philipmcgaw-cpi/CIB/620060_DIA10_V01.jpg

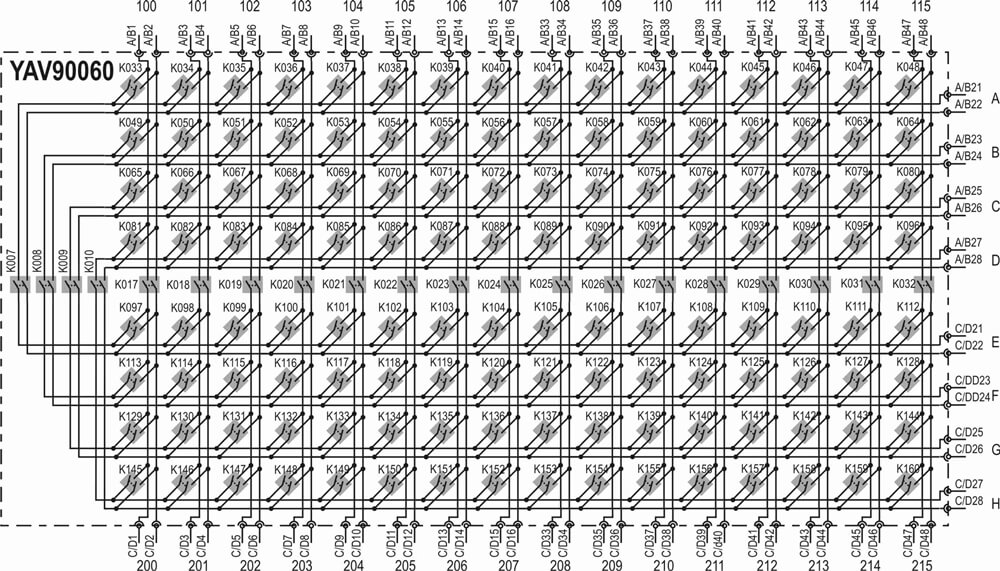
620060_DIA10_V01.jpg
