philipmcgaw-cpi/CIB/FDC_FCT_PVT_Specification_Diagrams - Top Level Block.jpeg

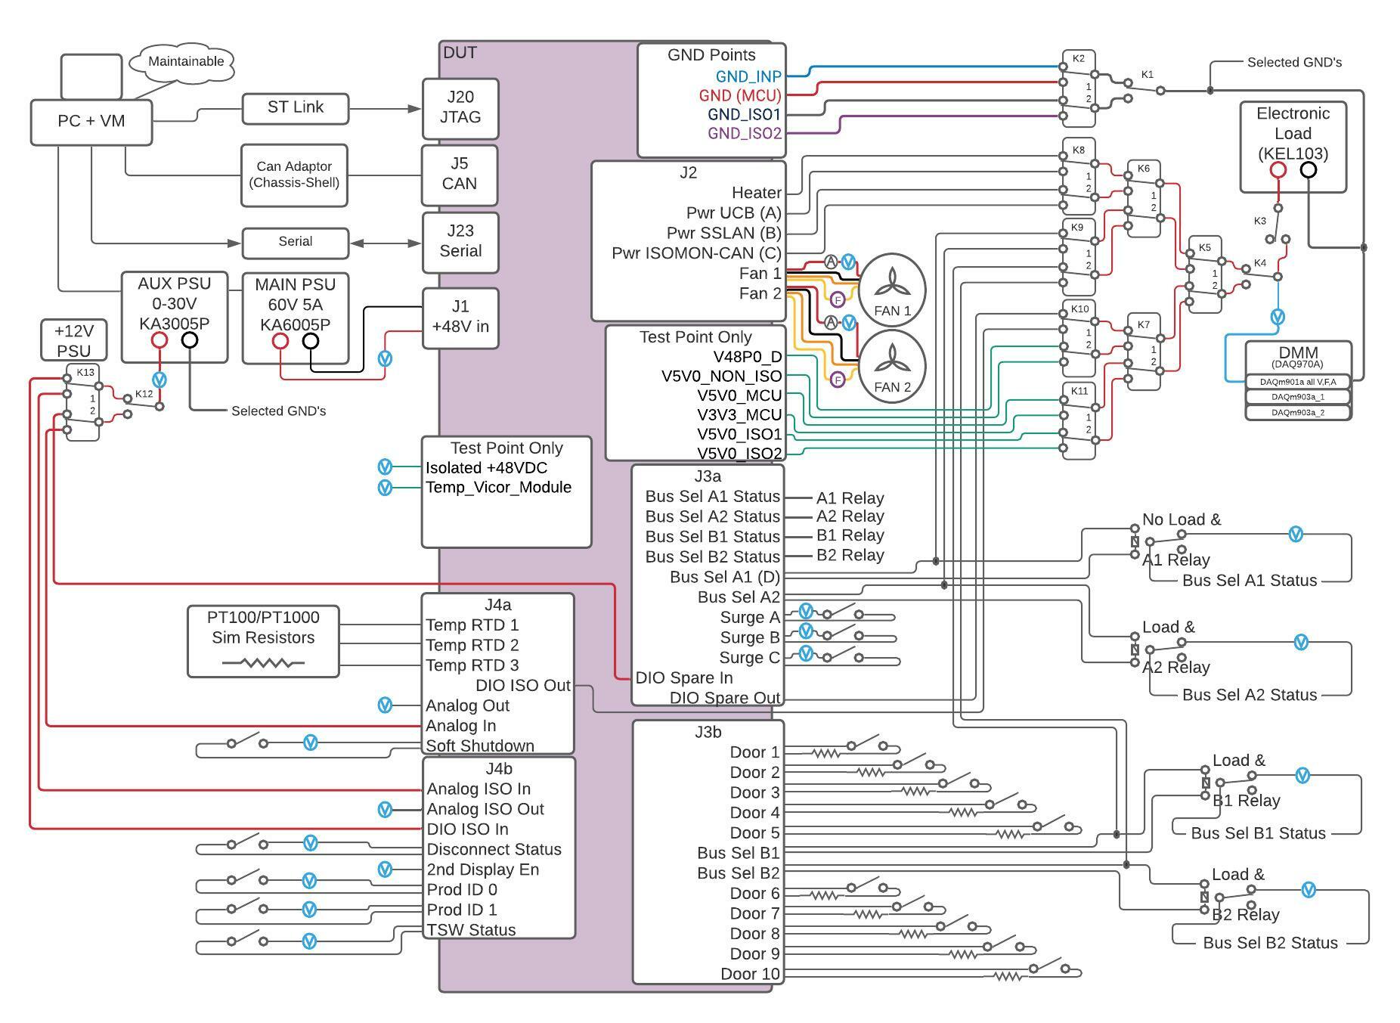
FDC_FCT_PVT_Specification_Diagrams - Top Level Block.jpeg
