philipmcgaw-cpi/CIB/CIB_Main_PCB - Mimic Octopus/Bom.xlsx

 | Manufacturer | Mfg part # | Digi-Key | Price approx | Quantitity |  | RS | Price Approx
12 Position headerblock, 5 mm pitch 90 degree PCB mount (20A) | Wurth | 691312710012 | 732-691312710012-ND | £1.78 | 8 | £14.24
12 Position headerblock, 5 mm pitch Screw terminal (20A) | Wurth | 691352710012 | 732-691352710012-ND | £5.23 | 8 | £41.84
12 Position Terminal Block Header, Male Pins, Shrouded (4 Side) 0.098" (2.50mm) 90°, Right Angle - Through Hole (12A) | Wurth | 691382010012 | 732-691382010012-ND | £2.87 |  | £0.00
12 Position Terminal Block Plug, Female Sockets 0.098" (2.50mm) - 180° Free Hanging (In-Line) (12A) | Wurth | 691381000012 | 732-691381000012-ND | £9.20 |  | £0.00
 |  |  |  |  |  | £0.00
LabJack OEM | LabJack |  |  | £500.00 | 1 | £500.00
 |  |  |  |  |  | £0.00
12V dc Coil Non-Latching Relay DPDT, 2A Switching Current PCB Mount, 2 Pole, HFD27/012-H | Hongfa Europe GMBH | HFD27/012-H |  |  |  | £0.00 | 176-2915 | £1.74
12V dc Coil Non-Latching Relay DPDT, 10A Switching Current Plug In, 2 Pole, MY2N 12DC(S) | Omron | MY2N 12DC(S) |  |  |  | £0.00 | 488-1954 | £6.60
 |  |  |  |  |  | £0.00
48V dc Coil Non-Latching Relay 4PDT, 6A Switching Current Plug In, 4 Pole, PT570048 8-1419111-1 | TE Connectivity | PT570048 8-1419111-1 |  |  |  | £0.00 | 334-0036 | £3.70
Relay Socket for use with PT5 Series 14 Pin, DIN Rail, 240V ac | TE Connectivity | PT78740 4-1415033-1 |  |  |  | £0.00 | 511-7018 | £7.25
 |  |  |  |  |  | £0.00
General Purpose Relay DPDT (2 Form C) 12VDC Coil Through Hole (2A) | CIT Relay and Switch | J104D2C12VDC.15S | 2449-J104D2C12VDC.15S-ND | £1.10 | 10 | £11.00
General Purpose Relay SPDT (1 Form C) 48VDC Coil Through Hole (12A) | CIT Relay and Switch | J107F1CS1248VDC.80 | 2449-J107F1CS1248VDC.80-ND | £1.30 | 4 | £5.20
 |  |  |  |  |  | £0.00
General Purpose Relay DPDT (2 Form C) 12VDC Coil Through Hole (16A) | Picker Components | PC375-2C-12S4-X | 2634-PC375-2C-12S4-X-ND | £2.40 | 20 | £48.00
 |  |  |  |  |  | £0.00
Bipolar (BJT) Transistor Array 8 NPN Darlington 50V 500mA - 2.25W Through Hole 18-DIP | STMicroelectronics | ULN2803A | 497-2356-5-ND | £2.58 |  | £0.00
I/O Expander 16 I²C 3.4 MHz 28-SPDIP | Microchip Technology | MCP23018-E/SP | MCP23018-E/SP-ND | £1.94 |  | £0.00
 |  |  |  |  |  | £0.00
Current Sensor 6A 1 Channel Hall Effect, Open Loop Bidirectional 16-PowerSOIC (0.295", 7.50mm Width), 10 Leads | LEM USA Inc | HMSR 6-SMS | 398-HMSR6-SMSCT-ND | £7.42 | 4 | £29.68
 |  |  |  |  |  | £0.00
General Purpose Relay DPDT (2 Form C) 12VDC Coil Through Hole (30A) | TE Connectivity | T92S11D12-12 | PB351-ND | £23.81 | 1 | £23.81
 |  |  |  |  |  | £649.96
