philipmcgaw-cpi/CIB/CIB_Main_PCB - Mimic Octopus/CIB_Main_PCB.csv

Source: | /Users/philipmcgaw/Documents/CIB/CIB_Main_PCB - Mimic Octopus/CIB_Main_PCB.kicad_sch
Date: | Thursday, 14 July 2022 at 15:01:47
Tool: | Eeschema (6.0.6-1)-1
Generator: | /Applications/KiCad/KiCad.app/Contents/SharedSupport/plugins/bom_csv_grouped_by_value.py
Component Count: | 592
Individual Components:
Item | Qty | Reference(s) | Value | LibPart | Footprint | Datasheet | Arrow Part Number | Arrow Price/Stock | Description | DigiKey # | DigiKey Price/Stock | Farnell # | Height | Manufacturer | Manufacturer # | Manufacturer_Name | Manufacturer_Part_Number | Mouser # | Mouser Part Number | Mouser Price/Stock | RS # | dnp
 |  | C1 | 100nF 60V | Device:C_Small | Capacitor_SMD:C_1206_3216Metric_Pad1.33x1.80mm_HandSolder | https://media.digikey.com/pdf/Data%20Sheets/Samsung%20PDFs/CL31B106KOHNNNE_Spec.pdf |  |  | 10 µF ±10% 16V Ceramic Capacitor X5R 1206 (3216 Metric) | 1276-1137-1-ND | https://www.digikey.co.uk/en/products/detail/samsung-electro-mechanics/CL31A106KOHNNNE/3886795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 |  |  | Samsung Electro-Mechanics | CL31A106KOHNNNE
 |  | C2 | 10uF 16 V | Device:C_Small | Capacitor_SMD:C_1206_3216Metric_Pad1.33x1.80mm_HandSolder | https://media.digikey.com/pdf/Data%20Sheets/Samsung%20PDFs/CL31B106KOHNNNE_Spec.pdf |  |  | 10 µF ±10% 16V Ceramic Capacitor X5R 1206 (3216 Metric) | 1276-1137-1-ND | https://www.digikey.co.uk/en/products/detail/samsung-electro-mechanics/CL31A106KOHNNNE/3886795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 |  |  | Samsung Electro-Mechanics | CL31A106KOHNNNE
 |  | C3 | 10uF 16 V | Device:C_Small | Capacitor_SMD:C_1206_3216Metric_Pad1.33x1.80mm_HandSolder | https://media.digikey.com/pdf/Data%20Sheets/Samsung%20PDFs/CL31B106KOHNNNE_Spec.pdf |  |  | 10 µF ±10% 16V Ceramic Capacitor X5R 1206 (3216 Metric) | 1276-1137-1-ND | https://www.digikey.co.uk/en/products/detail/samsung-electro-mechanics/CL31A106KOHNNNE/3886795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 |  |  | Samsung Electro-Mechanics | CL31A106KOHNNNE
 |  | C4 | 100nF 60V | Device:C_Small | Capacitor_SMD:C_1206_3216Metric_Pad1.33x1.80mm_HandSolder | https://media.digikey.com/pdf/Data%20Sheets/Samsung%20PDFs/CL31B106KOHNNNE_Spec.pdf |  |  | 10 µF ±10% 16V Ceramic Capacitor X5R 1206 (3216 Metric) | 1276-1137-1-ND | https://www.digikey.co.uk/en/products/detail/samsung-electro-mechanics/CL31A106KOHNNNE/3886795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 |  |  | Samsung Electro-Mechanics | CL31A106KOHNNNE
 |  | C5 | 100nF 60V | Device:C_Small | Capacitor_SMD:C_1206_3216Metric_Pad1.33x1.80mm_HandSolder | https://media.digikey.com/pdf/Data%20Sheets/Samsung%20PDFs/CL31B106KOHNNNE_Spec.pdf |  |  | 10 µF ±10% 16V Ceramic Capacitor X5R 1206 (3216 Metric) | 1276-1137-1-ND | https://www.digikey.co.uk/en/products/detail/samsung-electro-mechanics/CL31A106KOHNNNE/3886795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 |  |  | Samsung Electro-Mechanics | CL31A106KOHNNNE
 |  | C6 | 10uF 16 V | Device:C_Small | Capacitor_SMD:C_1206_3216Metric_Pad1.33x1.80mm_HandSolder | https://media.digikey.com/pdf/Data%20Sheets/Samsung%20PDFs/CL31B106KOHNNNE_Spec.pdf |  |  | 10 µF ±10% 16V Ceramic Capacitor X5R 1206 (3216 Metric) | 1276-1137-1-ND | https://www.digikey.co.uk/en/products/detail/samsung-electro-mechanics/CL31A106KOHNNNE/3886795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 |  |  | Samsung Electro-Mechanics | CL31A106KOHNNNE
 |  | C7 | 10uF 16 V | Device:C_Small | Capacitor_SMD:C_1206_3216Metric_Pad1.33x1.80mm_HandSolder | https://media.digikey.com/pdf/Data%20Sheets/Samsung%20PDFs/CL31B106KOHNNNE_Spec.pdf |  |  | 10 µF ±10% 16V Ceramic Capacitor X5R 1206 (3216 Metric) | 1276-1137-1-ND | https://www.digikey.co.uk/en/products/detail/samsung-electro-mechanics/CL31A106KOHNNNE/3886795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 |  |  | Samsung Electro-Mechanics | CL31A106KOHNNNE
 |  | C8 | 100nF 60V | Device:C_Small | Capacitor_SMD:C_1206_3216Metric_Pad1.33x1.80mm_HandSolder | https://media.digikey.com/pdf/Data%20Sheets/Samsung%20PDFs/CL31B106KOHNNNE_Spec.pdf |  |  | 10 µF ±10% 16V Ceramic Capacitor X5R 1206 (3216 Metric) | 1276-1137-1-ND | https://www.digikey.co.uk/en/products/detail/samsung-electro-mechanics/CL31A106KOHNNNE/3886795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 |  |  | Samsung Electro-Mechanics | CL31A106KOHNNNE
 |  | C9 | 10uF 16 V | Device:C_Small | Capacitor_SMD:C_1206_3216Metric_Pad1.33x1.80mm_HandSolder | https://media.digikey.com/pdf/Data%20Sheets/Samsung%20PDFs/CL31B106KOHNNNE_Spec.pdf |  |  | 10 µF ±10% 16V Ceramic Capacitor X5R 1206 (3216 Metric) | 1276-1137-1-ND | https://www.digikey.co.uk/en/products/detail/samsung-electro-mechanics/CL31A106KOHNNNE/3886795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 |  |  | Samsung Electro-Mechanics | CL31A106KOHNNNE
 |  | C10 | 22uF 16 V | Device:C_Small | Capacitor_SMD:C_1206_3216Metric_Pad1.33x1.80mm_HandSolder | https://media.digikey.com/pdf/Data%20Sheets/Samsung%20PDFs/CL31B106KOHNNNE_Spec.pdf |  |  | 22 µF ±20% 16V Ceramic Capacitor X5R 1206 (3216 Metric) | 1276-3048-1-ND | https://www.digikey.co.uk/en/products/detail/samsung-electro-mechanics/CL31A226KOHNNNE/3888706 |  |  | Samsung Electro-Mechanics
 |  | C11 | 10uF 16 V | Device:C_Small | Capacitor_SMD:C_1206_3216Metric_Pad1.33x1.80mm_HandSolder | https://media.digikey.com/pdf/Data%20Sheets/Samsung%20PDFs/CL31B106KOHNNNE_Spec.pdf |  |  | 10 µF ±10% 16V Ceramic Capacitor X5R 1206 (3216 Metric) | 1276-1137-1-ND | https://www.digikey.co.uk/en/products/detail/samsung-electro-mechanics/CL31A106KOHNNNE/3886795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 |  |  | Samsung Electro-Mechanics | CL31A106KOHNNNE
 |  | C12 | 22uF 16 V | Device:C_Small | Capacitor_SMD:C_1206_3216Metric_Pad1.33x1.80mm_HandSolder | https://media.digikey.com/pdf/Data%20Sheets/Samsung%20PDFs/CL31B106KOHNNNE_Spec.pdf |  |  | 22 µF ±20% 16V Ceramic Capacitor X5R 1206 (3216 Metric) | 1276-3048-1-ND | https://www.digikey.co.uk/en/products/detail/samsung-electro-mechanics/CL31A226KOHNNNE/3888706 |  |  | Samsung Electro-Mechanics
 |  | C13 | 10uF 16 V | Device:C_Small | Capacitor_SMD:C_1206_3216Metric_Pad1.33x1.80mm_HandSolder | https://media.digikey.com/pdf/Data%20Sheets/Samsung%20PDFs/CL31B106KOHNNNE_Spec.pdf |  |  | 10 µF ±10% 16V Ceramic Capacitor X5R 1206 (3216 Metric) | 1276-1137-1-ND | https://www.digikey.co.uk/en/products/detail/samsung-electro-mechanics/CL31A106KOHNNNE/3886795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 |  |  | Samsung Electro-Mechanics | CL31A106KOHNNNE
 |  | C14 | 22uF 16 V | Device:C_Small | Capacitor_SMD:C_1206_3216Metric_Pad1.33x1.80mm_HandSolder | https://media.digikey.com/pdf/Data%20Sheets/Samsung%20PDFs/CL31B106KOHNNNE_Spec.pdf |  |  | 22 µF ±20% 16V Ceramic Capacitor X5R 1206 (3216 Metric) | 1276-3048-1-ND | https://www.digikey.co.uk/en/products/detail/samsung-electro-mechanics/CL31A226KOHNNNE/3888706 |  |  | Samsung Electro-Mechanics
 |  | C15 | 470uF 20 V | Device:C_Polarized_Small | Capacitor_SMD:C_Elec_8x10.2 | https://industrial.panasonic.com/cdbs/www-data/pdf/AAB8000/AAB8000C226.pdf |  |  | 470 µF 20 V Aluminum - Polymer Capacitors Radial, Can - SMD 14mOhm 1000 Hrs @ 125°C | P124165CT-ND | https://www.digikey.co.uk/en/products/detail/panasonic-electronic-components/20SVPK470M/9765102 |  |  | Panasonic Electronic
 |  | C16 | 470uF 20 V | Device:C_Polarized_Small | Capacitor_SMD:C_Elec_8x10.2 | https://industrial.panasonic.com/cdbs/www-data/pdf/AAB8000/AAB8000C226.pdf |  |  | 470 µF 20 V Aluminum - Polymer Capacitors Radial, Can - SMD 14mOhm 1000 Hrs @ 125°C | P124165CT-ND | https://www.digikey.co.uk/en/products/detail/panasonic-electronic-components/20SVPK470M/9765102 |  |  | Panasonic Electronic
 |  | C17 | 470uF 20 V | Device:C_Polarized_Small | Capacitor_SMD:C_Elec_8x10.2 | https://industrial.panasonic.com/cdbs/www-data/pdf/AAB8000/AAB8000C226.pdf |  |  | 470 µF 20 V Aluminum - Polymer Capacitors Radial, Can - SMD 14mOhm 1000 Hrs @ 125°C | P124165CT-ND | https://www.digikey.co.uk/en/products/detail/panasonic-electronic-components/20SVPK470M/9765102 |  |  | Panasonic Electronic
 |  | C18 | 10uF 16 V | Device:C_Small | Capacitor_SMD:C_1206_3216Metric_Pad1.33x1.80mm_HandSolder | https://media.digikey.com/pdf/Data%20Sheets/Samsung%20PDFs/CL31B106KOHNNNE_Spec.pdf |  |  | 10 µF ±10% 16V Ceramic Capacitor X5R 1206 (3216 Metric) | 1276-1137-1-ND | https://www.digikey.co.uk/en/products/detail/samsung-electro-mechanics/CL31A106KOHNNNE/3886795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 |  |  | Samsung Electro-Mechanics | CL31A106KOHNNNE
 |  | C19 | 10uF 16 V | Device:C_Small | Capacitor_SMD:C_1206_3216Metric_Pad1.33x1.80mm_HandSolder | https://media.digikey.com/pdf/Data%20Sheets/Samsung%20PDFs/CL31B106KOHNNNE_Spec.pdf |  |  | 10 µF ±10% 16V Ceramic Capacitor X5R 1206 (3216 Metric) | 1276-1137-1-ND | https://www.digikey.co.uk/en/products/detail/samsung-electro-mechanics/CL31A106KOHNNNE/3886795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 |  |  | Samsung Electro-Mechanics | CL31A106KOHNNNE
 |  | C20 | 100uF 25 V | Device:C_Polarized_Small | Capacitor_SMD:C_Elec_8x10.2 | https://industrial.panasonic.com/ww/products/pt/os-con/models/25SVPF100M |  |  | 100 µF 25 V Aluminum - Polymer Capacitors Radial, Can - SMD 24mOhm 5000 Hrs @ 105°C | P123675CT-ND | https://www.digikey.co.uk/en/products/detail/panasonic-electronic-components/25SVPF100M/4209272 |  |  | Panasonic Electronic
 |  | C21 | 10uF 16 V | Device:C_Small | Capacitor_SMD:C_1206_3216Metric_Pad1.33x1.80mm_HandSolder | https://media.digikey.com/pdf/Data%20Sheets/Samsung%20PDFs/CL31B106KOHNNNE_Spec.pdf |  |  | 10 µF ±10% 16V Ceramic Capacitor X5R 1206 (3216 Metric) | 1276-1137-1-ND | https://www.digikey.co.uk/en/products/detail/samsung-electro-mechanics/CL31A106KOHNNNE/3886795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 |  |  | Samsung Electro-Mechanics | CL31A106KOHNNNE
 |  | C22 | 22uF 16 V | Device:C_Small | Capacitor_SMD:C_1206_3216Metric_Pad1.33x1.80mm_HandSolder | https://media.digikey.com/pdf/Data%20Sheets/Samsung%20PDFs/CL31B106KOHNNNE_Spec.pdf |  |  | 22 µF ±20% 16V Ceramic Capacitor X5R 1206 (3216 Metric) | 1276-3048-1-ND | https://www.digikey.co.uk/en/products/detail/samsung-electro-mechanics/CL31A226KOHNNNE/3888706 |  |  | Samsung Electro-Mechanics
 |  | C23 | 10uF 16 V | Device:C_Small | Capacitor_SMD:C_1206_3216Metric_Pad1.33x1.80mm_HandSolder | https://media.digikey.com/pdf/Data%20Sheets/Samsung%20PDFs/CL31B106KOHNNNE_Spec.pdf |  |  | 10 µF ±10% 16V Ceramic Capacitor X5R 1206 (3216 Metric) | 1276-1137-1-ND | https://www.digikey.co.uk/en/products/detail/samsung-electro-mechanics/CL31A106KOHNNNE/3886795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 |  |  | Samsung Electro-Mechanics | CL31A106KOHNNNE
 |  | C24 | 22uF 16 V | Device:C_Small | Capacitor_SMD:C_1206_3216Metric_Pad1.33x1.80mm_HandSolder | https://media.digikey.com/pdf/Data%20Sheets/Samsung%20PDFs/CL31B106KOHNNNE_Spec.pdf |  |  | 22 µF ±20% 16V Ceramic Capacitor X5R 1206 (3216 Metric) | 1276-3048-1-ND | https://www.digikey.co.uk/en/products/detail/samsung-electro-mechanics/CL31A226KOHNNNE/3888706 |  |  | Samsung Electro-Mechanics
 |  | C25 | 470uF 20 V | Device:C_Polarized_Small | Capacitor_SMD:C_Elec_8x10.2 | https://industrial.panasonic.com/cdbs/www-data/pdf/AAB8000/AAB8000C226.pdf |  |  | 470 µF 20 V Aluminum - Polymer Capacitors Radial, Can - SMD 14mOhm 1000 Hrs @ 125°C | P124165CT-ND | https://www.digikey.co.uk/en/products/detail/panasonic-electronic-components/20SVPK470M/9765102 |  |  | Panasonic Electronic
 |  | C26 | 470uF 20 V | Device:C_Polarized_Small | Capacitor_SMD:C_Elec_8x10.2 | https://industrial.panasonic.com/cdbs/www-data/pdf/AAB8000/AAB8000C226.pdf |  |  | 470 µF 20 V Aluminum - Polymer Capacitors Radial, Can - SMD 14mOhm 1000 Hrs @ 125°C | P124165CT-ND | https://www.digikey.co.uk/en/products/detail/panasonic-electronic-components/20SVPK470M/9765102 |  |  | Panasonic Electronic
 |  | C27 | 470uF 20 V | Device:C_Polarized_Small | Capacitor_SMD:C_Elec_8x10.2 | https://industrial.panasonic.com/cdbs/www-data/pdf/AAB8000/AAB8000C226.pdf |  |  | 470 µF 20 V Aluminum - Polymer Capacitors Radial, Can - SMD 14mOhm 1000 Hrs @ 125°C | P124165CT-ND | https://www.digikey.co.uk/en/products/detail/panasonic-electronic-components/20SVPK470M/9765102 |  |  | Panasonic Electronic
 |  | C28 | 10uF 16 V | Device:C_Small | Capacitor_SMD:C_1206_3216Metric_Pad1.33x1.80mm_HandSolder | https://media.digikey.com/pdf/Data%20Sheets/Samsung%20PDFs/CL31B106KOHNNNE_Spec.pdf |  |  | 10 µF ±10% 16V Ceramic Capacitor X5R 1206 (3216 Metric) | 1276-1137-1-ND | https://www.digikey.co.uk/en/products/detail/samsung-electro-mechanics/CL31A106KOHNNNE/3886795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 |  |  | Samsung Electro-Mechanics | CL31A106KOHNNNE
 |  | C29 | 22uF 16 V | Device:C_Small | Capacitor_SMD:C_1206_3216Metric_Pad1.33x1.80mm_HandSolder | https://media.digikey.com/pdf/Data%20Sheets/Samsung%20PDFs/CL31B106KOHNNNE_Spec.pdf |  |  | 22 µF ±20% 16V Ceramic Capacitor X5R 1206 (3216 Metric) | 1276-3048-1-ND | https://www.digikey.co.uk/en/products/detail/samsung-electro-mechanics/CL31A226KOHNNNE/3888706 |  |  | Samsung Electro-Mechanics
 |  | C30 | 10uF 16 V | Device:C_Small | Capacitor_SMD:C_1206_3216Metric_Pad1.33x1.80mm_HandSolder | https://media.digikey.com/pdf/Data%20Sheets/Samsung%20PDFs/CL31B106KOHNNNE_Spec.pdf |  |  | 10 µF ±10% 16V Ceramic Capacitor X5R 1206 (3216 Metric) | 1276-1137-1-ND | https://www.digikey.co.uk/en/products/detail/samsung-electro-mechanics/CL31A106KOHNNNE/3886795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 |  |  | Samsung Electro-Mechanics | CL31A106KOHNNNE
 |  | C31 | 22uF 16 V | Device:C_Small | Capacitor_SMD:C_1206_3216Metric_Pad1.33x1.80mm_HandSolder | https://media.digikey.com/pdf/Data%20Sheets/Samsung%20PDFs/CL31B106KOHNNNE_Spec.pdf |  |  | 22 µF ±20% 16V Ceramic Capacitor X5R 1206 (3216 Metric) | 1276-3048-1-ND | https://www.digikey.co.uk/en/products/detail/samsung-electro-mechanics/CL31A226KOHNNNE/3888706 |  |  | Samsung Electro-Mechanics
 |  | C32 | 10uF 16 V | Device:C_Small | Capacitor_SMD:C_1206_3216Metric_Pad1.33x1.80mm_HandSolder | https://media.digikey.com/pdf/Data%20Sheets/Samsung%20PDFs/CL31B106KOHNNNE_Spec.pdf |  |  | 10 µF ±10% 16V Ceramic Capacitor X5R 1206 (3216 Metric) | 1276-1137-1-ND | https://www.digikey.co.uk/en/products/detail/samsung-electro-mechanics/CL31A106KOHNNNE/3886795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 |  |  | Samsung Electro-Mechanics | CL31A106KOHNNNE
 |  | C33 | 22uF 16 V | Device:C_Small | Capacitor_SMD:C_1206_3216Metric_Pad1.33x1.80mm_HandSolder | https://media.digikey.com/pdf/Data%20Sheets/Samsung%20PDFs/CL31B106KOHNNNE_Spec.pdf |  |  | 22 µF ±20% 16V Ceramic Capacitor X5R 1206 (3216 Metric) | 1276-3048-1-ND | https://www.digikey.co.uk/en/products/detail/samsung-electro-mechanics/CL31A226KOHNNNE/3888706 |  |  | Samsung Electro-Mechanics
 |  | C34 | 10uF 16 V | Device:C_Small | Capacitor_SMD:C_1206_3216Metric_Pad1.33x1.80mm_HandSolder | https://media.digikey.com/pdf/Data%20Sheets/Samsung%20PDFs/CL31B106KOHNNNE_Spec.pdf |  |  | 10 µF ±10% 16V Ceramic Capacitor X5R 1206 (3216 Metric) | 1276-1137-1-ND | https://www.digikey.co.uk/en/products/detail/samsung-electro-mechanics/CL31A106KOHNNNE/3886795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 |  |  | Samsung Electro-Mechanics | CL31A106KOHNNNE
 |  | C35 | 22uF 16 V | Device:C_Small | Capacitor_SMD:C_1206_3216Metric_Pad1.33x1.80mm_HandSolder | https://media.digikey.com/pdf/Data%20Sheets/Samsung%20PDFs/CL31B106KOHNNNE_Spec.pdf |  |  | 22 µF ±20% 16V Ceramic Capacitor X5R 1206 (3216 Metric) | 1276-3048-1-ND | https://www.digikey.co.uk/en/products/detail/samsung-electro-mechanics/CL31A226KOHNNNE/3888706 |  |  | Samsung Electro-Mechanics
 |  | C36 | 10uF 16 V | Device:C_Small | Capacitor_SMD:C_1206_3216Metric_Pad1.33x1.80mm_HandSolder | https://media.digikey.com/pdf/Data%20Sheets/Samsung%20PDFs/CL31B106KOHNNNE_Spec.pdf |  |  | 10 µF ±10% 16V Ceramic Capacitor X5R 1206 (3216 Metric) | 1276-1137-1-ND | https://www.digikey.co.uk/en/products/detail/samsung-electro-mechanics/CL31A106KOHNNNE/3886795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 |  |  | Samsung Electro-Mechanics | CL31A106KOHNNNE
 |  | C37 | 22uF 16 V | Device:C_Small | Capacitor_SMD:C_1206_3216Metric_Pad1.33x1.80mm_HandSolder | https://media.digikey.com/pdf/Data%20Sheets/Samsung%20PDFs/CL31B106KOHNNNE_Spec.pdf |  |  | 22 µF ±20% 16V Ceramic Capacitor X5R 1206 (3216 Metric) | 1276-3048-1-ND | https://www.digikey.co.uk/en/products/detail/samsung-electro-mechanics/CL31A226KOHNNNE/3888706 |  |  | Samsung Electro-Mechanics
 |  | C38 | 10uF 16 V | Device:C_Small | Capacitor_SMD:C_1206_3216Metric_Pad1.33x1.80mm_HandSolder | https://media.digikey.com/pdf/Data%20Sheets/Samsung%20PDFs/CL31B106KOHNNNE_Spec.pdf |  |  | 10 µF ±10% 16V Ceramic Capacitor X5R 1206 (3216 Metric) | 1276-1137-1-ND | https://www.digikey.co.uk/en/products/detail/samsung-electro-mechanics/CL31A106KOHNNNE/3886795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 |  |  | Samsung Electro-Mechanics | CL31A106KOHNNNE
 |  | C39 | 22uF 16 V | Device:C_Small | Capacitor_SMD:C_1206_3216Metric_Pad1.33x1.80mm_HandSolder | https://media.digikey.com/pdf/Data%20Sheets/Samsung%20PDFs/CL31B106KOHNNNE_Spec.pdf |  |  | 22 µF ±20% 16V Ceramic Capacitor X5R 1206 (3216 Metric) | 1276-3048-1-ND | https://www.digikey.co.uk/en/products/detail/samsung-electro-mechanics/CL31A226KOHNNNE/3888706 |  |  | Samsung Electro-Mechanics
 |  | C40 | 10uF 16 V | Device:C_Small | Capacitor_SMD:C_1206_3216Metric_Pad1.33x1.80mm_HandSolder | https://media.digikey.com/pdf/Data%20Sheets/Samsung%20PDFs/CL31B106KOHNNNE_Spec.pdf |  |  | 10 µF ±10% 16V Ceramic Capacitor X5R 1206 (3216 Metric) | 1276-1137-1-ND | https://www.digikey.co.uk/en/products/detail/samsung-electro-mechanics/CL31A106KOHNNNE/3886795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 |  |  | Samsung Electro-Mechanics | CL31A106KOHNNNE
 |  | C41 | 22uF 16 V | Device:C_Small | Capacitor_SMD:C_1206_3216Metric_Pad1.33x1.80mm_HandSolder | https://media.digikey.com/pdf/Data%20Sheets/Samsung%20PDFs/CL31B106KOHNNNE_Spec.pdf |  |  | 22 µF ±20% 16V Ceramic Capacitor X5R 1206 (3216 Metric) | 1276-3048-1-ND | https://www.digikey.co.uk/en/products/detail/samsung-electro-mechanics/CL31A226KOHNNNE/3888706 |  |  | Samsung Electro-Mechanics
 |  | C42 | 10uF 16 V | Device:C_Small | Capacitor_SMD:C_1206_3216Metric_Pad1.33x1.80mm_HandSolder | https://media.digikey.com/pdf/Data%20Sheets/Samsung%20PDFs/CL31B106KOHNNNE_Spec.pdf |  |  | 10 µF ±10% 16V Ceramic Capacitor X5R 1206 (3216 Metric) | 1276-1137-1-ND | https://www.digikey.co.uk/en/products/detail/samsung-electro-mechanics/CL31A106KOHNNNE/3886795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 |  |  | Samsung Electro-Mechanics | CL31A106KOHNNNE
 |  | C43 | 22uF 16 V | Device:C_Small | Capacitor_SMD:C_1206_3216Metric_Pad1.33x1.80mm_HandSolder | https://media.digikey.com/pdf/Data%20Sheets/Samsung%20PDFs/CL31B106KOHNNNE_Spec.pdf |  |  | 22 µF ±20% 16V Ceramic Capacitor X5R 1206 (3216 Metric) | 1276-3048-1-ND | https://www.digikey.co.uk/en/products/detail/samsung-electro-mechanics/CL31A226KOHNNNE/3888706 |  |  | Samsung Electro-Mechanics
 |  | C44 | 10uF 16 V | Device:C_Small | Capacitor_SMD:C_1206_3216Metric_Pad1.33x1.80mm_HandSolder | https://media.digikey.com/pdf/Data%20Sheets/Samsung%20PDFs/CL31B106KOHNNNE_Spec.pdf |  |  | 10 µF ±10% 16V Ceramic Capacitor X5R 1206 (3216 Metric) | 1276-1137-1-ND | https://www.digikey.co.uk/en/products/detail/samsung-electro-mechanics/CL31A106KOHNNNE/3886795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 |  |  | Samsung Electro-Mechanics | CL31A106KOHNNNE
 |  | C45 | 22uF 16 V | Device:C_Small | Capacitor_SMD:C_1206_3216Metric_Pad1.33x1.80mm_HandSolder | https://media.digikey.com/pdf/Data%20Sheets/Samsung%20PDFs/CL31B106KOHNNNE_Spec.pdf |  |  | 22 µF ±20% 16V Ceramic Capacitor X5R 1206 (3216 Metric) | 1276-3048-1-ND | https://www.digikey.co.uk/en/products/detail/samsung-electro-mechanics/CL31A226KOHNNNE/3888706 |  |  | Samsung Electro-Mechanics
 |  | C46 | 10uF 16 V | Device:C_Small | Capacitor_SMD:C_1206_3216Metric_Pad1.33x1.80mm_HandSolder | https://media.digikey.com/pdf/Data%20Sheets/Samsung%20PDFs/CL31B106KOHNNNE_Spec.pdf |  |  | 10 µF ±10% 16V Ceramic Capacitor X5R 1206 (3216 Metric) | 1276-1137-1-ND | https://www.digikey.co.uk/en/products/detail/samsung-electro-mechanics/CL31A106KOHNNNE/3886795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 |  |  | Samsung Electro-Mechanics | CL31A106KOHNNNE
 |  | C47 | 22uF 16 V | Device:C_Small | Capacitor_SMD:C_1206_3216Metric_Pad1.33x1.80mm_HandSolder | https://media.digikey.com/pdf/Data%20Sheets/Samsung%20PDFs/CL31B106KOHNNNE_Spec.pdf |  |  | 22 µF ±20% 16V Ceramic Capacitor X5R 1206 (3216 Metric) | 1276-3048-1-ND | https://www.digikey.co.uk/en/products/detail/samsung-electro-mechanics/CL31A226KOHNNNE/3888706 |  |  | Samsung Electro-Mechanics
 |  | C48 | 10uF 16 V | Device:C_Small | Capacitor_SMD:C_1206_3216Metric_Pad1.33x1.80mm_HandSolder | https://media.digikey.com/pdf/Data%20Sheets/Samsung%20PDFs/CL31B106KOHNNNE_Spec.pdf |  |  | 10 µF ±10% 16V Ceramic Capacitor X5R 1206 (3216 Metric) | 1276-1137-1-ND | https://www.digikey.co.uk/en/products/detail/samsung-electro-mechanics/CL31A106KOHNNNE/3886795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 |  |  | Samsung Electro-Mechanics | CL31A106KOHNNNE
 |  | C49 | 22uF 16 V | Device:C_Small | Capacitor_SMD:C_1206_3216Metric_Pad1.33x1.80mm_HandSolder | https://media.digikey.com/pdf/Data%20Sheets/Samsung%20PDFs/CL31B106KOHNNNE_Spec.pdf |  |  | 22 µF ±20% 16V Ceramic Capacitor X5R 1206 (3216 Metric) | 1276-3048-1-ND | https://www.digikey.co.uk/en/products/detail/samsung-electro-mechanics/CL31A226KOHNNNE/3888706 |  |  | Samsung Electro-Mechanics
 |  | C50 | 10uF 16 V | Device:C_Small | Capacitor_SMD:C_1206_3216Metric_Pad1.33x1.80mm_HandSolder | https://media.digikey.com/pdf/Data%20Sheets/Samsung%20PDFs/CL31B106KOHNNNE_Spec.pdf |  |  | 10 µF ±10% 16V Ceramic Capacitor X5R 1206 (3216 Metric) | 1276-1137-1-ND | https://www.digikey.co.uk/en/products/detail/samsung-electro-mechanics/CL31A106KOHNNNE/3886795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 |  |  | Samsung Electro-Mechanics | CL31A106KOHNNNE
 |  | C51 | 22uF 16 V | Device:C_Small | Capacitor_SMD:C_1206_3216Metric_Pad1.33x1.80mm_HandSolder | https://media.digikey.com/pdf/Data%20Sheets/Samsung%20PDFs/CL31B106KOHNNNE_Spec.pdf |  |  | 22 µF ±20% 16V Ceramic Capacitor X5R 1206 (3216 Metric) | 1276-3048-1-ND | https://www.digikey.co.uk/en/products/detail/samsung-electro-mechanics/CL31A226KOHNNNE/3888706 |  |  | Samsung Electro-Mechanics
 |  | C52 | 10uF 16 V | Device:C_Small | Capacitor_SMD:C_1206_3216Metric_Pad1.33x1.80mm_HandSolder | https://media.digikey.com/pdf/Data%20Sheets/Samsung%20PDFs/CL31B106KOHNNNE_Spec.pdf |  |  | 10 µF ±10% 16V Ceramic Capacitor X5R 1206 (3216 Metric) | 1276-1137-1-ND | https://www.digikey.co.uk/en/products/detail/samsung-electro-mechanics/CL31A106KOHNNNE/3886795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 |  |  | Samsung Electro-Mechanics | CL31A106KOHNNNE
 |  | C53 | 22uF 16 V | Device:C_Small | Capacitor_SMD:C_1206_3216Metric_Pad1.33x1.80mm_HandSolder | https://media.digikey.com/pdf/Data%20Sheets/Samsung%20PDFs/CL31B106KOHNNNE_Spec.pdf |  |  | 22 µF ±20% 16V Ceramic Capacitor X5R 1206 (3216 Metric) | 1276-3048-1-ND | https://www.digikey.co.uk/en/products/detail/samsung-electro-mechanics/CL31A226KOHNNNE/3888706 |  |  | Samsung Electro-Mechanics
 |  | C54 | 10uF 16 V | Device:C_Small | Capacitor_SMD:C_1206_3216Metric_Pad1.33x1.80mm_HandSolder | https://media.digikey.com/pdf/Data%20Sheets/Samsung%20PDFs/CL31B106KOHNNNE_Spec.pdf |  |  | 10 µF ±10% 16V Ceramic Capacitor X5R 1206 (3216 Metric) | 1276-1137-1-ND | https://www.digikey.co.uk/en/products/detail/samsung-electro-mechanics/CL31A106KOHNNNE/3886795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 |  |  | Samsung Electro-Mechanics | CL31A106KOHNNNE
 |  | C55 | 22uF 16 V | Device:C_Small | Capacitor_SMD:C_1206_3216Metric_Pad1.33x1.80mm_HandSolder | https://media.digikey.com/pdf/Data%20Sheets/Samsung%20PDFs/CL31B106KOHNNNE_Spec.pdf |  |  | 22 µF ±20% 16V Ceramic Capacitor X5R 1206 (3216 Metric) | 1276-3048-1-ND | https://www.digikey.co.uk/en/products/detail/samsung-electro-mechanics/CL31A226KOHNNNE/3888706 |  |  | Samsung Electro-Mechanics
 |  | C56 | 10uF 16 V | Device:C_Small | Capacitor_SMD:C_1206_3216Metric_Pad1.33x1.80mm_HandSolder | https://media.digikey.com/pdf/Data%20Sheets/Samsung%20PDFs/CL31B106KOHNNNE_Spec.pdf |  |  | 10 µF ±10% 16V Ceramic Capacitor X5R 1206 (3216 Metric) | 1276-1137-1-ND | https://www.digikey.co.uk/en/products/detail/samsung-electro-mechanics/CL31A106KOHNNNE/3886795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 |  |  | Samsung Electro-Mechanics | CL31A106KOHNNNE
 |  | C57 | 10uF 16 V | Device:C_Small | Capacitor_SMD:C_1206_3216Metric_Pad1.33x1.80mm_HandSolder | https://media.digikey.com/pdf/Data%20Sheets/Samsung%20PDFs/CL31B106KOHNNNE_Spec.pdf |  |  | 10 µF ±10% 16V Ceramic Capacitor X5R 1206 (3216 Metric) | 1276-1137-1-ND | https://www.digikey.co.uk/en/products/detail/samsung-electro-mechanics/CL31A106KOHNNNE/3886795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 |  |  | Samsung Electro-Mechanics | CL31A106KOHNNNE
 |  | C58 | 22uF 16 V | Device:C_Small | Capacitor_SMD:C_1206_3216Metric_Pad1.33x1.80mm_HandSolder | https://media.digikey.com/pdf/Data%20Sheets/Samsung%20PDFs/CL31B106KOHNNNE_Spec.pdf |  |  | 22 µF ±20% 16V Ceramic Capacitor X5R 1206 (3216 Metric) | 1276-3048-1-ND | https://www.digikey.co.uk/en/products/detail/samsung-electro-mechanics/CL31A226KOHNNNE/3888706 |  |  | Samsung Electro-Mechanics
 |  | C59 | 10uF 16 V | Device:C_Small | Capacitor_SMD:C_1206_3216Metric_Pad1.33x1.80mm_HandSolder | https://media.digikey.com/pdf/Data%20Sheets/Samsung%20PDFs/CL31B106KOHNNNE_Spec.pdf |  |  | 10 µF ±10% 16V Ceramic Capacitor X5R 1206 (3216 Metric) | 1276-1137-1-ND | https://www.digikey.co.uk/en/products/detail/samsung-electro-mechanics/CL31A106KOHNNNE/3886795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 |  |  | Samsung Electro-Mechanics | CL31A106KOHNNNE
 |  | C60 | 10uF 16 V | Device:C_Small | Capacitor_SMD:C_1206_3216Metric_Pad1.33x1.80mm_HandSolder | https://media.digikey.com/pdf/Data%20Sheets/Samsung%20PDFs/CL31B106KOHNNNE_Spec.pdf |  |  | 10 µF ±10% 16V Ceramic Capacitor X5R 1206 (3216 Metric) | 1276-1137-1-ND | https://www.digikey.co.uk/en/products/detail/samsung-electro-mechanics/CL31A106KOHNNNE/3886795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 |  |  | Samsung Electro-Mechanics | CL31A106KOHNNNE
 |  | C61 | 10uF 16 V | Device:C_Small | Capacitor_SMD:C_1206_3216Metric_Pad1.33x1.80mm_HandSolder | https://media.digikey.com/pdf/Data%20Sheets/Samsung%20PDFs/CL31B106KOHNNNE_Spec.pdf |  |  | 10 µF ±10% 16V Ceramic Capacitor X5R 1206 (3216 Metric) | 1276-1137-1-ND | https://www.digikey.co.uk/en/products/detail/samsung-electro-mechanics/CL31A106KOHNNNE/3886795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 |  |  | Samsung Electro-Mechanics | CL31A106KOHNNNE
 |  | C62 | 22uF 16 V | Device:C_Small | Capacitor_SMD:C_1206_3216Metric_Pad1.33x1.80mm_HandSolder | https://media.digikey.com/pdf/Data%20Sheets/Samsung%20PDFs/CL31B106KOHNNNE_Spec.pdf |  |  | 22 µF ±20% 16V Ceramic Capacitor X5R 1206 (3216 Metric) | 1276-3048-1-ND | https://www.digikey.co.uk/en/products/detail/samsung-electro-mechanics/CL31A226KOHNNNE/3888706 |  |  | Samsung Electro-Mechanics
 |  | C63 | 10uF 16 V | Device:C_Small | Capacitor_SMD:C_1206_3216Metric_Pad1.33x1.80mm_HandSolder | https://media.digikey.com/pdf/Data%20Sheets/Samsung%20PDFs/CL31B106KOHNNNE_Spec.pdf |  |  | 10 µF ±10% 16V Ceramic Capacitor X5R 1206 (3216 Metric) | 1276-1137-1-ND | https://www.digikey.co.uk/en/products/detail/samsung-electro-mechanics/CL31A106KOHNNNE/3886795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 |  |  | Samsung Electro-Mechanics | CL31A106KOHNNNE
 |  | C64 | 10uF 16 V | Device:C_Small | Capacitor_SMD:C_1206_3216Metric_Pad1.33x1.80mm_HandSolder | https://media.digikey.com/pdf/Data%20Sheets/Samsung%20PDFs/CL31B106KOHNNNE_Spec.pdf |  |  | 10 µF ±10% 16V Ceramic Capacitor X5R 1206 (3216 Metric) | 1276-1137-1-ND | https://www.digikey.co.uk/en/products/detail/samsung-electro-mechanics/CL31A106KOHNNNE/3886795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 |  |  | Samsung Electro-Mechanics | CL31A106KOHNNNE
 |  | C65 | 10uF 16 V | Device:C_Small | Capacitor_SMD:C_1206_3216Metric_Pad1.33x1.80mm_HandSolder | https://media.digikey.com/pdf/Data%20Sheets/Samsung%20PDFs/CL31B106KOHNNNE_Spec.pdf |  |  | 10 µF ±10% 16V Ceramic Capacitor X5R 1206 (3216 Metric) | 1276-1137-1-ND | https://www.digikey.co.uk/en/products/detail/samsung-electro-mechanics/CL31A106KOHNNNE/3886795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 |  |  | Samsung Electro-Mechanics | CL31A106KOHNNNE
 |  | C66 | 22uF 16 V | Device:C_Small | Capacitor_SMD:C_1206_3216Metric_Pad1.33x1.80mm_HandSolder | https://media.digikey.com/pdf/Data%20Sheets/Samsung%20PDFs/CL31B106KOHNNNE_Spec.pdf |  |  | 22 µF ±20% 16V Ceramic Capacitor X5R 1206 (3216 Metric) | 1276-3048-1-ND | https://www.digikey.co.uk/en/products/detail/samsung-electro-mechanics/CL31A226KOHNNNE/3888706 |  |  | Samsung Electro-Mechanics
 |  | C67 | 10uF 16 V | Device:C_Small | Capacitor_SMD:C_1206_3216Metric_Pad1.33x1.80mm_HandSolder | https://media.digikey.com/pdf/Data%20Sheets/Samsung%20PDFs/CL31B106KOHNNNE_Spec.pdf |  |  | 10 µF ±10% 16V Ceramic Capacitor X5R 1206 (3216 Metric) | 1276-1137-1-ND | https://www.digikey.co.uk/en/products/detail/samsung-electro-mechanics/CL31A106KOHNNNE/3886795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 |  |  | Samsung Electro-Mechanics | CL31A106KOHNNNE
 |  | C68 | 10uF 16 V | Device:C_Small | Capacitor_SMD:C_1206_3216Metric_Pad1.33x1.80mm_HandSolder | https://media.digikey.com/pdf/Data%20Sheets/Samsung%20PDFs/CL31B106KOHNNNE_Spec.pdf |  |  | 10 µF ±10% 16V Ceramic Capacitor X5R 1206 (3216 Metric) | 1276-1137-1-ND | https://www.digikey.co.uk/en/products/detail/samsung-electro-mechanics/CL31A106KOHNNNE/3886795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 |  |  | Samsung Electro-Mechanics | CL31A106KOHNNNE
 |  | C69 | 10uF 16 V | Device:C_Small | Capacitor_SMD:C_1206_3216Metric_Pad1.33x1.80mm_HandSolder | https://media.digikey.com/pdf/Data%20Sheets/Samsung%20PDFs/CL31B106KOHNNNE_Spec.pdf |  |  | 10 µF ±10% 16V Ceramic Capacitor X5R 1206 (3216 Metric) | 1276-1137-1-ND | https://www.digikey.co.uk/en/products/detail/samsung-electro-mechanics/CL31A106KOHNNNE/3886795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 |  |  | Samsung Electro-Mechanics | CL31A106KOHNNNE
 |  | C70 | 22uF 16 V | Device:C_Small | Capacitor_SMD:C_1206_3216Metric_Pad1.33x1.80mm_HandSolder | https://media.digikey.com/pdf/Data%20Sheets/Samsung%20PDFs/CL31B106KOHNNNE_Spec.pdf |  |  | 22 µF ±20% 16V Ceramic Capacitor X5R 1206 (3216 Metric) | 1276-3048-1-ND | https://www.digikey.co.uk/en/products/detail/samsung-electro-mechanics/CL31A226KOHNNNE/3888706 |  |  | Samsung Electro-Mechanics
 |  | C71 | 10uF 16 V | Device:C_Small | Capacitor_SMD:C_1206_3216Metric_Pad1.33x1.80mm_HandSolder | https://media.digikey.com/pdf/Data%20Sheets/Samsung%20PDFs/CL31B106KOHNNNE_Spec.pdf |  |  | 10 µF ±10% 16V Ceramic Capacitor X5R 1206 (3216 Metric) | 1276-1137-1-ND | https://www.digikey.co.uk/en/products/detail/samsung-electro-mechanics/CL31A106KOHNNNE/3886795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 |  |  | Samsung Electro-Mechanics | CL31A106KOHNNNE
 |  | D1 | 56V | Device:D_Zener_Small_Filled | Diode_SMD:D_SMB_Handsoldering | https://www.comchiptech.com/admin/files/product/CZRB5338B-HF%20Thru111480.%20CZRB5388B-HF%20RevA.pdf |  |  | Zener Diode 56 V 5 W ±5% Surface Mount DO-214AA (SMB) | 641-1818-1-ND | https://www.digikey.co.uk/en/products/detail/comchip-technology/CZRB5370B-HF/6138929 |  |  | Comchip Technology | CZRB5370B-HF
 |  | D2 | Green | Device:LED_Small_Filled | Diode_SMD:D_1206_3216Metric_Pad1.42x1.75mm_HandSolder | https://www.we-online.com/katalog/datasheet/150080VS75000.pdf |  |  | Green 570nm LED Indication - Discrete 2V 1206 (3216 Metric) | 732-4993-1-ND | https://www.digikey.co.uk/en/products/detail/w%C3%BCrth-elektronik/150120VS75000/4489945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 |  |  | Würth Elektronik | 150120VS75000 |  |  |  |  |  | 8154237P
 |  | D3 | 56V | Device:D_Zener_Small_Filled | Diode_SMD:D_SMB_Handsoldering | https://www.comchiptech.com/admin/files/product/CZRB5338B-HF%20Thru111480.%20CZRB5388B-HF%20RevA.pdf |  |  | Zener Diode 56 V 5 W ±5% Surface Mount DO-214AA (SMB) | 641-1818-1-ND | https://www.digikey.co.uk/en/products/detail/comchip-technology/CZRB5370B-HF/6138929 |  |  | Comchip Technology | CZRB5370B-HF
 |  | D4 | Green | Device:LED_Small_Filled | Diode_SMD:D_1206_3216Metric_Pad1.42x1.75mm_HandSolder | https://www.we-online.com/katalog/datasheet/150080VS75000.pdf |  |  | Green 570nm LED Indication - Discrete 2V 1206 (3216 Metric) | 732-4993-1-ND | https://www.digikey.co.uk/en/products/detail/w%C3%BCrth-elektronik/150120VS75000/4489945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 |  |  | Würth Elektronik | 150120VS75000 |  |  |  |  |  | 8154237P
 |  | D5 | 5V1 | Device:D_Schottky_KKA | Package_TO_SOT_SMD:SOT-23_Handsoldering | https://www.onsemi.com/pdf/datasheet/bzx84c2v4lt1-d.pdf |  |  | Zener Diode 5.1 V 225 mW ±6% Surface Mount SOT-23-3 (TO-236) | BZX84C5V1LT3GOSCT-ND | https://www.digikey.co.uk/en/products/detail/onsemi/BZX84C5V1LT3G/1476354 |  |  | Onsemi | BZX84C5V1LT3G
 |  | D6 | Green | Device:LED_Small_Filled | Diode_SMD:D_1206_3216Metric_Pad1.42x1.75mm_HandSolder | https://www.we-online.com/katalog/datasheet/150080VS75000.pdf |  |  | Green 570nm LED Indication - Discrete 2V 1206 (3216 Metric) | 732-4993-1-ND | https://www.digikey.co.uk/en/products/detail/w%C3%BCrth-elektronik/150120VS75000/4489945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 |  |  | Würth Elektronik | 150120VS75000 |  |  |  |  |  | 8154237P
 |  | D7 | Green | Device:LED_Small_Filled | Diode_SMD:D_1206_3216Metric_Pad1.42x1.75mm_HandSolder | https://www.we-online.com/katalog/datasheet/150080VS75000.pdf |  |  | Green 570nm LED Indication - Discrete 2V 1206 (3216 Metric) | 732-4993-1-ND | https://www.digikey.co.uk/en/products/detail/w%C3%BCrth-elektronik/150120VS75000/4489945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 |  |  | Würth Elektronik | 150120VS75000 |  |  |  |  |  | 8154237P
 |  | D8 | Green | Device:LED_Small_Filled | Diode_SMD:D_1206_3216Metric_Pad1.42x1.75mm_HandSolder | https://www.we-online.com/katalog/datasheet/150080VS75000.pdf |  |  | Green 570nm LED Indication - Discrete 2V 1206 (3216 Metric) | 732-4993-1-ND | https://www.digikey.co.uk/en/products/detail/w%C3%BCrth-elektronik/150120VS75000/4489945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 |  |  | Würth Elektronik | 150120VS75000 |  |  |  |  |  | 8154237P
 |  | D9 | Green | Device:LED_Small_Filled | Diode_SMD:D_1206_3216Metric_Pad1.42x1.75mm_HandSolder | https://www.we-online.com/katalog/datasheet/150080VS75000.pdf |  |  | Green 570nm LED Indication - Discrete 2V 1206 (3216 Metric) | 732-4993-1-ND | https://www.digikey.co.uk/en/products/detail/w%C3%BCrth-elektronik/150120VS75000/4489945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 |  |  | Würth Elektronik | 150120VS75000 |  |  |  |  |  | 8154237P
 |  | D10 | Green | Device:LED_Small_Filled | Diode_SMD:D_1206_3216Metric_Pad1.42x1.75mm_HandSolder | https://www.we-online.com/katalog/datasheet/150080VS75000.pdf |  |  | Green 570nm LED Indication - Discrete 2V 1206 (3216 Metric) | 732-4993-1-ND | https://www.digikey.co.uk/en/products/detail/w%C3%BCrth-elektronik/150120VS75000/4489945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 |  |  | Würth Elektronik | 150120VS75000 |  |  |  |  |  | 8154237P
 |  | D11 | Green | Device:LED_Small_Filled | Diode_SMD:D_1206_3216Metric_Pad1.42x1.75mm_HandSolder | https://www.we-online.com/katalog/datasheet/150080VS75000.pdf |  |  | Green 570nm LED Indication - Discrete 2V 1206 (3216 Metric) | 732-4993-1-ND | https://www.digikey.co.uk/en/products/detail/w%C3%BCrth-elektronik/150120VS75000/4489945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 |  |  | Würth Elektronik | 150120VS75000 |  |  |  |  |  | 8154237P
 |  | D12 | Green | Device:LED_Small_Filled | Diode_SMD:D_1206_3216Metric_Pad1.42x1.75mm_HandSolder | https://www.we-online.com/katalog/datasheet/150080VS75000.pdf |  |  | Green 570nm LED Indication - Discrete 2V 1206 (3216 Metric) | 732-4993-1-ND | https://www.digikey.co.uk/en/products/detail/w%C3%BCrth-elektronik/150120VS75000/4489945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 |  |  | Würth Elektronik | 150120VS75000 |  |  |  |  |  | 8154237P
 |  | D13 | Green | Device:LED_Small_Filled | Diode_SMD:D_1206_3216Metric_Pad1.42x1.75mm_HandSolder | https://www.we-online.com/katalog/datasheet/150080VS75000.pdf |  |  | Green 570nm LED Indication - Discrete 2V 1206 (3216 Metric) | 732-4993-1-ND | https://www.digikey.co.uk/en/products/detail/w%C3%BCrth-elektronik/150120VS75000/4489945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 |  |  | Würth Elektronik | 150120VS75000 |  |  |  |  |  | 8154237P
 |  | D14 | Green | Device:LED_Small_Filled | Diode_SMD:D_1206_3216Metric_Pad1.42x1.75mm_HandSolder | https://www.we-online.com/katalog/datasheet/150080VS75000.pdf |  |  | Green 570nm LED Indication - Discrete 2V 1206 (3216 Metric) | 732-4993-1-ND | https://www.digikey.co.uk/en/products/detail/w%C3%BCrth-elektronik/150120VS75000/4489945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 |  |  | Würth Elektronik | 150120VS75000 |  |  |  |  |  | 8154237P
 |  | D15 | Green | Device:LED_Small_Filled | Diode_SMD:D_1206_3216Metric_Pad1.42x1.75mm_HandSolder | https://www.we-online.com/katalog/datasheet/150080VS75000.pdf |  |  | Green 570nm LED Indication - Discrete 2V 1206 (3216 Metric) | 732-4993-1-ND | https://www.digikey.co.uk/en/products/detail/w%C3%BCrth-elektronik/150120VS75000/4489945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 |  |  | Würth Elektronik | 150120VS75000 |  |  |  |  |  | 8154237P
 |  | D16 | Green | Device:LED_Small_Filled | Diode_SMD:D_1206_3216Metric_Pad1.42x1.75mm_HandSolder | https://www.we-online.com/katalog/datasheet/150080VS75000.pdf |  |  | Green 570nm LED Indication - Discrete 2V 1206 (3216 Metric) | 732-4993-1-ND | https://www.digikey.co.uk/en/products/detail/w%C3%BCrth-elektronik/150120VS75000/4489945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 |  |  | Würth Elektronik | 150120VS75000 |  |  |  |  |  | 8154237P
 |  | D17 | Green | Device:LED_Small_Filled | Diode_SMD:D_1206_3216Metric_Pad1.42x1.75mm_HandSolder | https://www.we-online.com/katalog/datasheet/150080VS75000.pdf |  |  | Green 570nm LED Indication - Discrete 2V 1206 (3216 Metric) | 732-4993-1-ND | https://www.digikey.co.uk/en/products/detail/w%C3%BCrth-elektronik/150120VS75000/4489945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 |  |  | Würth Elektronik | 150120VS75000 |  |  |  |  |  | 8154237P
 |  | D18 | Green | Device:LED_Small_Filled | Diode_SMD:D_1206_3216Metric_Pad1.42x1.75mm_HandSolder | https://www.we-online.com/katalog/datasheet/150080VS75000.pdf |  |  | Green 570nm LED Indication - Discrete 2V 1206 (3216 Metric) | 732-4993-1-ND | https://www.digikey.co.uk/en/products/detail/w%C3%BCrth-elektronik/150120VS75000/4489945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 |  |  | Würth Elektronik | 150120VS75000 |  |  |  |  |  | 8154237P
 |  | D19 | 5V1 | Device:D_Schottky_KKA | Package_TO_SOT_SMD:SOT-23_Handsoldering | https://www.onsemi.com/pdf/datasheet/bzx84c2v4lt1-d.pdf |  |  | Zener Diode 5.1 V 225 mW ±6% Surface Mount SOT-23-3 (TO-236) | BZX84C5V1LT3GOSCT-ND | https://www.digikey.co.uk/en/products/detail/onsemi/BZX84C5V1LT3G/1476354 |  |  | Onsemi | BZX84C5V1LT3G
 |  | D20 | Green | Device:LED_Small_Filled | Diode_SMD:D_1206_3216Metric_Pad1.42x1.75mm_HandSolder | https://www.we-online.com/katalog/datasheet/150080VS75000.pdf |  |  | Green 570nm LED Indication - Discrete 2V 1206 (3216 Metric) | 732-4993-1-ND | https://www.digikey.co.uk/en/products/detail/w%C3%BCrth-elektronik/150120VS75000/4489945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 |  |  | Würth Elektronik | 150120VS75000 |  |  |  |  |  | 8154237P
 |  | D21 | Green | Device:LED_Small_Filled | Diode_SMD:D_1206_3216Metric_Pad1.42x1.75mm_HandSolder | https://www.we-online.com/katalog/datasheet/150080VS75000.pdf |  |  | Green 570nm LED Indication - Discrete 2V 1206 (3216 Metric) | 732-4993-1-ND | https://www.digikey.co.uk/en/products/detail/w%C3%BCrth-elektronik/150120VS75000/4489945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 |  |  | Würth Elektronik | 150120VS75000 |  |  |  |  |  | 8154237P
 |  | D22 | Green | Device:LED_Small_Filled | Diode_SMD:D_1206_3216Metric_Pad1.42x1.75mm_HandSolder | https://www.we-online.com/katalog/datasheet/150080VS75000.pdf |  |  | Green 570nm LED Indication - Discrete 2V 1206 (3216 Metric) | 732-4993-1-ND | https://www.digikey.co.uk/en/products/detail/w%C3%BCrth-elektronik/150120VS75000/4489945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 |  |  | Würth Elektronik | 150120VS75000 |  |  |  |  |  | 8154237P
 |  | D23 | Green | Device:LED_Small_Filled | Diode_SMD:D_1206_3216Metric_Pad1.42x1.75mm_HandSolder | https://www.we-online.com/katalog/datasheet/150080VS75000.pdf |  |  | Green 570nm LED Indication - Discrete 2V 1206 (3216 Metric) | 732-4993-1-ND | https://www.digikey.co.uk/en/products/detail/w%C3%BCrth-elektronik/150120VS75000/4489945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 |  |  | Würth Elektronik | 150120VS75000 |  |  |  |  |  | 8154237P
 |  | D24 | Green | Device:LED_Small_Filled | Diode_SMD:D_1206_3216Metric_Pad1.42x1.75mm_HandSolder | https://www.we-online.com/katalog/datasheet/150080VS75000.pdf |  |  | Green 570nm LED Indication - Discrete 2V 1206 (3216 Metric) | 732-4993-1-ND | https://www.digikey.co.uk/en/products/detail/w%C3%BCrth-elektronik/150120VS75000/4489945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 |  |  | Würth Elektronik | 150120VS75000 |  |  |  |  |  | 8154237P
 |  | D25 | Green | Device:LED_Small_Filled | Diode_SMD:D_1206_3216Metric_Pad1.42x1.75mm_HandSolder | https://www.we-online.com/katalog/datasheet/150080VS75000.pdf |  |  | Green 570nm LED Indication - Discrete 2V 1206 (3216 Metric) | 732-4993-1-ND | https://www.digikey.co.uk/en/products/detail/w%C3%BCrth-elektronik/150120VS75000/4489945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 |  |  | Würth Elektronik | 150120VS75000 |  |  |  |  |  | 8154237P
 |  | D26 | Green | Device:LED_Small_Filled | Diode_SMD:D_1206_3216Metric_Pad1.42x1.75mm_HandSolder | https://www.we-online.com/katalog/datasheet/150080VS75000.pdf |  |  | Green 570nm LED Indication - Discrete 2V 1206 (3216 Metric) | 732-4993-1-ND | https://www.digikey.co.uk/en/products/detail/w%C3%BCrth-elektronik/150120VS75000/4489945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 |  |  | Würth Elektronik | 150120VS75000 |  |  |  |  |  | 8154237P
 |  | D27 | Green | Device:LED_Small_Filled | Diode_SMD:D_1206_3216Metric_Pad1.42x1.75mm_HandSolder | https://www.we-online.com/katalog/datasheet/150080VS75000.pdf |  |  | Green 570nm LED Indication - Discrete 2V 1206 (3216 Metric) | 732-4993-1-ND | https://www.digikey.co.uk/en/products/detail/w%C3%BCrth-elektronik/150120VS75000/4489945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 |  |  | Würth Elektronik | 150120VS75000 |  |  |  |  |  | 8154237P
 |  | D28 | Green | Device:LED_Small_Filled | Diode_SMD:D_1206_3216Metric_Pad1.42x1.75mm_HandSolder | https://www.we-online.com/katalog/datasheet/150080VS75000.pdf |  |  | Green 570nm LED Indication - Discrete 2V 1206 (3216 Metric) | 732-4993-1-ND | https://www.digikey.co.uk/en/products/detail/w%C3%BCrth-elektronik/150120VS75000/4489945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 |  |  | Würth Elektronik | 150120VS75000 |  |  |  |  |  | 8154237P
 |  | D29 | Green | Device:LED_Small_Filled | Diode_SMD:D_1206_3216Metric_Pad1.42x1.75mm_HandSolder | https://www.we-online.com/katalog/datasheet/150080VS75000.pdf |  |  | Green 570nm LED Indication - Discrete 2V 1206 (3216 Metric) | 732-4993-1-ND | https://www.digikey.co.uk/en/products/detail/w%C3%BCrth-elektronik/150120VS75000/4489945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 |  |  | Würth Elektronik | 150120VS75000 |  |  |  |  |  | 8154237P
 |  | D30 | Green | Device:LED_Small_Filled | Diode_SMD:D_1206_3216Metric_Pad1.42x1.75mm_HandSolder | https://www.we-online.com/katalog/datasheet/150080VS75000.pdf |  |  | Green 570nm LED Indication - Discrete 2V 1206 (3216 Metric) | 732-4993-1-ND | https://www.digikey.co.uk/en/products/detail/w%C3%BCrth-elektronik/150120VS75000/4489945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 |  |  | Würth Elektronik | 150120VS75000 |  |  |  |  |  | 8154237P
 |  | D31 | Green | Device:LED_Small_Filled | Diode_SMD:D_1206_3216Metric_Pad1.42x1.75mm_HandSolder | https://www.we-online.com/katalog/datasheet/150080VS75000.pdf |  |  | Green 570nm LED Indication - Discrete 2V 1206 (3216 Metric) | 732-4993-1-ND | https://www.digikey.co.uk/en/products/detail/w%C3%BCrth-elektronik/150120VS75000/4489945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 |  |  | Würth Elektronik | 150120VS75000 |  |  |  |  |  | 8154237P
 |  | D32 | Green | Device:LED_Small_Filled | Diode_SMD:D_1206_3216Metric_Pad1.42x1.75mm_HandSolder | https://www.we-online.com/katalog/datasheet/150080VS75000.pdf |  |  | Green 570nm LED Indication - Discrete 2V 1206 (3216 Metric) | 732-4993-1-ND | https://www.digikey.co.uk/en/products/detail/w%C3%BCrth-elektronik/150120VS75000/4489945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 |  |  | Würth Elektronik | 150120VS75000 |  |  |  |  |  | 8154237P
 |  | D33 | Green | Device:LED_Small_Filled | Diode_SMD:D_1206_3216Metric_Pad1.42x1.75mm_HandSolder | https://www.we-online.com/katalog/datasheet/150080VS75000.pdf |  |  | Green 570nm LED Indication - Discrete 2V 1206 (3216 Metric) | 732-4993-1-ND | https://www.digikey.co.uk/en/products/detail/w%C3%BCrth-elektronik/150120VS75000/4489945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 |  |  | Würth Elektronik | 150120VS75000 |  |  |  |  |  | 8154237P
 |  | D34 | Green | Device:LED_Small_Filled | Diode_SMD:D_1206_3216Metric_Pad1.42x1.75mm_HandSolder | https://www.we-online.com/katalog/datasheet/150080VS75000.pdf |  |  | Green 570nm LED Indication - Discrete 2V 1206 (3216 Metric) | 732-4993-1-ND | https://www.digikey.co.uk/en/products/detail/w%C3%BCrth-elektronik/150120VS75000/4489945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 |  |  | Würth Elektronik | 150120VS75000 |  |  |  |  |  | 8154237P
 |  | D35 | Green | Device:LED_Small_Filled | Diode_SMD:D_1206_3216Metric_Pad1.42x1.75mm_HandSolder | https://www.we-online.com/katalog/datasheet/150080VS75000.pdf |  |  | Green 570nm LED Indication - Discrete 2V 1206 (3216 Metric) | 732-4993-1-ND | https://www.digikey.co.uk/en/products/detail/w%C3%BCrth-elektronik/150120VS75000/4489945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 |  |  | Würth Elektronik | 150120VS75000 |  |  |  |  |  | 8154237P
 |  | D36 | Green | Device:LED_Small_Filled | Diode_SMD:D_1206_3216Metric_Pad1.42x1.75mm_HandSolder | https://www.we-online.com/katalog/datasheet/150080VS75000.pdf |  |  | Green 570nm LED Indication - Discrete 2V 1206 (3216 Metric) | 732-4993-1-ND | https://www.digikey.co.uk/en/products/detail/w%C3%BCrth-elektronik/150120VS75000/4489945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 |  |  | Würth Elektronik | 150120VS75000 |  |  |  |  |  | 8154237P
 |  | D37 | Green | Device:LED_Small_Filled | Diode_SMD:D_1206_3216Metric_Pad1.42x1.75mm_HandSolder | https://www.we-online.com/katalog/datasheet/150080VS75000.pdf |  |  | Green 570nm LED Indication - Discrete 2V 1206 (3216 Metric) | 732-4993-1-ND | https://www.digikey.co.uk/en/products/detail/w%C3%BCrth-elektronik/150120VS75000/4489945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 |  |  | Würth Elektronik | 150120VS75000 |  |  |  |  |  | 8154237P
 |  | D38 | Green | Device:LED_Small_Filled | Diode_SMD:D_1206_3216Metric_Pad1.42x1.75mm_HandSolder | https://www.we-online.com/katalog/datasheet/150080VS75000.pdf |  |  | Green 570nm LED Indication - Discrete 2V 1206 (3216 Metric) | 732-4993-1-ND | https://www.digikey.co.uk/en/products/detail/w%C3%BCrth-elektronik/150120VS75000/4489945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 |  |  | Würth Elektronik | 150120VS75000 |  |  |  |  |  | 8154237P
 |  | D39 | Green | Device:LED_Small_Filled | Diode_SMD:D_1206_3216Metric_Pad1.42x1.75mm_HandSolder | https://www.we-online.com/katalog/datasheet/150080VS75000.pdf |  |  | Green 570nm LED Indication - Discrete 2V 1206 (3216 Metric) | 732-4993-1-ND | https://www.digikey.co.uk/en/products/detail/w%C3%BCrth-elektronik/150120VS75000/4489945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 |  |  | Würth Elektronik | 150120VS75000 |  |  |  |  |  | 8154237P
 |  | D40 | Green | Device:LED_Small_Filled | Diode_SMD:D_1206_3216Metric_Pad1.42x1.75mm_HandSolder | https://www.we-online.com/katalog/datasheet/150080VS75000.pdf |  |  | Green 570nm LED Indication - Discrete 2V 1206 (3216 Metric) | 732-4993-1-ND | https://www.digikey.co.uk/en/products/detail/w%C3%BCrth-elektronik/150120VS75000/4489945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 |  |  | Würth Elektronik | 150120VS75000 |  |  |  |  |  | 8154237P
 |  | D41 | Green | Device:LED_Small_Filled | Diode_SMD:D_1206_3216Metric_Pad1.42x1.75mm_HandSolder | https://www.we-online.com/katalog/datasheet/150080VS75000.pdf |  |  | Green 570nm LED Indication - Discrete 2V 1206 (3216 Metric) | 732-4993-1-ND | https://www.digikey.co.uk/en/products/detail/w%C3%BCrth-elektronik/150120VS75000/4489945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 |  |  | Würth Elektronik | 150120VS75000 |  |  |  |  |  | 8154237P
 |  | D42 | Green | Device:LED_Small_Filled | Diode_SMD:D_1206_3216Metric_Pad1.42x1.75mm_HandSolder | https://www.we-online.com/katalog/datasheet/150080VS75000.pdf |  |  | Green 570nm LED Indication - Discrete 2V 1206 (3216 Metric) | 732-4993-1-ND | https://www.digikey.co.uk/en/products/detail/w%C3%BCrth-elektronik/150120VS75000/4489945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 |  |  | Würth Elektronik | 150120VS75000 |  |  |  |  |  | 8154237P
 |  | D43 | Green | Device:LED_Small_Filled | Diode_SMD:D_1206_3216Metric_Pad1.42x1.75mm_HandSolder | https://www.we-online.com/katalog/datasheet/150080VS75000.pdf |  |  | Green 570nm LED Indication - Discrete 2V 1206 (3216 Metric) | 732-4993-1-ND | https://www.digikey.co.uk/en/products/detail/w%C3%BCrth-elektronik/150120VS75000/4489945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 |  |  | Würth Elektronik | 150120VS75000 |  |  |  |  |  | 8154237P
 |  | D44 | Green | Device:LED_Small_Filled | Diode_SMD:D_1206_3216Metric_Pad1.42x1.75mm_HandSolder | https://www.we-online.com/katalog/datasheet/150080VS75000.pdf |  |  | Green 570nm LED Indication - Discrete 2V 1206 (3216 Metric) | 732-4993-1-ND | https://www.digikey.co.uk/en/products/detail/w%C3%BCrth-elektronik/150120VS75000/4489945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 |  |  | Würth Elektronik | 150120VS75000 |  |  |  |  |  | 8154237P
 |  | D45 | Green | Device:LED_Small_Filled | Diode_SMD:D_1206_3216Metric_Pad1.42x1.75mm_HandSolder | https://www.we-online.com/katalog/datasheet/150080VS75000.pdf |  |  | Green 570nm LED Indication - Discrete 2V 1206 (3216 Metric) | 732-4993-1-ND | https://www.digikey.co.uk/en/products/detail/w%C3%BCrth-elektronik/150120VS75000/4489945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 |  |  | Würth Elektronik | 150120VS75000 |  |  |  |  |  | 8154237P
 |  | D46 | Green | Device:LED_Small_Filled | Diode_SMD:D_1206_3216Metric_Pad1.42x1.75mm_HandSolder | https://www.we-online.com/katalog/datasheet/150080VS75000.pdf |  |  | Green 570nm LED Indication - Discrete 2V 1206 (3216 Metric) | 732-4993-1-ND | https://www.digikey.co.uk/en/products/detail/w%C3%BCrth-elektronik/150120VS75000/4489945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 |  |  | Würth Elektronik | 150120VS75000 |  |  |  |  |  | 8154237P
 |  | D47 | Green | Device:LED_Small_Filled | Diode_SMD:D_1206_3216Metric_Pad1.42x1.75mm_HandSolder | https://www.we-online.com/katalog/datasheet/150080VS75000.pdf |  |  | Green 570nm LED Indication - Discrete 2V 1206 (3216 Metric) | 732-4993-1-ND | https://www.digikey.co.uk/en/products/detail/w%C3%BCrth-elektronik/150120VS75000/4489945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 |  |  | Würth Elektronik | 150120VS75000 |  |  |  |  |  | 8154237P
 |  | D48 | Green | Device:LED_Small_Filled | Diode_SMD:D_1206_3216Metric_Pad1.42x1.75mm_HandSolder | https://www.we-online.com/katalog/datasheet/150080VS75000.pdf |  |  | Green 570nm LED Indication - Discrete 2V 1206 (3216 Metric) | 732-4993-1-ND | https://www.digikey.co.uk/en/products/detail/w%C3%BCrth-elektronik/150120VS75000/4489945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 |  |  | Würth Elektronik | 150120VS75000 |  |  |  |  |  | 8154237P
 |  | D49 | Green | Device:LED_Small_Filled | Diode_SMD:D_1206_3216Metric_Pad1.42x1.75mm_HandSolder | https://www.we-online.com/katalog/datasheet/150080VS75000.pdf |  |  | Green 570nm LED Indication - Discrete 2V 1206 (3216 Metric) | 732-4993-1-ND | https://www.digikey.co.uk/en/products/detail/w%C3%BCrth-elektronik/150120VS75000/4489945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 |  |  | Würth Elektronik | 150120VS75000 |  |  |  |  |  | 8154237P
 |  | D50 | Green | Device:LED_Small_Filled | Diode_SMD:D_1206_3216Metric_Pad1.42x1.75mm_HandSolder | https://www.we-online.com/katalog/datasheet/150080VS75000.pdf |  |  | Green 570nm LED Indication - Discrete 2V 1206 (3216 Metric) | 732-4993-1-ND | https://www.digikey.co.uk/en/products/detail/w%C3%BCrth-elektronik/150120VS75000/4489945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 |  |  | Würth Elektronik | 150120VS75000 |  |  |  |  |  | 8154237P
 |  | D51 | Green | Device:LED_Small_Filled | Diode_SMD:D_1206_3216Metric_Pad1.42x1.75mm_HandSolder | https://www.we-online.com/katalog/datasheet/150080VS75000.pdf |  |  | Green 570nm LED Indication - Discrete 2V 1206 (3216 Metric) | 732-4993-1-ND | https://www.digikey.co.uk/en/products/detail/w%C3%BCrth-elektronik/150120VS75000/4489945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 |  |  | Würth Elektronik | 150120VS75000 |  |  |  |  |  | 8154237P
 |  | D52 | Green | Device:LED_Small_Filled | Diode_SMD:D_1206_3216Metric_Pad1.42x1.75mm_HandSolder | https://www.we-online.com/katalog/datasheet/150080VS75000.pdf |  |  | Green 570nm LED Indication - Discrete 2V 1206 (3216 Metric) | 732-4993-1-ND | https://www.digikey.co.uk/en/products/detail/w%C3%BCrth-elektronik/150120VS75000/4489945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 |  |  | Würth Elektronik | 150120VS75000 |  |  |  |  |  | 8154237P
 |  | D53 | Green | Device:LED_Small_Filled | Diode_SMD:D_1206_3216Metric_Pad1.42x1.75mm_HandSolder | https://www.we-online.com/katalog/datasheet/150080VS75000.pdf |  |  | Green 570nm LED Indication - Discrete 2V 1206 (3216 Metric) | 732-4993-1-ND | https://www.digikey.co.uk/en/products/detail/w%C3%BCrth-elektronik/150120VS75000/4489945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 |  |  | Würth Elektronik | 150120VS75000 |  |  |  |  |  | 8154237P
 |  | D54 | Green | Device:LED_Small_Filled | Diode_SMD:D_1206_3216Metric_Pad1.42x1.75mm_HandSolder | https://www.we-online.com/katalog/datasheet/150080VS75000.pdf |  |  | Green 570nm LED Indication - Discrete 2V 1206 (3216 Metric) | 732-4993-1-ND | https://www.digikey.co.uk/en/products/detail/w%C3%BCrth-elektronik/150120VS75000/4489945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 |  |  | Würth Elektronik | 150120VS75000 |  |  |  |  |  | 8154237P
 |  | D55 | Red | Device:LED_Small_Filled | Diode_SMD:D_1206_3216Metric_Pad1.42x1.75mm_HandSolder | https://www.we-online.com/katalog/datasheet/150080VS75000.pdf |  |  | Red 630nm LED Indication - Discrete 1.9V 1206 (3216 Metric) | 732-4992-1-ND | https://www.digikey.co.uk/en/products/detail/w%C3%BCrth-elektronik/150120SS75000/4489942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 |  |  | Würth Elektronik | 150120SS75000 |  |  |  |  |  | 8154237P
 |  | D56 | Amber | Device:LED_Small_Filled | Diode_SMD:D_1206_3216Metric_Pad1.42x1.75mm_HandSolder | https://www.we-online.com/katalog/datasheet/150080VS75000.pdf |  |  | Amber 605nm LED Indication - Discrete 2V 1206 (3216 Metric) | 732-4988-1-ND | https://www.digikey.co.uk/en/products/detail/w%C3%BCrth-elektronik/150120AS75000/4489930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 |  |  | Würth Elektronik | 150120AS75000 |  |  |  |  |  | 8154237P
 |  | D57 | Green | Device:LED_Small_Filled | Diode_SMD:D_1206_3216Metric_Pad1.42x1.75mm_HandSolder | https://www.we-online.com/katalog/datasheet/150080VS75000.pdf |  |  | Green 570nm LED Indication - Discrete 2V 1206 (3216 Metric) | 732-4993-1-ND | https://www.digikey.co.uk/en/products/detail/w%C3%BCrth-elektronik/150120VS75000/4489945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 |  |  | Würth Elektronik | 150120VS75000 |  |  |  |  |  | 8154237P
 |  | D58 | Green | Device:LED_Small_Filled | Diode_SMD:D_1206_3216Metric_Pad1.42x1.75mm_HandSolder | https://www.we-online.com/katalog/datasheet/150080VS75000.pdf |  |  | Green 570nm LED Indication - Discrete 2V 1206 (3216 Metric) | 732-4993-1-ND | https://www.digikey.co.uk/en/products/detail/w%C3%BCrth-elektronik/150120VS75000/4489945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 |  |  | Würth Elektronik | 150120VS75000 |  |  |  |  |  | 8154237P
 |  | D59 | Green | Device:LED_Small_Filled | Diode_SMD:D_1206_3216Metric_Pad1.42x1.75mm_HandSolder | https://www.we-online.com/katalog/datasheet/150080VS75000.pdf |  |  | Green 570nm LED Indication - Discrete 2V 1206 (3216 Metric) | 732-4993-1-ND | https://www.digikey.co.uk/en/products/detail/w%C3%BCrth-elektronik/150120VS75000/4489945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 |  |  | Würth Elektronik | 150120VS75000 |  |  |  |  |  | 8154237P
 |  | D60 | 5V1 | Device:D_Schottky_KKA | Package_TO_SOT_SMD:SOT-23_Handsoldering | https://www.onsemi.com/pdf/datasheet/bzx84c2v4lt1-d.pdf |  |  | Zener Diode 5.1 V 225 mW ±6% Surface Mount SOT-23-3 (TO-236) | BZX84C5V1LT3GOSCT-ND | https://www.digikey.co.uk/en/products/detail/onsemi/BZX84C5V1LT3G/1476354 |  |  | Onsemi | BZX84C5V1LT3G
 |  | D61 | 5V1 | Device:D_Schottky_KKA | Package_TO_SOT_SMD:SOT-23_Handsoldering | https://www.onsemi.com/pdf/datasheet/bzx84c2v4lt1-d.pdf |  |  | Zener Diode 5.1 V 225 mW ±6% Surface Mount SOT-23-3 (TO-236) | BZX84C5V1LT3GOSCT-ND | https://www.digikey.co.uk/en/products/detail/onsemi/BZX84C5V1LT3G/1476354 |  |  | Onsemi | BZX84C5V1LT3G
 |  | D62 | 5V1 | Device:D_Schottky_KKA | Package_TO_SOT_SMD:SOT-23_Handsoldering | https://www.onsemi.com/pdf/datasheet/bzx84c2v4lt1-d.pdf |  |  | Zener Diode 5.1 V 225 mW ±6% Surface Mount SOT-23-3 (TO-236) | BZX84C5V1LT3GOSCT-ND | https://www.digikey.co.uk/en/products/detail/onsemi/BZX84C5V1LT3G/1476354 |  |  | Onsemi | BZX84C5V1LT3G
 |  | D63 | 5V1 | Device:D_Schottky_KKA | Package_TO_SOT_SMD:SOT-23_Handsoldering | https://www.onsemi.com/pdf/datasheet/bzx84c2v4lt1-d.pdf |  |  | Zener Diode 5.1 V 225 mW ±6% Surface Mount SOT-23-3 (TO-236) | BZX84C5V1LT3GOSCT-ND | https://www.digikey.co.uk/en/products/detail/onsemi/BZX84C5V1LT3G/1476354 |  |  | Onsemi | BZX84C5V1LT3G
 |  | D64 | Green | Device:LED_Small_Filled | Diode_SMD:D_1206_3216Metric_Pad1.42x1.75mm_HandSolder | https://www.we-online.com/katalog/datasheet/150080VS75000.pdf |  |  | Green 570nm LED Indication - Discrete 2V 1206 (3216 Metric) | 732-4993-1-ND | https://www.digikey.co.uk/en/products/detail/w%C3%BCrth-elektronik/150120VS75000/4489945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 |  |  | Würth Elektronik | 150120VS75000 |  |  |  |  |  | 8154237P
 |  | D65 | Green | Device:LED_Small_Filled | Diode_SMD:D_1206_3216Metric_Pad1.42x1.75mm_HandSolder | https://www.we-online.com/katalog/datasheet/150080VS75000.pdf |  |  | Green 570nm LED Indication - Discrete 2V 1206 (3216 Metric) | 732-4993-1-ND | https://www.digikey.co.uk/en/products/detail/w%C3%BCrth-elektronik/150120VS75000/4489945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 |  |  | Würth Elektronik | 150120VS75000 |  |  |  |  |  | 8154237P
 |  | D66 | Green | Device:LED_Small_Filled | Diode_SMD:D_1206_3216Metric_Pad1.42x1.75mm_HandSolder | https://www.we-online.com/katalog/datasheet/150080VS75000.pdf |  |  | Green 570nm LED Indication - Discrete 2V 1206 (3216 Metric) | 732-4993-1-ND | https://www.digikey.co.uk/en/products/detail/w%C3%BCrth-elektronik/150120VS75000/4489945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 |  |  | Würth Elektronik | 150120VS75000 |  |  |  |  |  | 8154237P
 |  | D67 | Green | Device:LED_Small_Filled | Diode_SMD:D_1206_3216Metric_Pad1.42x1.75mm_HandSolder | https://www.we-online.com/katalog/datasheet/150080VS75000.pdf |  |  | Green 570nm LED Indication - Discrete 2V 1206 (3216 Metric) | 732-4993-1-ND | https://www.digikey.co.uk/en/products/detail/w%C3%BCrth-elektronik/150120VS75000/4489945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 |  |  | Würth Elektronik | 150120VS75000 |  |  |  |  |  | 8154237P
 |  | D68 | Green | Device:LED_Small_Filled | Diode_SMD:D_1206_3216Metric_Pad1.42x1.75mm_HandSolder | https://www.we-online.com/katalog/datasheet/150080VS75000.pdf |  |  | Green 570nm LED Indication - Discrete 2V 1206 (3216 Metric) | 732-4993-1-ND | https://www.digikey.co.uk/en/products/detail/w%C3%BCrth-elektronik/150120VS75000/4489945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 |  |  | Würth Elektronik | 150120VS75000 |  |  |  |  |  | 8154237P
 |  | D69 | Green | Device:LED_Small_Filled | Diode_SMD:D_1206_3216Metric_Pad1.42x1.75mm_HandSolder | https://www.we-online.com/katalog/datasheet/150080VS75000.pdf |  |  | Green 570nm LED Indication - Discrete 2V 1206 (3216 Metric) | 732-4993-1-ND | https://www.digikey.co.uk/en/products/detail/w%C3%BCrth-elektronik/150120VS75000/4489945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 |  |  | Würth Elektronik | 150120VS75000 |  |  |  |  |  | 8154237P
 |  | D70 | Green | Device:LED_Small_Filled | Diode_SMD:D_1206_3216Metric_Pad1.42x1.75mm_HandSolder | https://www.we-online.com/katalog/datasheet/150080VS75000.pdf |  |  | Green 570nm LED Indication - Discrete 2V 1206 (3216 Metric) | 732-4993-1-ND | https://www.digikey.co.uk/en/products/detail/w%C3%BCrth-elektronik/150120VS75000/4489945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 |  |  | Würth Elektronik | 150120VS75000 |  |  |  |  |  | 8154237P
 |  | D71 | Green | Device:LED_Small_Filled | Diode_SMD:D_1206_3216Metric_Pad1.42x1.75mm_HandSolder | https://www.we-online.com/katalog/datasheet/150080VS75000.pdf |  |  | Green 570nm LED Indication - Discrete 2V 1206 (3216 Metric) | 732-4993-1-ND | https://www.digikey.co.uk/en/products/detail/w%C3%BCrth-elektronik/150120VS75000/4489945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 |  |  | Würth Elektronik | 150120VS75000 |  |  |  |  |  | 8154237P
 |  | D72 | Green | Device:LED_Small_Filled | Diode_SMD:D_1206_3216Metric_Pad1.42x1.75mm_HandSolder | https://www.we-online.com/katalog/datasheet/150080VS75000.pdf |  |  | Green 570nm LED Indication - Discrete 2V 1206 (3216 Metric) | 732-4993-1-ND | https://www.digikey.co.uk/en/products/detail/w%C3%BCrth-elektronik/150120VS75000/4489945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 |  |  | Würth Elektronik | 150120VS75000 |  |  |  |  |  | 8154237P
 |  | D73 | Green | Device:LED_Small_Filled | Diode_SMD:D_1206_3216Metric_Pad1.42x1.75mm_HandSolder | https://www.we-online.com/katalog/datasheet/150080VS75000.pdf |  |  | Green 570nm LED Indication - Discrete 2V 1206 (3216 Metric) | 732-4993-1-ND | https://www.digikey.co.uk/en/products/detail/w%C3%BCrth-elektronik/150120VS75000/4489945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 |  |  | Würth Elektronik | 150120VS75000 |  |  |  |  |  | 8154237P
 |  | D74 | Green | Device:LED_Small_Filled | Diode_SMD:D_1206_3216Metric_Pad1.42x1.75mm_HandSolder | https://www.we-online.com/katalog/datasheet/150080VS75000.pdf |  |  | Green 570nm LED Indication - Discrete 2V 1206 (3216 Metric) | 732-4993-1-ND | https://www.digikey.co.uk/en/products/detail/w%C3%BCrth-elektronik/150120VS75000/4489945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 |  |  | Würth Elektronik | 150120VS75000 |  |  |  |  |  | 8154237P
 |  | D75 | Green | Device:LED_Small_Filled | Diode_SMD:D_1206_3216Metric_Pad1.42x1.75mm_HandSolder | https://www.we-online.com/katalog/datasheet/150080VS75000.pdf |  |  | Green 570nm LED Indication - Discrete 2V 1206 (3216 Metric) | 732-4993-1-ND | https://www.digikey.co.uk/en/products/detail/w%C3%BCrth-elektronik/150120VS75000/4489945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 |  |  | Würth Elektronik | 150120VS75000 |  |  |  |  |  | 8154237P
 |  | D76 | Green | Device:LED_Small_Filled | Diode_SMD:D_1206_3216Metric_Pad1.42x1.75mm_HandSolder | https://www.we-online.com/katalog/datasheet/150080VS75000.pdf |  |  | Green 570nm LED Indication - Discrete 2V 1206 (3216 Metric) | 732-4993-1-ND | https://www.digikey.co.uk/en/products/detail/w%C3%BCrth-elektronik/150120VS75000/4489945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 |  |  | Würth Elektronik | 150120VS75000 |  |  |  |  |  | 8154237P
 |  | D77 | Green | Device:LED_Small_Filled | Diode_SMD:D_1206_3216Metric_Pad1.42x1.75mm_HandSolder | https://www.we-online.com/katalog/datasheet/150080VS75000.pdf |  |  | Green 570nm LED Indication - Discrete 2V 1206 (3216 Metric) | 732-4993-1-ND | https://www.digikey.co.uk/en/products/detail/w%C3%BCrth-elektronik/150120VS75000/4489945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 |  |  | Würth Elektronik | 150120VS75000 |  |  |  |  |  | 8154237P
 |  | D78 | Green | Device:LED_Small_Filled | Diode_SMD:D_1206_3216Metric_Pad1.42x1.75mm_HandSolder | https://www.we-online.com/katalog/datasheet/150080VS75000.pdf |  |  | Green 570nm LED Indication - Discrete 2V 1206 (3216 Metric) | 732-4993-1-ND | https://www.digikey.co.uk/en/products/detail/w%C3%BCrth-elektronik/150120VS75000/4489945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 |  |  | Würth Elektronik | 150120VS75000 |  |  |  |  |  | 8154237P
 |  | D79 | Green | Device:LED_Small_Filled | Diode_SMD:D_1206_3216Metric_Pad1.42x1.75mm_HandSolder | https://www.we-online.com/katalog/datasheet/150080VS75000.pdf |  |  | Green 570nm LED Indication - Discrete 2V 1206 (3216 Metric) | 732-4993-1-ND | https://www.digikey.co.uk/en/products/detail/w%C3%BCrth-elektronik/150120VS75000/4489945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 |  |  | Würth Elektronik | 150120VS75000 |  |  |  |  |  | 8154237P
 |  | D80 | Green | Device:LED_Small_Filled | Diode_SMD:D_1206_3216Metric_Pad1.42x1.75mm_HandSolder | https://www.we-online.com/katalog/datasheet/150080VS75000.pdf |  |  | Green 570nm LED Indication - Discrete 2V 1206 (3216 Metric) | 732-4993-1-ND | https://www.digikey.co.uk/en/products/detail/w%C3%BCrth-elektronik/150120VS75000/4489945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 |  |  | Würth Elektronik | 150120VS75000 |  |  |  |  |  | 8154237P
 |  | D81 | Green | Device:LED_Small_Filled | Diode_SMD:D_1206_3216Metric_Pad1.42x1.75mm_HandSolder | https://www.we-online.com/katalog/datasheet/150080VS75000.pdf |  |  | Green 570nm LED Indication - Discrete 2V 1206 (3216 Metric) | 732-4993-1-ND | https://www.digikey.co.uk/en/products/detail/w%C3%BCrth-elektronik/150120VS75000/4489945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 |  |  | Würth Elektronik | 150120VS75000 |  |  |  |  |  | 8154237P
 |  | D82 | Green | Device:LED_Small_Filled | Diode_SMD:D_1206_3216Metric_Pad1.42x1.75mm_HandSolder | https://www.we-online.com/katalog/datasheet/150080VS75000.pdf |  |  | Green 570nm LED Indication - Discrete 2V 1206 (3216 Metric) | 732-4993-1-ND | https://www.digikey.co.uk/en/products/detail/w%C3%BCrth-elektronik/150120VS75000/4489945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 |  |  | Würth Elektronik | 150120VS75000 |  |  |  |  |  | 8154237P
 |  | D83 | Green | Device:LED_Small_Filled | Diode_SMD:D_1206_3216Metric_Pad1.42x1.75mm_HandSolder | https://www.we-online.com/katalog/datasheet/150080VS75000.pdf |  |  | Green 570nm LED Indication - Discrete 2V 1206 (3216 Metric) | 732-4993-1-ND | https://www.digikey.co.uk/en/products/detail/w%C3%BCrth-elektronik/150120VS75000/4489945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 |  |  | Würth Elektronik | 150120VS75000 |  |  |  |  |  | 8154237P
 |  | D84 | Green | Device:LED_Small_Filled | Diode_SMD:D_1206_3216Metric_Pad1.42x1.75mm_HandSolder | https://www.we-online.com/katalog/datasheet/150080VS75000.pdf |  |  | Green 570nm LED Indication - Discrete 2V 1206 (3216 Metric) | 732-4993-1-ND | https://www.digikey.co.uk/en/products/detail/w%C3%BCrth-elektronik/150120VS75000/4489945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 |  |  | Würth Elektronik | 150120VS75000 |  |  |  |  |  | 8154237P
 |  | D85 | Green | Device:LED_Small_Filled | Diode_SMD:D_1206_3216Metric_Pad1.42x1.75mm_HandSolder | https://www.we-online.com/katalog/datasheet/150080VS75000.pdf |  |  | Green 570nm LED Indication - Discrete 2V 1206 (3216 Metric) | 732-4993-1-ND | https://www.digikey.co.uk/en/products/detail/w%C3%BCrth-elektronik/150120VS75000/4489945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 |  |  | Würth Elektronik | 150120VS75000 |  |  |  |  |  | 8154237P
 |  | D86 | Green | Device:LED_Small_Filled | Diode_SMD:D_1206_3216Metric_Pad1.42x1.75mm_HandSolder | https://www.we-online.com/katalog/datasheet/150080VS75000.pdf |  |  | Green 570nm LED Indication - Discrete 2V 1206 (3216 Metric) | 732-4993-1-ND | https://www.digikey.co.uk/en/products/detail/w%C3%BCrth-elektronik/150120VS75000/4489945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 |  |  | Würth Elektronik | 150120VS75000 |  |  |  |  |  | 8154237P
 |  | D87 | Green | Device:LED_Small_Filled | Diode_SMD:D_1206_3216Metric_Pad1.42x1.75mm_HandSolder | https://www.we-online.com/katalog/datasheet/150080VS75000.pdf |  |  | Green 570nm LED Indication - Discrete 2V 1206 (3216 Metric) | 732-4993-1-ND | https://www.digikey.co.uk/en/products/detail/w%C3%BCrth-elektronik/150120VS75000/4489945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 |  |  | Würth Elektronik | 150120VS75000 |  |  |  |  |  | 8154237P
 |  | D88 | Green | Device:LED_Small_Filled | Diode_SMD:D_1206_3216Metric_Pad1.42x1.75mm_HandSolder | https://www.we-online.com/katalog/datasheet/150080VS75000.pdf |  |  | Green 570nm LED Indication - Discrete 2V 1206 (3216 Metric) | 732-4993-1-ND | https://www.digikey.co.uk/en/products/detail/w%C3%BCrth-elektronik/150120VS75000/4489945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 |  |  | Würth Elektronik | 150120VS75000 |  |  |  |  |  | 8154237P
 |  | D89 | Green | Device:LED_Small_Filled | Diode_SMD:D_1206_3216Metric_Pad1.42x1.75mm_HandSolder | https://www.we-online.com/katalog/datasheet/150080VS75000.pdf |  |  | Green 570nm LED Indication - Discrete 2V 1206 (3216 Metric) | 732-4993-1-ND | https://www.digikey.co.uk/en/products/detail/w%C3%BCrth-elektronik/150120VS75000/4489945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 |  |  | Würth Elektronik | 150120VS75000 |  |  |  |  |  | 8154237P
 |  | D90 | Green | Device:LED_Small_Filled | Diode_SMD:D_1206_3216Metric_Pad1.42x1.75mm_HandSolder | https://www.we-online.com/katalog/datasheet/150080VS75000.pdf |  |  | Green 570nm LED Indication - Discrete 2V 1206 (3216 Metric) | 732-4993-1-ND | https://www.digikey.co.uk/en/products/detail/w%C3%BCrth-elektronik/150120VS75000/4489945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 |  |  | Würth Elektronik | 150120VS75000 |  |  |  |  |  | 8154237P
 |  | D91 | Green | Device:LED_Small_Filled | Diode_SMD:D_1206_3216Metric_Pad1.42x1.75mm_HandSolder | https://www.we-online.com/katalog/datasheet/150080VS75000.pdf |  |  | Green 570nm LED Indication - Discrete 2V 1206 (3216 Metric) | 732-4993-1-ND | https://www.digikey.co.uk/en/products/detail/w%C3%BCrth-elektronik/150120VS75000/4489945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 |  |  | Würth Elektronik | 150120VS75000 |  |  |  |  |  | 8154237P
 |  | D92 | Green | Device:LED_Small_Filled | Diode_SMD:D_1206_3216Metric_Pad1.42x1.75mm_HandSolder | https://www.we-online.com/katalog/datasheet/150080VS75000.pdf |  |  | Green 570nm LED Indication - Discrete 2V 1206 (3216 Metric) | 732-4993-1-ND | https://www.digikey.co.uk/en/products/detail/w%C3%BCrth-elektronik/150120VS75000/4489945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 |  |  | Würth Elektronik | 150120VS75000 |  |  |  |  |  | 8154237P
 |  | D93 | Green | Device:LED_Small_Filled | Diode_SMD:D_1206_3216Metric_Pad1.42x1.75mm_HandSolder | https://www.we-online.com/katalog/datasheet/150080VS75000.pdf |  |  | Green 570nm LED Indication - Discrete 2V 1206 (3216 Metric) | 732-4993-1-ND | https://www.digikey.co.uk/en/products/detail/w%C3%BCrth-elektronik/150120VS75000/4489945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 |  |  | Würth Elektronik | 150120VS75000 |  |  |  |  |  | 8154237P
 |  | D94 | Green | Device:LED_Small_Filled | Diode_SMD:D_1206_3216Metric_Pad1.42x1.75mm_HandSolder | https://www.we-online.com/katalog/datasheet/150080VS75000.pdf |  |  | Green 570nm LED Indication - Discrete 2V 1206 (3216 Metric) | 732-4993-1-ND | https://www.digikey.co.uk/en/products/detail/w%C3%BCrth-elektronik/150120VS75000/4489945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 |  |  | Würth Elektronik | 150120VS75000 |  |  |  |  |  | 8154237P
 |  | D95 | Green | Device:LED_Small_Filled | Diode_SMD:D_1206_3216Metric_Pad1.42x1.75mm_HandSolder | https://www.we-online.com/katalog/datasheet/150080VS75000.pdf |  |  | Green 570nm LED Indication - Discrete 2V 1206 (3216 Metric) | 732-4993-1-ND | https://www.digikey.co.uk/en/products/detail/w%C3%BCrth-elektronik/150120VS75000/4489945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 |  |  | Würth Elektronik | 150120VS75000 |  |  |  |  |  | 8154237P
 |  | D96 | Green | Device:LED_Small_Filled | Diode_SMD:D_1206_3216Metric_Pad1.42x1.75mm_HandSolder | https://www.we-online.com/katalog/datasheet/150080VS75000.pdf |  |  | Green 570nm LED Indication - Discrete 2V 1206 (3216 Metric) | 732-4993-1-ND | https://www.digikey.co.uk/en/products/detail/w%C3%BCrth-elektronik/150120VS75000/4489945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 |  |  | Würth Elektronik | 150120VS75000 |  |  |  |  |  | 8154237P
 |  | D97 | Green | Device:LED_Small_Filled | Diode_SMD:D_1206_3216Metric_Pad1.42x1.75mm_HandSolder | https://www.we-online.com/katalog/datasheet/150080VS75000.pdf |  |  | Green 570nm LED Indication - Discrete 2V 1206 (3216 Metric) | 732-4993-1-ND | https://www.digikey.co.uk/en/products/detail/w%C3%BCrth-elektronik/150120VS75000/4489945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 |  |  | Würth Elektronik | 150120VS75000 |  |  |  |  |  | 8154237P
 |  | D98 | Green | Device:LED_Small_Filled | Diode_SMD:D_1206_3216Metric_Pad1.42x1.75mm_HandSolder | https://www.we-online.com/katalog/datasheet/150080VS75000.pdf |  |  | Green 570nm LED Indication - Discrete 2V 1206 (3216 Metric) | 732-4993-1-ND | https://www.digikey.co.uk/en/products/detail/w%C3%BCrth-elektronik/150120VS75000/4489945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 |  |  | Würth Elektronik | 150120VS75000 |  |  |  |  |  | 8154237P
 |  | D99 | Green | Device:LED_Small_Filled | Diode_SMD:D_1206_3216Metric_Pad1.42x1.75mm_HandSolder | https://www.we-online.com/katalog/datasheet/150080VS75000.pdf |  |  | Green 570nm LED Indication - Discrete 2V 1206 (3216 Metric) | 732-4993-1-ND | https://www.digikey.co.uk/en/products/detail/w%C3%BCrth-elektronik/150120VS75000/4489945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 |  |  | Würth Elektronik | 150120VS75000 |  |  |  |  |  | 8154237P
 |  | D100 | Green | Device:LED_Small_Filled | Diode_SMD:D_1206_3216Metric_Pad1.42x1.75mm_HandSolder | https://www.we-online.com/katalog/datasheet/150080VS75000.pdf |  |  | Green 570nm LED Indication - Discrete 2V 1206 (3216 Metric) | 732-4993-1-ND | https://www.digikey.co.uk/en/products/detail/w%C3%BCrth-elektronik/150120VS75000/4489945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 |  |  | Würth Elektronik | 150120VS75000 |  |  |  |  |  | 8154237P
 |  | D101 | Green | Device:LED_Small_Filled | Diode_SMD:D_1206_3216Metric_Pad1.42x1.75mm_HandSolder | https://www.we-online.com/katalog/datasheet/150080VS75000.pdf |  |  | Green 570nm LED Indication - Discrete 2V 1206 (3216 Metric) | 732-4993-1-ND | https://www.digikey.co.uk/en/products/detail/w%C3%BCrth-elektronik/150120VS75000/4489945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 |  |  | Würth Elektronik | 150120VS75000 |  |  |  |  |  | 8154237P
 |  | D102 | Green | Device:LED_Small_Filled | Diode_SMD:D_1206_3216Metric_Pad1.42x1.75mm_HandSolder | https://www.we-online.com/katalog/datasheet/150080VS75000.pdf |  |  | Green 570nm LED Indication - Discrete 2V 1206 (3216 Metric) | 732-4993-1-ND | https://www.digikey.co.uk/en/products/detail/w%C3%BCrth-elektronik/150120VS75000/4489945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 |  |  | Würth Elektronik | 150120VS75000 |  |  |  |  |  | 8154237P
 |  | D103 | Green | Device:LED_Small_Filled | Diode_SMD:D_1206_3216Metric_Pad1.42x1.75mm_HandSolder | https://www.we-online.com/katalog/datasheet/150080VS75000.pdf |  |  | Green 570nm LED Indication - Discrete 2V 1206 (3216 Metric) | 732-4993-1-ND | https://www.digikey.co.uk/en/products/detail/w%C3%BCrth-elektronik/150120VS75000/4489945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 |  |  | Würth Elektronik | 150120VS75000 |  |  |  |  |  | 8154237P
 |  | D104 | Green | Device:LED_Small_Filled | Diode_SMD:D_1206_3216Metric_Pad1.42x1.75mm_HandSolder | https://www.we-online.com/katalog/datasheet/150080VS75000.pdf |  |  | Green 570nm LED Indication - Discrete 2V 1206 (3216 Metric) | 732-4993-1-ND | https://www.digikey.co.uk/en/products/detail/w%C3%BCrth-elektronik/150120VS75000/4489945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 |  |  | Würth Elektronik | 150120VS75000 |  |  |  |  |  | 8154237P
 |  | D105 | Green | Device:LED_Small_Filled | Diode_SMD:D_1206_3216Metric_Pad1.42x1.75mm_HandSolder | https://www.we-online.com/katalog/datasheet/150080VS75000.pdf |  |  | Green 570nm LED Indication - Discrete 2V 1206 (3216 Metric) | 732-4993-1-ND | https://www.digikey.co.uk/en/products/detail/w%C3%BCrth-elektronik/150120VS75000/4489945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 |  |  | Würth Elektronik | 150120VS75000 |  |  |  |  |  | 8154237P
 |  | D106 | Green | Device:LED_Small_Filled | Diode_SMD:D_1206_3216Metric_Pad1.42x1.75mm_HandSolder | https://www.we-online.com/katalog/datasheet/150080VS75000.pdf |  |  | Green 570nm LED Indication - Discrete 2V 1206 (3216 Metric) | 732-4993-1-ND | https://www.digikey.co.uk/en/products/detail/w%C3%BCrth-elektronik/150120VS75000/4489945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 |  |  | Würth Elektronik | 150120VS75000 |  |  |  |  |  | 8154237P
 |  | D107 | Green | Device:LED_Small_Filled | Diode_SMD:D_1206_3216Metric_Pad1.42x1.75mm_HandSolder | https://www.we-online.com/katalog/datasheet/150080VS75000.pdf |  |  | Green 570nm LED Indication - Discrete 2V 1206 (3216 Metric) | 732-4993-1-ND | https://www.digikey.co.uk/en/products/detail/w%C3%BCrth-elektronik/150120VS75000/4489945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 |  |  | Würth Elektronik | 150120VS75000 |  |  |  |  |  | 8154237P
 |  | D108 | Green | Device:LED_Small_Filled | Diode_SMD:D_1206_3216Metric_Pad1.42x1.75mm_HandSolder | https://www.we-online.com/katalog/datasheet/150080VS75000.pdf |  |  | Green 570nm LED Indication - Discrete 2V 1206 (3216 Metric) | 732-4993-1-ND | https://www.digikey.co.uk/en/products/detail/w%C3%BCrth-elektronik/150120VS75000/4489945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 |  |  | Würth Elektronik | 150120VS75000 |  |  |  |  |  | 8154237P
 |  | D109 | Green | Device:LED_Small_Filled | Diode_SMD:D_1206_3216Metric_Pad1.42x1.75mm_HandSolder | https://www.we-online.com/katalog/datasheet/150080VS75000.pdf |  |  | Green 570nm LED Indication - Discrete 2V 1206 (3216 Metric) | 732-4993-1-ND | https://www.digikey.co.uk/en/products/detail/w%C3%BCrth-elektronik/150120VS75000/4489945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 |  |  | Würth Elektronik | 150120VS75000 |  |  |  |  |  | 8154237P
 |  | D110 | Green | Device:LED_Small_Filled | Diode_SMD:D_1206_3216Metric_Pad1.42x1.75mm_HandSolder | https://www.we-online.com/katalog/datasheet/150080VS75000.pdf |  |  | Green 570nm LED Indication - Discrete 2V 1206 (3216 Metric) | 732-4993-1-ND | https://www.digikey.co.uk/en/products/detail/w%C3%BCrth-elektronik/150120VS75000/4489945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 |  |  | Würth Elektronik | 150120VS75000 |  |  |  |  |  | 8154237P
 |  | D111 | Green | Device:LED_Small_Filled | Diode_SMD:D_1206_3216Metric_Pad1.42x1.75mm_HandSolder | https://www.we-online.com/katalog/datasheet/150080VS75000.pdf |  |  | Green 570nm LED Indication - Discrete 2V 1206 (3216 Metric) | 732-4993-1-ND | https://www.digikey.co.uk/en/products/detail/w%C3%BCrth-elektronik/150120VS75000/4489945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 |  |  | Würth Elektronik | 150120VS75000 |  |  |  |  |  | 8154237P
 |  | D112 | Green | Device:LED_Small_Filled | Diode_SMD:D_1206_3216Metric_Pad1.42x1.75mm_HandSolder | https://www.we-online.com/katalog/datasheet/150080VS75000.pdf |  |  | Green 570nm LED Indication - Discrete 2V 1206 (3216 Metric) | 732-4993-1-ND | https://www.digikey.co.uk/en/products/detail/w%C3%BCrth-elektronik/150120VS75000/4489945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 |  |  | Würth Elektronik | 150120VS75000 |  |  |  |  |  | 8154237P
 |  | D113 | Green | Device:LED_Small_Filled | Diode_SMD:D_1206_3216Metric_Pad1.42x1.75mm_HandSolder | https://www.we-online.com/katalog/datasheet/150080VS75000.pdf |  |  | Green 570nm LED Indication - Discrete 2V 1206 (3216 Metric) | 732-4993-1-ND | https://www.digikey.co.uk/en/products/detail/w%C3%BCrth-elektronik/150120VS75000/4489945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 |  |  | Würth Elektronik | 150120VS75000 |  |  |  |  |  | 8154237P
 |  | D114 | Green | Device:LED_Small_Filled | Diode_SMD:D_1206_3216Metric_Pad1.42x1.75mm_HandSolder | https://www.we-online.com/katalog/datasheet/150080VS75000.pdf |  |  | Green 570nm LED Indication - Discrete 2V 1206 (3216 Metric) | 732-4993-1-ND | https://www.digikey.co.uk/en/products/detail/w%C3%BCrth-elektronik/150120VS75000/4489945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 |  |  | Würth Elektronik | 150120VS75000 |  |  |  |  |  | 8154237P
 |  | D115 | Green | Device:LED_Small_Filled | Diode_SMD:D_1206_3216Metric_Pad1.42x1.75mm_HandSolder | https://www.we-online.com/katalog/datasheet/150080VS75000.pdf |  |  | Green 570nm LED Indication - Discrete 2V 1206 (3216 Metric) | 732-4993-1-ND | https://www.digikey.co.uk/en/products/detail/w%C3%BCrth-elektronik/150120VS75000/4489945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 |  |  | Würth Elektronik | 150120VS75000 |  |  |  |  |  | 8154237P
 |  | D116 | Green | Device:LED_Small_Filled | Diode_SMD:D_1206_3216Metric_Pad1.42x1.75mm_HandSolder | https://www.we-online.com/katalog/datasheet/150080VS75000.pdf |  |  | Green 570nm LED Indication - Discrete 2V 1206 (3216 Metric) | 732-4993-1-ND | https://www.digikey.co.uk/en/products/detail/w%C3%BCrth-elektronik/150120VS75000/4489945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 |  |  | Würth Elektronik | 150120VS75000 |  |  |  |  |  | 8154237P
 |  | D117 | Green | Device:LED_Small_Filled | Diode_SMD:D_1206_3216Metric_Pad1.42x1.75mm_HandSolder | https://www.we-online.com/katalog/datasheet/150080VS75000.pdf |  |  | Green 570nm LED Indication - Discrete 2V 1206 (3216 Metric) | 732-4993-1-ND | https://www.digikey.co.uk/en/products/detail/w%C3%BCrth-elektronik/150120VS75000/4489945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 |  |  | Würth Elektronik | 150120VS75000 |  |  |  |  |  | 8154237P
 |  | D118 | Green | Device:LED_Small_Filled | Diode_SMD:D_1206_3216Metric_Pad1.42x1.75mm_HandSolder | https://www.we-online.com/katalog/datasheet/150080VS75000.pdf |  |  | Green 570nm LED Indication - Discrete 2V 1206 (3216 Metric) | 732-4993-1-ND | https://www.digikey.co.uk/en/products/detail/w%C3%BCrth-elektronik/150120VS75000/4489945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 |  |  | Würth Elektronik | 150120VS75000 |  |  |  |  |  | 8154237P
 |  | D119 | Green | Device:LED_Small_Filled | Diode_SMD:D_1206_3216Metric_Pad1.42x1.75mm_HandSolder | https://www.we-online.com/katalog/datasheet/150080VS75000.pdf |  |  | Green 570nm LED Indication - Discrete 2V 1206 (3216 Metric) | 732-4993-1-ND | https://www.digikey.co.uk/en/products/detail/w%C3%BCrth-elektronik/150120VS75000/4489945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 |  |  | Würth Elektronik | 150120VS75000 |  |  |  |  |  | 8154237P
 |  | D120 | Green | Device:LED_Small_Filled | Diode_SMD:D_1206_3216Metric_Pad1.42x1.75mm_HandSolder | https://www.we-online.com/katalog/datasheet/150080VS75000.pdf |  |  | Green 570nm LED Indication - Discrete 2V 1206 (3216 Metric) | 732-4993-1-ND | https://www.digikey.co.uk/en/products/detail/w%C3%BCrth-elektronik/150120VS75000/4489945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 |  |  | Würth Elektronik | 150120VS75000 |  |  |  |  |  | 8154237P
 |  | D121 | Green | Device:LED_Small_Filled | Diode_SMD:D_1206_3216Metric_Pad1.42x1.75mm_HandSolder | https://www.we-online.com/katalog/datasheet/150080VS75000.pdf |  |  | Green 570nm LED Indication - Discrete 2V 1206 (3216 Metric) | 732-4993-1-ND | https://www.digikey.co.uk/en/products/detail/w%C3%BCrth-elektronik/150120VS75000/4489945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 |  |  | Würth Elektronik | 150120VS75000 |  |  |  |  |  | 8154237P
 |  | D122 | Green | Device:LED_Small_Filled | Diode_SMD:D_1206_3216Metric_Pad1.42x1.75mm_HandSolder | https://www.we-online.com/katalog/datasheet/150080VS75000.pdf |  |  | Green 570nm LED Indication - Discrete 2V 1206 (3216 Metric) | 732-4993-1-ND | https://www.digikey.co.uk/en/products/detail/w%C3%BCrth-elektronik/150120VS75000/4489945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 |  |  | Würth Elektronik | 150120VS75000 |  |  |  |  |  | 8154237P
 |  | D123 | Green | Device:LED_Small_Filled | Diode_SMD:D_1206_3216Metric_Pad1.42x1.75mm_HandSolder | https://www.we-online.com/katalog/datasheet/150080VS75000.pdf |  |  | Green 570nm LED Indication - Discrete 2V 1206 (3216 Metric) | 732-4993-1-ND | https://www.digikey.co.uk/en/products/detail/w%C3%BCrth-elektronik/150120VS75000/4489945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 |  |  | Würth Elektronik | 150120VS75000 |  |  |  |  |  | 8154237P
 |  | D124 | Green | Device:LED_Small_Filled | Diode_SMD:D_1206_3216Metric_Pad1.42x1.75mm_HandSolder | https://www.we-online.com/katalog/datasheet/150080VS75000.pdf |  |  | Green 570nm LED Indication - Discrete 2V 1206 (3216 Metric) | 732-4993-1-ND | https://www.digikey.co.uk/en/products/detail/w%C3%BCrth-elektronik/150120VS75000/4489945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 |  |  | Würth Elektronik | 150120VS75000 |  |  |  |  |  | 8154237P
 |  | D125 | Green | Device:LED_Small_Filled | Diode_SMD:D_1206_3216Metric_Pad1.42x1.75mm_HandSolder | https://www.we-online.com/katalog/datasheet/150080VS75000.pdf |  |  | Green 570nm LED Indication - Discrete 2V 1206 (3216 Metric) | 732-4993-1-ND | https://www.digikey.co.uk/en/products/detail/w%C3%BCrth-elektronik/150120VS75000/4489945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 |  |  | Würth Elektronik | 150120VS75000 |  |  |  |  |  | 8154237P
 |  | D126 | Green | Device:LED_Small_Filled | Diode_SMD:D_1206_3216Metric_Pad1.42x1.75mm_HandSolder | https://www.we-online.com/katalog/datasheet/150080VS75000.pdf |  |  | Green 570nm LED Indication - Discrete 2V 1206 (3216 Metric) | 732-4993-1-ND | https://www.digikey.co.uk/en/products/detail/w%C3%BCrth-elektronik/150120VS75000/4489945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 |  |  | Würth Elektronik | 150120VS75000 |  |  |  |  |  | 8154237P
 |  | D127 | Green | Device:LED_Small_Filled | Diode_SMD:D_1206_3216Metric_Pad1.42x1.75mm_HandSolder | https://www.we-online.com/katalog/datasheet/150080VS75000.pdf |  |  | Green 570nm LED Indication - Discrete 2V 1206 (3216 Metric) | 732-4993-1-ND | https://www.digikey.co.uk/en/products/detail/w%C3%BCrth-elektronik/150120VS75000/4489945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 |  |  | Würth Elektronik | 150120VS75000 |  |  |  |  |  | 8154237P
 |  | H1 | M4 | Mechanical:MountingHole_Pad | MountingHole:MountingHole_4.3mm_M4_DIN965_Pad | ~ |  |  | 4mm ⌀ Mounting Holes |  |  |  |  |  |  |  |  |  |  |  |  | dnp
 |  | H2 | M4 | Mechanical:MountingHole_Pad | MountingHole:MountingHole_4.3mm_M4_DIN965_Pad | ~ |  |  | 4mm ⌀ Mounting Holes |  |  |  |  |  |  |  |  |  |  |  |  | dnp
 |  | H3 | M4 | Mechanical:MountingHole_Pad | MountingHole:MountingHole_4.3mm_M4_DIN965_Pad | ~ |  |  | 4mm ⌀ Mounting Holes |  |  |  |  |  |  |  |  |  |  |  |  | dnp
 |  | H4 | M4 | Mechanical:MountingHole_Pad | MountingHole:MountingHole_4.3mm_M4_DIN965_Pad | ~ |  |  | 4mm ⌀ Mounting Holes |  |  |  |  |  |  |  |  |  |  |  |  | dnp
 |  | H5 | M4 | Mechanical:MountingHole_Pad | MountingHole:MountingHole_4.3mm_M4_DIN965_Pad | ~ |  |  | 4mm ⌀ Mounting Holes |  |  |  |  |  |  |  |  |  |  |  |  | dnp
 |  | H6 | M4 | Mechanical:MountingHole_Pad | MountingHole:MountingHole_4.3mm_M4_DIN965_Pad | ~ |  |  | 4mm ⌀ Mounting Holes |  |  |  |  |  |  |  |  |  |  |  |  | dnp
 |  | H7 | M4 | Mechanical:MountingHole_Pad | MountingHole:MountingHole_4.3mm_M4_DIN965_Pad | ~ |  |  | 4mm ⌀ Mounting Holes |  |  |  |  |  |  |  |  |  |  |  |  | dnp
 |  | H8 | M4 | Mechanical:MountingHole_Pad | MountingHole:MountingHole_4.3mm_M4_DIN965_Pad | ~ |  |  | 4mm ⌀ Mounting Holes |  |  |  |  |  |  |  |  |  |  |  |  | dnp
 |  | H9 | M4 | Mechanical:MountingHole_Pad | MountingHole:MountingHole_4.3mm_M4_DIN965_Pad | ~ |  |  | 4mm ⌀ Mounting Holes |  |  |  |  |  |  |  |  |  |  |  |  | dnp
 |  | H10 | M4 | Mechanical:MountingHole_Pad | MountingHole:MountingHole_4.3mm_M4_DIN965_Pad | ~ |  |  | 4mm ⌀ Mounting Holes |  |  |  |  |  |  |  |  |  |  |  |  | dnp
 |  | H11 | M4 | Mechanical:MountingHole_Pad | MountingHole:MountingHole_4.3mm_M4_DIN965_Pad | ~ |  |  | 4mm ⌀ Mounting Holes |  |  |  |  |  |  |  |  |  |  |  |  | dnp
 |  | H12 | M4 | Mechanical:MountingHole_Pad | MountingHole:MountingHole_4.3mm_M4_DIN965_Pad | ~ |  |  | 4mm ⌀ Mounting Holes |  |  |  |  |  |  |  |  |  |  |  |  | dnp
 |  | H13 | M4 | Mechanical:MountingHole_Pad | MountingHole:MountingHole_4.3mm_M4_DIN965_Pad | ~ |  |  | 4mm ⌀ Mounting Holes |  |  |  |  |  |  |  |  |  |  |  |  | dnp
 |  | H14 | M4 | Mechanical:MountingHole_Pad | MountingHole:MountingHole_4.3mm_M4_DIN965_Pad | ~ |  |  | 4mm ⌀ Mounting Holes |  |  |  |  |  |  |  |  |  |  |  |  | dnp
 |  | H15 | M4 | Mechanical:MountingHole_Pad | MountingHole:MountingHole_4.3mm_M4_DIN965_Pad | ~ |  |  | 4mm ⌀ Mounting Holes |  |  |  |  |  |  |  |  |  |  |  |  | dnp
 |  | H16 | M4 | Mechanical:MountingHole_Pad | MountingHole:MountingHole_4.3mm_M4_DIN965_Pad | ~ |  |  | 4mm ⌀ Mounting Holes |  |  |  |  |  |  |  |  |  |  |  |  | dnp
 |  | H17 | M4 | Mechanical:MountingHole_Pad | MountingHole:MountingHole_4.3mm_M4_DIN965_Pad | ~ |  |  | 4mm ⌀ Mounting Holes |  |  |  |  |  |  |  |  |  |  |  |  | dnp
 |  | H18 | M4 | Mechanical:MountingHole_Pad | MountingHole:MountingHole_4.3mm_M4_DIN965_Pad | ~ |  |  | 4mm ⌀ Mounting Holes |  |  |  |  |  |  |  |  |  |  |  |  | dnp
 |  | H19 | M4 | Mechanical:MountingHole_Pad | MountingHole:MountingHole_4.3mm_M4_DIN965_Pad | ~ |  |  | 4mm ⌀ Mounting Holes |  |  |  |  |  |  |  |  |  |  |  |  | dnp
 |  | H20 | M4 | Mechanical:MountingHole_Pad | MountingHole:MountingHole_4.3mm_M4_DIN965_Pad | ~ |  |  | 4mm ⌀ Mounting Holes |  |  |  |  |  |  |  |  |  |  |  |  | dnp
 |  | H21 | M4 | Mechanical:MountingHole_Pad | MountingHole:MountingHole_4.3mm_M4_DIN965_Pad | ~ |  |  | 4mm ⌀ Mounting Holes |  |  |  |  |  |  |  |  |  |  |  |  | dnp
 |  | H22 | M4 | Mechanical:MountingHole_Pad | MountingHole:MountingHole_4.3mm_M4_DIN965_Pad | ~ |  |  | 4mm ⌀ Mounting Holes |  |  |  |  |  |  |  |  |  |  |  |  | dnp
 |  | H23 | M4 | Mechanical:MountingHole_Pad | MountingHole:MountingHole_4.3mm_M4_DIN965_Pad | ~ |  |  | 4mm ⌀ Mounting Holes |  |  |  |  |  |  |  |  |  |  |  |  | dnp
 |  | H24 | M4 | Mechanical:MountingHole_Pad | MountingHole:MountingHole_4.3mm_M4_DIN965_Pad | ~ |  |  | 4mm ⌀ Mounting Holes |  |  |  |  |  |  |  |  |  |  |  |  | dnp
 |  | H25 | M4 | Mechanical:MountingHole_Pad | MountingHole:MountingHole_4.3mm_M4_DIN965_Pad | ~ |  |  | 4mm ⌀ Mounting Holes |  |  |  |  |  |  |  |  |  |  |  |  | dnp
 |  | H26 | M4 | Mechanical:MountingHole_Pad | MountingHole:MountingHole_4.3mm_M4_DIN965_Pad | ~ |  |  | 4mm ⌀ Mounting Holes |  |  |  |  |  |  |  |  |  |  |  |  | dnp
 |  | H27 | M4 | Mechanical:MountingHole_Pad | MountingHole:MountingHole_4.3mm_M4_DIN965_Pad | ~ |  |  | 4mm ⌀ Mounting Holes |  |  |  |  |  |  |  |  |  |  |  |  | dnp
 |  | J1 | External IO 1 | Component Search Engine:Pluggable Terminal Blocks SDDC 1,5{slash} 14-PV-3,5 | Component Search Engine:Pluggable Terminal Blocks SDDC 1.5mm pitch 28 Pin | https://datasheet.datasheetarchive.com/originals/distributors/DKDS-4/71074.pdf | 1848684 | https://www.arrow.com/en/products/1848684/phoenix-contact?region=nac | Pluggable Terminal Blocks SDDC 1,5/ 14-PV-3,5 |  |  |  | 16 | Phoenix Contact | 1848684 | Phoenix Contact | 1848765 | 651-1848765 | 651-1848765 | https://www.mouser.co.uk/ProductDetail/Phoenix-Contact/1848765?qs=0kYgdqhPduEzMECWyGhNIA%3D%3D
 |  | J2 | DUT Power Out | Component Search Engine:Pluggable Terminal Blocks SDC 2,5{slash}12-PV-5,0 0-ZB | Component Search Engine:Pluggable Terminal Blocks SDC 2.5mm pitch 12 Pin | https://www.phoenixcontact.com/online/portal/us/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 | 1864134 | https://www.arrow.com/en/products/1864134/phoenix-contact | PCB direct plug, nominal cross section: 2.5 mm, color: green, nominal current: 12 A, rated voltage (III/2): 320 V, contact surface: Tin, Number of potentials: 12, Number of rows: 1, Number of positions per row: 12, number of connections: 12, product range: SDC 2,5/..-PV, pitch: 5 mm, connection method: Push-in spring connection, mounting: SKEDD - Direct plug-in technology, conductor/PCB connection direction: 90 ?, pin layout: Zigzag pinning W, solder pin [P]: 4.7 mm, Stecksystem: SKEDD, Locking: Snap-in lo |  |  |  | 16 | Phoenix Contact | 1864134 | Phoenix Contact | 1864134 | 651-1864134 | 651-1864134 | https://www.mouser.co.uk/ProductDetail/Phoenix-Contact/1864134?qs=k%252BwXAfPrzCmVYT8Zg0WKYg%3D%3D
 |  | J3 | CIB Power | Component Search Engine:Pluggable Terminal Blocks SDC 2,5{slash} 4-PV-5,0 0-ZB | Component Search Engine:Pluggable Terminal Blocks SDC 2.5mm pitch 4 Pin | https://datasheet.datasheetarchive.com/originals/distributors/DKDS-4/71512.pdf | 1864053 | https://www.arrow.com/en/products/1864053/phoenix-contact | Push spring connector 5mm pitch 4 way Phoenix Contact SDC Series 5mm Pitch Straight Pluggable Terminal Block, Plug with Plug In Termination, PCB Mount, 4 Way |  |  |  | 16 | Phoenix Contact | 1848684 | Phoenix Contact | 1864053 | 651-1864053 | 651-1864053 | https://www.mouser.co.uk/ProductDetail/Phoenix-Contact/1864053?qs=k%252BwXAfPrzCnElnWx0AGzqw%3D%3D
 |  | J4 | VFC 1-2 | Component Search Engine:Pluggable Terminal Blocks SDDC 1,5{slash} 6-PV-3,5 | Component Search Engine:Pluggable Terminal Blocks SDDC 1.5mm pitch 12 Pin | https://datasheet.datasheetarchive.com/originals/distributors/DKDS-4/71066.pdf | 1848684 | https://www.arrow.com/en/products/1848684/phoenix-contact?region=nac | Pluggable Terminal Blocks SDDC 1,5/ 6-PV-3,5 |  |  |  | 16 | Phoenix Contact | 1848684 | Phoenix Contact | 1848684 | 651-1848684 | 651-1848684 | https://www.mouser.co.uk/ProductDetail/Phoenix-Contact/1848684?qs=0kYgdqhPduG4EaaFk8CcwA%3D%3D
 |  | J5 | VFC 3-4 | Component Search Engine:Pluggable Terminal Blocks SDDC 1,5{slash} 6-PV-3,5 | Component Search Engine:Pluggable Terminal Blocks SDDC 1.5mm pitch 12 Pin | https://datasheet.datasheetarchive.com/originals/distributors/DKDS-4/71066.pdf | 1848684 | https://www.arrow.com/en/products/1848684/phoenix-contact?region=nac | Pluggable Terminal Blocks SDDC 1,5/ 6-PV-3,5 |  |  |  | 16 | Phoenix Contact | 1848684 | Phoenix Contact | 1848684 | 651-1848684 | 651-1848684 | https://www.mouser.co.uk/ProductDetail/Phoenix-Contact/1848684?qs=0kYgdqhPduG4EaaFk8CcwA%3D%3D
 |  | J6 | VFC 5-6 | Component Search Engine:Pluggable Terminal Blocks SDDC 1,5{slash} 6-PV-3,5 | Component Search Engine:Pluggable Terminal Blocks SDDC 1.5mm pitch 12 Pin | https://datasheet.datasheetarchive.com/originals/distributors/DKDS-4/71066.pdf | 1848684 | https://www.arrow.com/en/products/1848684/phoenix-contact?region=nac | Pluggable Terminal Blocks SDDC 1,5/ 6-PV-3,5 |  |  |  | 16 | Phoenix Contact | 1848684 | Phoenix Contact | 1848684 | 651-1848684 | 651-1848684 | https://www.mouser.co.uk/ProductDetail/Phoenix-Contact/1848684?qs=0kYgdqhPduG4EaaFk8CcwA%3D%3D
 |  | J7 | VFC 7-8 | Component Search Engine:Pluggable Terminal Blocks SDDC 1,5{slash} 6-PV-3,5 | Component Search Engine:Pluggable Terminal Blocks SDDC 1.5mm pitch 12 Pin | https://datasheet.datasheetarchive.com/originals/distributors/DKDS-4/71066.pdf | 1848684 | https://www.arrow.com/en/products/1848684/phoenix-contact?region=nac | Pluggable Terminal Blocks SDDC 1,5/ 6-PV-3,5 |  |  |  | 16 | Phoenix Contact | 1848684 | Phoenix Contact | 1848684 | 651-1848684 | 651-1848684 | https://www.mouser.co.uk/ProductDetail/Phoenix-Contact/1848684?qs=0kYgdqhPduG4EaaFk8CcwA%3D%3D
 |  | J8 | PT1-4 | Component Search Engine:Pluggable Terminal Blocks SDDC 1.5mm pitch 8 Pin | Component Search Engine:Pluggable Terminal Blocks SDDC 1.5mm pitch 8 Pin | https://datasheet.datasheetarchive.com/originals/distributors/DKDS-4/71064.pdf | 1848668 | https://www.arrow.com/en/products/1848668/phoenix-contact?region=nac | Pluggable Terminal Blocks SDDC 1,5/ 4-PV-3,5 |  |  |  | 16 | Phoenix Contact | 1848668 | Phoenix Contact | 1848668 | 651-1848668 | 651-1848668 | https://www.mouser.co.uk/ProductDetail/Phoenix-Contact/1848668?qs=0kYgdqhPduG1OA00GBngvA%3D%3D
 |  | J9 | Ch 1-4 | Component Search Engine:Pluggable Terminal Blocks SDC 2.5mm pitch 8 Pin | Component Search Engine:Pluggable Terminal Blocks SDC 2.5mm pitch 8 Pin | https://datasheet.datasheetarchive.com/originals/distributors/DKDS-4/71516.pdf | 1864095 | https://www.arrow.com/en/products/1864095/phoenix-contact?region=nac | Pluggable Terminal Blocks SDDC 1,5/ 4-PV-3,5 |  |  |  | 16 | Phoenix Contact | 1864095 | Phoenix Contact | 1864095 | 651-1864095 | 651-1864095 | https://www.mouser.co.uk/ProductDetail/Phoenix-Contact/1864095?qs=k%252BwXAfPrzCksf1U4gIWMgg%3D%3D
 |  | J10 | Ch 5-8 | Component Search Engine:Pluggable Terminal Blocks SDDC 1.5mm pitch 8 Pin | Component Search Engine:Pluggable Terminal Blocks SDDC 1.5mm pitch 8 Pin | https://datasheet.datasheetarchive.com/originals/distributors/DKDS-4/71064.pdf | 1848668 | https://www.arrow.com/en/products/1848668/phoenix-contact?region=nac | Pluggable Terminal Blocks SDDC 1,5/ 4-PV-3,5 |  |  |  | 16 | Phoenix Contact | 1848668 | Phoenix Contact | 1848668 | 651-1848668 | 651-1848668 | https://www.mouser.co.uk/ProductDetail/Phoenix-Contact/1848668?qs=0kYgdqhPduG1OA00GBngvA%3D%3D
 |  | J11 | Ch 9-12 | Component Search Engine:Pluggable Terminal Blocks SDDC 1.5mm pitch 8 Pin | Component Search Engine:Pluggable Terminal Blocks SDDC 1.5mm pitch 8 Pin | https://datasheet.datasheetarchive.com/originals/distributors/DKDS-4/71064.pdf | 1848668 | https://www.arrow.com/en/products/1848668/phoenix-contact?region=nac | Pluggable Terminal Blocks SDDC 1,5/ 4-PV-3,5 |  |  |  | 16 | Phoenix Contact | 1848668 | Phoenix Contact | 1848668 | 651-1848668 | 651-1848668 | https://www.mouser.co.uk/ProductDetail/Phoenix-Contact/1848668?qs=0kYgdqhPduG1OA00GBngvA%3D%3D
 |  | J12 | Ch 13-16 | Component Search Engine:Pluggable Terminal Blocks SDDC 1.5mm pitch 8 Pin | Component Search Engine:Pluggable Terminal Blocks SDDC 1.5mm pitch 8 Pin | https://datasheet.datasheetarchive.com/originals/distributors/DKDS-4/71064.pdf | 1848668 | https://www.arrow.com/en/products/1848668/phoenix-contact?region=nac | Pluggable Terminal Blocks SDDC 1,5/ 4-PV-3,5 |  |  |  | 16 | Phoenix Contact | 1848668 | Phoenix Contact | 1848668 | 651-1848668 | 651-1848668 | https://www.mouser.co.uk/ProductDetail/Phoenix-Contact/1848668?qs=0kYgdqhPduG1OA00GBngvA%3D%3D
 |  | J13 | Ch 17-20 | Component Search Engine:Pluggable Terminal Blocks SDDC 1.5mm pitch 8 Pin | Component Search Engine:Pluggable Terminal Blocks SDDC 1.5mm pitch 8 Pin | https://datasheet.datasheetarchive.com/originals/distributors/DKDS-4/71064.pdf | 1848668 | https://www.arrow.com/en/products/1848668/phoenix-contact?region=nac | Pluggable Terminal Blocks SDDC 1,5/ 4-PV-3,5 |  |  |  | 16 | Phoenix Contact | 1848668 | Phoenix Contact | 1848668 | 651-1848668 | 651-1848668 | https://www.mouser.co.uk/ProductDetail/Phoenix-Contact/1848668?qs=0kYgdqhPduG1OA00GBngvA%3D%3D
 |  | J14 | Ch 21-24 | Component Search Engine:Pluggable Terminal Blocks SDDC 1.5mm pitch 8 Pin | Component Search Engine:Pluggable Terminal Blocks SDDC 1.5mm pitch 8 Pin | https://datasheet.datasheetarchive.com/originals/distributors/DKDS-4/71064.pdf | 1848668 | https://www.arrow.com/en/products/1848668/phoenix-contact?region=nac | Pluggable Terminal Blocks SDDC 1,5/ 4-PV-3,5 |  |  |  | 16 | Phoenix Contact | 1848668 | Phoenix Contact | 1848668 | 651-1848668 | 651-1848668 | https://www.mouser.co.uk/ProductDetail/Phoenix-Contact/1848668?qs=0kYgdqhPduG1OA00GBngvA%3D%3D
 |  | J15 | External Equipment | Component Search Engine:Pluggable Terminal Blocks SDC 2,5{slash}12-PV-5,0 0-ZB | Component Search Engine:Pluggable Terminal Blocks SDC 2.5mm pitch 12 Pin | https://www.phoenixcontact.com/online/portal/us/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 | 1864134 | https://www.arrow.com/en/products/1864134/phoenix-contact | PCB direct plug, nominal cross section: 2.5 mm, color: green, nominal current: 12 A, rated voltage (III/2): 320 V, contact surface: Tin, Number of potentials: 12, Number of rows: 1, Number of positions per row: 12, number of connections: 12, product range: SDC 2,5/..-PV, pitch: 5 mm, connection method: Push-in spring connection, mounting: SKEDD - Direct plug-in technology, conductor/PCB connection direction: 90 ?, pin layout: Zigzag pinning W, solder pin [P]: 4.7 mm, Stecksystem: SKEDD, Locking: Snap-in lo |  |  |  | 16 | Phoenix Contact | 1864134 | Phoenix Contact | 1864134 | 651-1864134 | 651-1864134 | https://www.mouser.co.uk/ProductDetail/Phoenix-Contact/1864134?qs=k%252BwXAfPrzCmVYT8Zg0WKYg%3D%3D
 |  | J16 | External IO 2 | _SKDD Connectors:Pluggable Terminal Blocks SDDC 1.5mm pitch 32 Pin | Component Search Engine:Pluggable Terminal Blocks SDDC 1.5mm pitch 32 Pin | https://datasheet.datasheetarchive.com/originals/distributors/DKDS-4/71076.pdf | 1848781 | https://www.arrow.com/en/products/1848781/phoenix-contact | Pluggable Terminal Blocks SDDC 1,5/ 16-PV-3,5 |  |  |  | 16 | Phoenix Contact | 1848781 | Phoenix Contact | 1848781 | 651-1848781 | 651-1848781 | https://www.mouser.co.uk/ProductDetail/Phoenix-Contact/1848781?qs=0kYgdqhPduFxqrPfl%2FUWoA%3D%3D
 |  | J17 | LabJack1 | Component Search Engine:Pluggable Terminal Blocks SDDC 1,5{slash} 14-PV-3,5 | Component Search Engine:Pluggable Terminal Blocks SDDC 1.5mm pitch 28 Pin | https://datasheet.datasheetarchive.com/originals/distributors/DKDS-4/71074.pdf | 1848684 | https://www.arrow.com/en/products/1848684/phoenix-contact?region=nac | Pluggable Terminal Blocks SDDC 1,5/ 14-PV-3,5 |  |  |  | 16 | Phoenix Contact | 1848684 | Phoenix Contact | 1848765 | 651-1848765 | 651-1848765 | https://www.mouser.co.uk/ProductDetail/Phoenix-Contact/1848765?qs=0kYgdqhPduEzMECWyGhNIA%3D%3D
 |  | J18 | Labjack2 | Component Search Engine:Pluggable Terminal Blocks SDDC 1,5{slash} 14-PV-3,5 | Component Search Engine:Pluggable Terminal Blocks SDDC 1.5mm pitch 28 Pin | https://datasheet.datasheetarchive.com/originals/distributors/DKDS-4/71074.pdf | 1848684 | https://www.arrow.com/en/products/1848684/phoenix-contact?region=nac | Pluggable Terminal Blocks SDDC 1,5/ 14-PV-3,5 |  |  |  | 16 | Phoenix Contact | 1848684 | Phoenix Contact | 1848765 | 651-1848765 | 651-1848765 | https://www.mouser.co.uk/ProductDetail/Phoenix-Contact/1848765?qs=0kYgdqhPduEzMECWyGhNIA%3D%3D
 |  | K1 | ~ | Relay:G2RL-2-DC24 | _Connectors:2066-66.22.9.012.0000 | https://www.snapeda.com/parts/66.22.9.012.0000/Finder/datasheet/ |  |  | RELAY GEN PURPOSE DPDT 30A 12V | 2066-66.22.9.012.0000-ND | https://www.digikey.co.uk/en/products/detail/finder-relays-inc/66-22-9-012-0000/15288425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 |  |  | Finder Relays, Inc
 |  | K2 | PC357 | Relay:G2RL-2-DC24 | _Connectors:PC375 | https://pickercomponents.com/pdf/Relays/PC375.pdf |  |  | General Purpose Relay DPDT (2 Form C) 12VDC Coil Through Hole | 2634-PC375-2C-12S4-X-ND | https://www.digikey.co.uk/en/products/detail/picker-components/PC375-2C-12S4-X/12352856 |  |  | Picker Components | PC375-2C-12S4-X
 |  | K3 | ~ | Relay:G2RL-2-DC24 | _Connectors:2066-66.22.9.012.0000 | https://www.snapeda.com/parts/66.22.9.012.0000/Finder/datasheet/ |  |  | RELAY GEN PURPOSE DPDT 30A 12V | 2066-66.22.9.012.0000-ND | https://www.digikey.co.uk/en/products/detail/finder-relays-inc/66-22-9-012-0000/15288425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 |  |  | Finder Relays, Inc
 |  | K4 | PC357 | Relay:G2RL-2-DC24 | _Connectors:PC375 | https://pickercomponents.com/pdf/Relays/PC375.pdf |  |  | General Purpose Relay DPDT (2 Form C) 12VDC Coil Through Hole | 2634-PC375-2C-12S4-X-ND | https://www.digikey.co.uk/en/products/detail/picker-components/PC375-2C-12S4-X/12352856 |  |  | Picker Components | PC375-2C-12S4-X
 |  | K5 | G6K-2P DC12 | Relay:G2RL-2-DC24 | Relay_THT:Relay_DPDT_Omron_G6K-2P | https://omronfs.omron.com/en_US/ecb/products/pdf/en-g6k.pdf |  |  | Telecom Relay DPDT (2 Form C) Through Hole | Z117-ND | https://www.digikey.co.uk/en/products/detail/omron-electronics-inc-emc-div/G6K-2P-DC12/277853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 |  |  | Omron Electronics Inc-EMC Div | G6K-2P DC12
 |  | K6 | G6K-2P DC12 | Relay:G2RL-2-DC24 | Relay_THT:Relay_DPDT_Omron_G6K-2P | https://omronfs.omron.com/en_US/ecb/products/pdf/en-g6k.pdf |  |  | Telecom Relay DPDT (2 Form C) Through Hole | Z117-ND | https://www.digikey.co.uk/en/products/detail/omron-electronics-inc-emc-div/G6K-2P-DC12/277853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 |  |  | Omron Electronics Inc-EMC Div | G6K-2P DC12
 |  | K7 | G6K-2P DC12 | Relay:G2RL-2-DC24 | Relay_THT:Relay_DPDT_Omron_G6K-2P | https://omronfs.omron.com/en_US/ecb/products/pdf/en-g6k.pdf |  |  | Telecom Relay DPDT (2 Form C) Through Hole | Z117-ND | https://www.digikey.co.uk/en/products/detail/omron-electronics-inc-emc-div/G6K-2P-DC12/277853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 |  |  | Omron Electronics Inc-EMC Div | G6K-2P DC12
 |  | K8 | G6K-2P DC12 | Relay:G2RL-2-DC24 | Relay_THT:Relay_DPDT_Omron_G6K-2P | https://omronfs.omron.com/en_US/ecb/products/pdf/en-g6k.pdf |  |  | Telecom Relay DPDT (2 Form C) Through Hole | Z117-ND | https://www.digikey.co.uk/en/products/detail/omron-electronics-inc-emc-div/G6K-2P-DC12/277853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 |  |  | Omron Electronics Inc-EMC Div | G6K-2P DC12
 |  | K9 | G6K-2P DC12 | Relay:G2RL-2-DC24 | Relay_THT:Relay_DPDT_Omron_G6K-2P | https://omronfs.omron.com/en_US/ecb/products/pdf/en-g6k.pdf |  |  | Telecom Relay DPDT (2 Form C) Through Hole | Z117-ND | https://www.digikey.co.uk/en/products/detail/omron-electronics-inc-emc-div/G6K-2P-DC12/277853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 |  |  | Omron Electronics Inc-EMC Div | G6K-2P DC12
 |  | K10 | G6K-2P DC12 | Relay:G2RL-2-DC24 | Relay_THT:Relay_DPDT_Omron_G6K-2P | https://omronfs.omron.com/en_US/ecb/products/pdf/en-g6k.pdf |  |  | Telecom Relay DPDT (2 Form C) Through Hole | Z117-ND | https://www.digikey.co.uk/en/products/detail/omron-electronics-inc-emc-div/G6K-2P-DC12/277853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 |  |  | Omron Electronics Inc-EMC Div | G6K-2P DC12
 |  | K11 | G6K-2P DC12 | Relay:G2RL-2-DC24 | Relay_THT:Relay_DPDT_Omron_G6K-2P | https://omronfs.omron.com/en_US/ecb/products/pdf/en-g6k.pdf |  |  | Telecom Relay DPDT (2 Form C) Through Hole | Z117-ND | https://www.digikey.co.uk/en/products/detail/omron-electronics-inc-emc-div/G6K-2P-DC12/277853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 |  |  | Omron Electronics Inc-EMC Div | G6K-2P DC12
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
 |  | K40 | G6K-2P DC12 | Relay:G2RL-2-DC24 | Relay_THT:Relay_DPDT_Omron_G6K-2P | https://omronfs.omron.com/en_US/ecb/products/pdf/en-g6k.pdf |  |  | Telecom Relay DPDT (2 Form C) Through Hole | Z117-ND | https://www.digikey.co.uk/en/products/detail/omron-electronics-inc-emc-div/G6K-2P-DC12/277853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 |  |  | Omron Electronics Inc-EMC Div | G6K-2P DC12
 |  | K41 | G6K-2P DC12 | Relay:G2RL-2-DC24 | Relay_THT:Relay_DPDT_Omron_G6K-2P | https://omronfs.omron.com/en_US/ecb/products/pdf/en-g6k.pdf |  |  | Telecom Relay DPDT (2 Form C) Through Hole | Z117-ND | https://www.digikey.co.uk/en/products/detail/omron-electronics-inc-emc-div/G6K-2P-DC12/277853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 |  |  | Omron Electronics Inc-EMC Div | G6K-2P DC12
 |  | K42 | G6K-2P DC12 | Relay:G2RL-2-DC24 | Relay_THT:Relay_DPDT_Omron_G6K-2P | https://omronfs.omron.com/en_US/ecb/products/pdf/en-g6k.pdf |  |  | Telecom Relay DPDT (2 Form C) Through Hole | Z117-ND | https://www.digikey.co.uk/en/products/detail/omron-electronics-inc-emc-div/G6K-2P-DC12/277853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 |  |  | Omron Electronics Inc-EMC Div | G6K-2P DC12
 |  | K43 | G6K-2P DC12 | Relay:G2RL-2-DC24 | Relay_THT:Relay_DPDT_Omron_G6K-2P | https://omronfs.omron.com/en_US/ecb/products/pdf/en-g6k.pdf |  |  | Telecom Relay DPDT (2 Form C) Through Hole | Z117-ND | https://www.digikey.co.uk/en/products/detail/omron-electronics-inc-emc-div/G6K-2P-DC12/277853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 |  |  | Omron Electronics Inc-EMC Div | G6K-2P DC12
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
