philipmcgaw-cpi/CIB/CIB_Main_PCB - Mimic Octopus/CIB_Main_PCB.xlsx

Source: | /Users/philipmcgaw/Documents/CIB/CIB_Main_PCB - Mimic Octopus/CIB_Main_PCB.kicad_sch
Date: | Thursday, 14 July 2022 at 15:01:47
Tool: | Eeschema (6.0.6-1)-1
Generator: | /Applications/KiCad/KiCad.app/Contents/SharedSupport/plugins/bom_csv_grouped_by_value.py
Component Count: | 592
Collated Components:
Item | Qty | Required | Ordered | Reference(s) | Value | Description | Manufacturer | Manufacturer # | Farnell # | Farnell Price/Stock | Mouser # | Mouser Price/Stock | RS # | Height | dnp
1 | 4 | 16 | 20 | C1, C4, C5, C8 | 0.1uF 63V | 0.1 µF ±20% 63V Ceramic Capacitor X7R 1206 (3216 Metric) | Kemet | C1206C104MMREC7210 | 3288344 | https://uk.farnell.com/kemet/c1206c104mmrec7210/cap-0-1uf-63v-mlcc-1206/dp/3288344 | 80-C1206C104MMRECLR | https://www.mouser.co.uk/ProductDetail/KEMET/C1206C104MMREC7210?qs=55YtniHzbhDR5VfnqNM0aQ%3D%3D |  | 2
2 | 37 | 148 | 150 | C2, C3, C6, C7, C9, C11, C13, C18, C19, C21, C23, C28, C30, C32, C34, C36, C38, C40, C42, C44, C46, C48, C50, C52, C54, C56, C57, C59, C60, C61, C63, C64, C65, C67, C68, C69, C71 | 10uF 16 V | 10 ¬µF ¬±10% 16V Ceramic Capacitor X5R 1206 (3216 Metric) | Samsung Electro-Mechanics | CL31A106KOHNNNE |  |  |  |  |  | 2
3 | 23 | 92 | 100 | C10, C12, C14, C22, C24, C29, C31, C33, C35, C37, C39, C41, C43, C45, C47, C49, C51, C53, C55, C58, C62, C66, C70 | 22uF 16 V | 22 ¬µF ¬±20% 16V Ceramic Capacitor X5R 1206 (3216 Metric) | Samsung Electro-Mechanics | CL31A226KOHNNNE |  |  | 187-CL31A226KOHNNNE |  |  | 2
4 | 6 | 24 | 30 | C15, C16, C17, C25, C26, C27 | 470uF 20 V | 470 ¬µF 20 V Aluminum - Polymer Capacitors Radial, Can - SMD 14mOhm 1000 Hrs @ 125¬∞C | Panasonic Electronic | 20SVPK470M | 2947556 |  | 667-20SVPK470M |  | 1813171 | 12
5 | 1 | 4 | 10 | C20 | 100uF 25 V | 100 ¬µF 25 V Aluminum - Polymer Capacitors Radial, Can - SMD 24mOhm 5000 Hrs @ 105¬∞C | Panasonic Electronic | 25SVPF100M | 2982335 |  |  |  | 7955266P | 7
6 | 2 | 8 | 10 | D1, D3 | 56V | Zener Diode 56 V 5 W ¬±5% Surface Mount DO-214AA (SMB) | Comchip Technology | CZRB5370B-HF |  |  | 750-CZRB5370B-HF |  |  | 3
7 | 117 | 468 | 500 | D2, D4, D6, D7, D8, D9, D10, D11, D12, D13, D14, D15, D16, D17, D18, D20, D21, D22, D23, D24, D25, D26, D27, D28, D29, D30, D31, D32, D33, D34, D35, D36, D37, D38, D39, D40, D41, D42, D43, D44, D45, D46, D47, D48, D49, D50, D51, D52, D53, D54, D57, D58, D59, D64, D65, D66, D67, D68, D69, D70, D71, D72, D73, D74, D75, D76, D77, D78, D79, D80, D81, D82, D83, D84, D85, D86, D87, D88, D89, D90, D91, D92, D93, D94, D95, D96, D97, D98, D99, D100, D101, D102, D103, D104, D105, D106, D107, D108, D109, D110, D111, D112, D113, D114, D115, D116, D117, D118, D119, D120, D121, D122, D123, D124, D125, D126, D127 | Green | Green 570nm LED Indication - Discrete 2V 1206 (3216 Metric) | W√ºrth Elektronik | 150120VS75000 | 2322088 |  | 710-150120VS75000 |  | 8154237P | 2
8 | 6 | 24 | 30 | D5, D19, D60, D61, D62, D63 | 5V1 | Zener Diode 5.1 V 225 mW ¬±6% Surface Mount SOT-23-3 (TO-236) | Onsemi | BZX84C5V1LT3G | 2533366 |  | 863-SZBZX84C5V1LT3G |  |  | 2
9 | 1 | 4 | 10 | D55 | Red | Red 630nm LED Indication - Discrete 1.9V 1206 (3216 Metric) | W√ºrth Elektronik | 150120SS75000 | 2322087 |  | 710-150120SS75000 |  | 8154237P | 2
10 | 1 | 4 | 10 | D56 | Amber | Amber 605nm LED Indication - Discrete 2V 1206 (3216 Metric) | W√ºrth Elektronik | 150120AS75000 | 2322083 |  | 710-150120AS75000 |  | 8154237P | 2
11 | 1 | 4 | 10 | J1 | External IO 1 | 6 Position Wire to Board Terminal Block Vertical with Board 0.138" (3.50mm) Through Hole, SKEDD | Phoenix Contact | 1848684 | 2688595 |  | 651-1848765 | https://www.mouser.co.uk/ProductDetail/Phoenix-Contact/1848765?qs=0kYgdqhPduEzMECWyGhNIA%3D%3D |  | 16
12 | 1 | 4 | 10 | J2 | DUT Power Out | 12 Position Wire to Board Terminal Block Vertical with Board 0.197" (5.00mm) Through Hole, SKEDD | Phoenix Contact | 1864134 |  |  | 651-1864134 | https://www.mouser.co.uk/ProductDetail/Phoenix-Contact/1864134?qs=k%252BwXAfPrzCmVYT8Zg0WKYg%3D%3D |  | 16
13 | 1 | 4 | 10 | J3 | CIB Power | 6 Position Wire to Board Terminal Block Vertical with Board 0.138" (3.50mm) Through Hole, SKED | Phoenix Contact | 1848684 | 2688595 |  | 651-1864053 | https://www.mouser.co.uk/ProductDetail/Phoenix-Contact/1864053?qs=k%252BwXAfPrzCnElnWx0AGzqw%3D%3D |  | 16
14 | 1 | 4 | 10 | J4 | VFC 1-2 | 6 Position Wire to Board Terminal Block Vertical with Board 0.138" (3.50mm) Through Hole, SKED | Phoenix Contact | 1848684 | 2688595 |  | 651-1848684 | https://www.mouser.co.uk/ProductDetail/Phoenix-Contact/1848684?qs=0kYgdqhPduG4EaaFk8CcwA%3D%3D |  | 16
15 | 1 | 4 | 10 | J5 | VFC 3-4 | 6 Position Wire to Board Terminal Block Vertical with Board 0.138" (3.50mm) Through Hole, SKED | Phoenix Contact | 1848684 | 2688595 |  | 651-1848684 | https://www.mouser.co.uk/ProductDetail/Phoenix-Contact/1848684?qs=0kYgdqhPduG4EaaFk8CcwA%3D%3D |  | 16
16 | 1 | 4 | 10 | J6 | VFC 5-6 | 6 Position Wire to Board Terminal Block Vertical with Board 0.138" (3.50mm) Through Hole, SKED | Phoenix Contact | 1848684 | 2688595 |  | 651-1848684 | https://www.mouser.co.uk/ProductDetail/Phoenix-Contact/1848684?qs=0kYgdqhPduG4EaaFk8CcwA%3D%3D |  | 16
17 | 1 | 4 | 10 | J7 | VFC 7-8 | 6 Position Wire to Board Terminal Block Vertical with Board 0.138" (3.50mm) Through Hole, SKED | Phoenix Contact | 1848684 | 2688595 |  | 651-1848684 | https://www.mouser.co.uk/ProductDetail/Phoenix-Contact/1848684?qs=0kYgdqhPduG4EaaFk8CcwA%3D%3D |  | 16
18 | 1 | 4 | 10 | J8 | PT1-4 | 4 Position Wire to Board Terminal Block Vertical with Board 0.138" (3.50mm) Through Hole, SKEDD | Phoenix Contact | 1848668 | 2688593 |  | 651-1848668 | https://www.mouser.co.uk/ProductDetail/Phoenix-Contact/1848668?qs=0kYgdqhPduG1OA00GBngvA%3D%3D |  | 16
19 | 1 | 4 | 10 | J9 | Ch 1-4 | 8 Position Wire to Board Terminal Block Vertical with Board 0.197" (5.00mm) Through Hole, SKEDD | Phoenix Contact | 1864095 | 2535086 |  | 651-1864095 | https://www.mouser.co.uk/ProductDetail/Phoenix-Contact/1864095?qs=k%252BwXAfPrzCksf1U4gIWMgg%3D%3D |  | 16
20 | 1 | 4 | 10 | J10 | Ch 5-8 | 4 Position Wire to Board Terminal Block Vertical with Board 0.138" (3.50mm) Through Hole, SKEDD | Phoenix Contact | 1848668 | 2688593 |  | 651-1848668 | https://www.mouser.co.uk/ProductDetail/Phoenix-Contact/1848668?qs=0kYgdqhPduG1OA00GBngvA%3D%3D |  | 16
21 | 1 | 4 | 10 | J11 | Ch 9-12 | 4 Position Wire to Board Terminal Block Vertical with Board 0.138" (3.50mm) Through Hole, SKEDD | Phoenix Contact | 1848668 | 2688593 |  | 651-1848668 | https://www.mouser.co.uk/ProductDetail/Phoenix-Contact/1848668?qs=0kYgdqhPduG1OA00GBngvA%3D%3D |  | 16
22 | 1 | 4 | 10 | J12 | Ch 13-16 | 4 Position Wire to Board Terminal Block Vertical with Board 0.138" (3.50mm) Through Hole, SKEDD | Phoenix Contact | 1848668 | 2688593 |  | 651-1848668 | https://www.mouser.co.uk/ProductDetail/Phoenix-Contact/1848668?qs=0kYgdqhPduG1OA00GBngvA%3D%3D |  | 16
23 | 1 | 4 | 10 | J13 | Ch 17-20 | 4 Position Wire to Board Terminal Block Vertical with Board 0.138" (3.50mm) Through Hole, SKEDD | Phoenix Contact | 1848668 | 2688593 |  | 651-1848668 | https://www.mouser.co.uk/ProductDetail/Phoenix-Contact/1848668?qs=0kYgdqhPduG1OA00GBngvA%3D%3D |  | 16
24 | 1 | 4 | 10 | J14 | Ch 21-24 | 4 Position Wire to Board Terminal Block Vertical with Board 0.138" (3.50mm) Through Hole, SKEDD | Phoenix Contact | 1848668 | 2688593 |  | 651-1848668 | https://www.mouser.co.uk/ProductDetail/Phoenix-Contact/1848668?qs=0kYgdqhPduG1OA00GBngvA%3D%3D |  | 16
25 | 1 | 4 | 10 | J15 | External Equipment | 12 Position Wire to Board Terminal Block Vertical with Board 0.197" (5.00mm) Through Hole, SKEDD | Phoenix Contact | 1864134 |  |  | 651-1864134 | https://www.mouser.co.uk/ProductDetail/Phoenix-Contact/1864134?qs=k%252BwXAfPrzCmVYT8Zg0WKYg%3D%3D |  | 16
26 | 1 | 4 | 10 | J16 | External IO 2 | 16 Position Wire to Board Terminal Block Vertical with Board 0.138" (3.50mm) Through Hole, SKEDD | Phoenix Contact | 1848781 |  |  | 651-1848781 | https://www.mouser.co.uk/ProductDetail/Phoenix-Contact/1848781?qs=0kYgdqhPduFxqrPfl%2FUWoA%3D%3D |  | 16
27 | 1 | 4 | 10 | J17 | LabJack1 | 10 Position Wire to Board Terminal Block Vertical with Board 0.138" (3.50mm) Through Hole, SKED | Phoenix Contact | 1848684 |  |  | 651-1848765 | https://www.mouser.co.uk/ProductDetail/Phoenix-Contact/1848765?qs=0kYgdqhPduEzMECWyGhNIA%3D%3D |  | 16
28 | 1 | 4 | 10 | J18 | Labjack2 | 10 Position Wire to Board Terminal Block Vertical with Board 0.138" (3.50mm) Through Hole, SKED | Phoenix Contact | 1848684 |  |  | 651-1848765 | https://www.mouser.co.uk/ProductDetail/Phoenix-Contact/1848765?qs=0kYgdqhPduEzMECWyGhNIA%3D%3D |  | 16
29 | 2 | 8 | 10 | K1, K3 | ~ | General Purpose Relay DPDT (2 Form C) 12VDC Coil Through Hole | Finder Relays, Inc | 66.22.9.012.0000 | 1329685 |  |  |  | 4926855
30 | 18 | 72 | 80 | K2, K4, K52, K53, K54, K55, K56, K57, K58, K59, K60, K61, K62, K63, K64, K65, K66, K67 | PC357 | General Purpose Relay DPDT (2 Form C) 12VDC Coil Through Hole | Picker Components | PC375-2C-12S4-X
31 | 47 | 188 | 190 | K5, K6, K7, K8, K9, K10, K11, K12, K13, K14, K15, K16, K17, K18, K19, K20, K21, K22, K23, K24, K25, K26, K27, K28, K29, K30, K31, K32, K33, K34, K35, K36, K37, K38, K39, K40, K41, K42, K43, K44, K45, K46, K47, K48, K49, K50, K51 | G6K-2P DC12 | Telecom Relay DPDT (2 Form C) Through Hole | Omron Electronics Inc-EMC Div | G6K-2P DC12
32 | 48 | 192 | 200 | K68, K69, K70, K71, K72, K73, K74, K75, K76, K77, K78, K79, K80, K81, K82, K83, K84, K85, K86, K87, K88, K89, K90, K91, K92, K93, K94, K95, K96, K97, K98, K99, K100, K101, K102, K103, K104, K105, K106, K107, K108, K109, K110, K111, K112, K113, K114, K115 | G6K-2P DC12 | Telecom Relay DPDT (2 Form C) Through Hole | Omron Electronics Inc-EMC Div | G6K-2P DC12
33 | 1 | 4 | 10 | PS1 | TSR1-2450E | Non-Isolated PoL Module DC DC Converter 1 Output 5V 1A 7V - 36V Input | Traco Power | TSR1-2450E |  |  | TSR12450E |  |  | 11
34 | 1 | 4 | 10 | PS2 | TSR1-2433E | Non-Isolated PoL Module DC DC Converter 1 Output 3.3V 1A 6V - 36V Input | Traco Power | TSR1-2433E |  |  | TSR12433E |  |  | 11
35 | 10 | 40 | 40 | R1, R2, R3, R4, R5, R6, R7, R8, R9, R10 | 10k | 10 kOhms ±5% 0.5W, 1/2W Chip Resistor 1206 (3216 Metric) Moisture Resistant Thick Film | Yageo | RC1206JR-7W10KL |  |  |  |  |  | 1 | dnp
36 | 14 | 56 | 60 | R11, R13, R16, R18, R20, R23, R88, R91, R94, R100, R101, R102, R103, R105 | 0 | 0 Ohms Jumper 0.5W, 1/2W Chip Resistor 1206 (3216 Metric) Moisture Resistant Thick Film | Yageo | RC1206JR-7W0RL |  |  |  |  |  | 1 | dnp
37 | 4 | 16 | 20 | R12, R15, R19, R22 | 2 | 2 Ohms ±5% 0.5W, 1/2W Chip Resistor 1206 (3216 Metric) Automotive AEC-Q200, Pulse Withstanding Thick Film | Yageo | SR1206JR-7W2RL |  |  |  |  |  | 1
38 | 6 | 24 | 30 | R14, R21, R96, R97, R98, R99 | 100k | 100 kOhms ±1% 0.5W, 1/2W Chip Resistor 1206 (3216 Metric) Moisture Resistant Thick Film | Yageo | RC1206FR-7W100KL |  |  |  |  |  | 1
39 | 124 | 496 | 500 | R17, R24, R27, R28, R29, R30, R31, R32, R33, R34, R38, R39, R40, R41, R42, R46, R50, R51, R52, R53, R54, R55, R56, R57, R58, R59, R60, R61, R62, R63, R64, R65, R66, R67, R68, R69, R70, R71, R72, R73, R74, R75, R76, R77, R78, R79, R80, R81, R82, R83, R84, R85, R86, R107, R108, R109, R110, R111, R112, R113, R114, R115, R116, R117, R118, R119, R120, R121, R122, R123, R124, R125, R126, R127, R128, R129, R130, R131, R132, R133, R134, R135, R136, R137, R138, R139, R140, R141, R142, R143, R144, R145, R146, R147, R148, R149, R150, R151, R152, R153, R154, R155, R156, R157, R158, R159, R160, R161, R162, R163, R164, R165, R166, R167, R168, R169, R170, R171, R172, R173, R174, R175, R176, R177 | 1k2 | 1.2 kOhms ±1% 0.5W, 1/2W Chip Resistor 1206 (3216 Metric) Moisture Resistant Thick Film | Yageo | RC1206FR-7W1K2L |  |  |  |  |  | 1
40 | 2 | 8 | 10 | R25, R43 | 6k2 | 6.2 kOhms ±5% 0.5W, 1/2W Chip Resistor 1206 (3216 Metric) Automotive AEC-Q200, Pulse Withstanding Thick Film | Yageo | SR1206JR-7W6K2L |  |  |  |  |  | 1
41 | 2 | 8 | 10 | R26, R44 | 3k3 | 3.3 kOhms ±1% 0.5W, 1/2W Chip Resistor 1206 (3216 Metric) Automotive AEC-Q200, Pulse Withstanding Thick Film | Yageo | SR1206FR-7W3K3L |  |  |  |  |  | 1
42 | 1 | 4 | 10 | R35 | 82.5R 0.1% | 82.5 Ohms ±0.1% 0.25W, 1/4W Chip Resistor 1206 (3216 Metric) Automotive AEC-Q200 Thin Film | Panasonic Electronics Company | ERA-8AEB82R5V |  |  |  |  |  | 1
43 | 1 | 4 | 10 | R36 | 102R 0.1% | 102 Ohms ±0.1% 0.25W, 1/4W Chip Resistor 1206 (3216 Metric) Automotive AEC-Q200 Thin Film | Panasonic Electronics Company | ERA-8AEB1020V |  |  | 667-ERA-8AEB1020V |  |  | 1
44 | 1 | 4 | 10 | R37 | 115R 0.1% | 115 Ohms ±0.1% 0.25W, 1/4W Chip Resistor 1206 (3216 Metric) Automotive AEC-Q200 Thin Film | Panasonic Electronics Company | ERA-8AEB1150V |  |  | 667-ERA-8AEB1150V |  |  | 1
45 | 2 | 8 | 10 | R45, R49 | 5k1 | 5.1 kOhms ±5% 0.5W, 1/2W Chip Resistor 1206 (3216 Metric) Automotive AEC-Q200, Pulse Withstanding Thick Film | Yageo | SR1206JR-7W5K1L |  |  |  |  |  | 1
46 | 1 | 4 | 10 | R47 | 330 | 330 Ohms ±5% 0.5W, 1/2W Chip Resistor 1206 (3216 Metric) Moisture Resistant Thick Film | Yageo | RC1206JR-7W330RL |  |  |  |  |  | 1
47 | 1 | 4 | 10 | R48 | 120 | 120 Ohms ±1% 0.25W, 1/4W Chip Resistor 1206 (3216 Metric) Automotive AEC-Q200, Moisture Resistant Thick Film | TE Connectivity Passive Products | CRGCQ1206F120R |  |  |  |  |  | 1
48 | 4 | 16 | 20 | R87, R90, R93, R104 | 8k2 | 8.2 kOhms ±5% 0.125W, 1/8W Chip Resistor 0805 (2012 Metric) Automotive AEC-Q200 Thick Film | Panasonic Electronics Company | ERJ-6GEYJ822V |  |  |  |  |  | 1
49 | 4 | 16 | 20 | R89, R92, R95, R106 | 2k | 2 kOhms ±1% 0.5W, 1/2W Chip Resistor 1206 (3216 Metric) Automotive AEC-Q200, Moisture Resistant Thick Film | Yageo | AC1206FR-7W2KL |  |  |  |  |  | 1
50 | 1 | 4 | 10 | TP1 | TP 5V0 |  |  |  |  |  |  |  |  |  | dnp
51 | 1 | 4 | 10 | TP2 | TP 3V3 |  |  |  |  |  |  |  |  |  | dnp
52 | 1 | 4 | 10 | TP3 | TP 12V3 |  |  |  |  |  |  |  |  |  | dnp
53 | 1 | 4 | 10 | TP4 | TP GND |  |  |  |  |  |  |  |  |  | dnp
54 | 2 | 8 | 10 | U1, U2 | HMSR_30-SMS | Current Sensor 30A 1 Channel Hall Effect, Open Loop Bidirectional 16-PowerSOIC (0.295", 7.50mm Width), 10 Leads | LEM USA Inc | HMSR 30-SMS
55 | 15 | 60 | 60 | U3, U5, U6, U11, U13, U15, U18, U20, U22, U23, U24, U28, U30, U35, U37 | ULN2803A | Bipolar (BJT) Transistor Array 8 NPN Darlington 50V 500mA 2.25W Through Hole 18-DIP | STMicroelectronics | ULN2803A |  |  | 511-ULN2803A |  |  | 5
56 | 15 | 60 | 60 | U4, U7, U8, U10, U12, U14, U16, U17, U19, U21, U25, U26, U27, U29, U36 | 74HC595 | Shift Shift Register 1 Element 8 Bit 16-PDIP | Texsas Instruments | SN74HC595N |  |  |  |  |  | 5
57 | 4 | 16 | 20 | U31, U32, U33, U34 | HMSR_8-SMS | Current Sensor 8A 1 Channel Hall Effect, Open Loop Bidirectional 16-PowerSOIC (0.295", 7.50mm Width), 10 Leads | LEM USA Inc | HMSR 8-SMS |  |  |  |  |  | 5
58 | 1 | 4 | 10 | XA1 | Arduino_Mega2560_Shield |  |  |  |  |  |  |  |  |  | dnp
