philipmcgaw-cpi/CIB/Isomon CIB partially complete BON direct design.pdf

# ChargePoint, Inc (c) 2022 MDS ISOMON PCBA FCT CIB

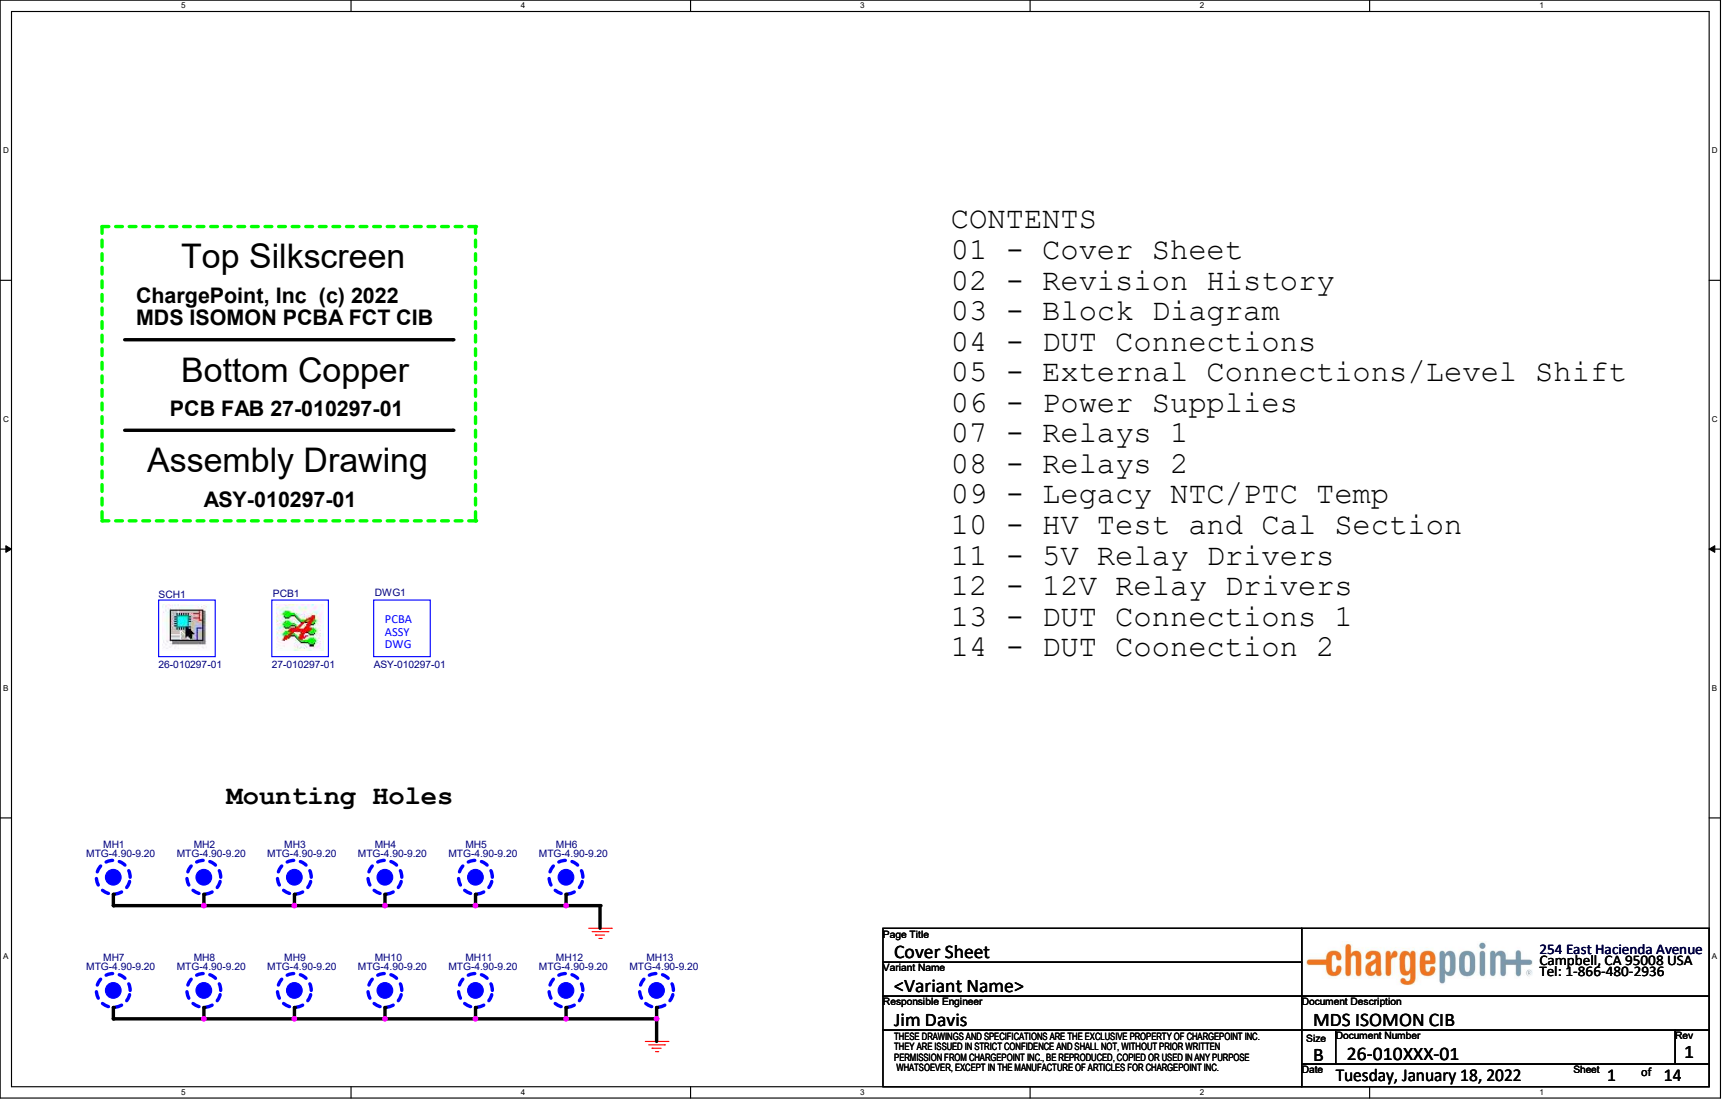
[picture p20: page 1]
ASY-010297-01; PCB FAB 27-010297-01; Bottom Copper; Top Silkscreen; Assembly Drawing; Mounting Holes; Size Document Number; Rev; WHATSOEVER, EXCEPT IN THE MANUFACTURE OF ARTICLES FOR CHARGEPOINT INC.; Date; Responsible Engineer; Document Description; Variant Name; Page Title; Sheet; 26-010XXX-01; Tuesday, January 18, 2022; Jim Davis; <Variant Name>; Cover Sheet; 254 East Hacienda Avenue; PCB1; MH5 MTG-4.90-9.20; MH2 MTG-4.90-9.20; MH4 MTG-4.90-9.20; MH1 MTG-4.90-9.20; MH6 MTG-4.90-9.20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

CONTENTS
01 - Cover Sheet
02 - Revision History
03 - Block Diagram
04 - DUT Connections
05 - External Connections/Level Shift
06 - Power Supplies
07 - Relays 1
08 - Relays 2
09 - Legacy NTC/PTC Temp
10 - HV Test and Cal Section
11 - 5V Relay Drivers
12 - 12V Relay Drivers
13 - DUT Connections 1
14 - DUT Coonection 2

Campbell, CA 95008 USA
Tel: 1-866-480-2936

MDS ISOMON CIB

THESE DRAWINGS AND SPECIFICATIONS ARE THE EXCLUSIVE PROPERTY OF CHARGEPOINT INC.
THEY ARE ISSUED IN STRICT CONFIDENCE AND SHALL NOT, WITHOUT PRIOR WRITTEN
PERMISSION FROM CHARGEPOINT INC., BE REPRODUCED, COPIED OR USED IN ANY PURPOSE

Version (Revision) | Eng | Date / Revision / Change Description
26-010XXX-01(1) | JD

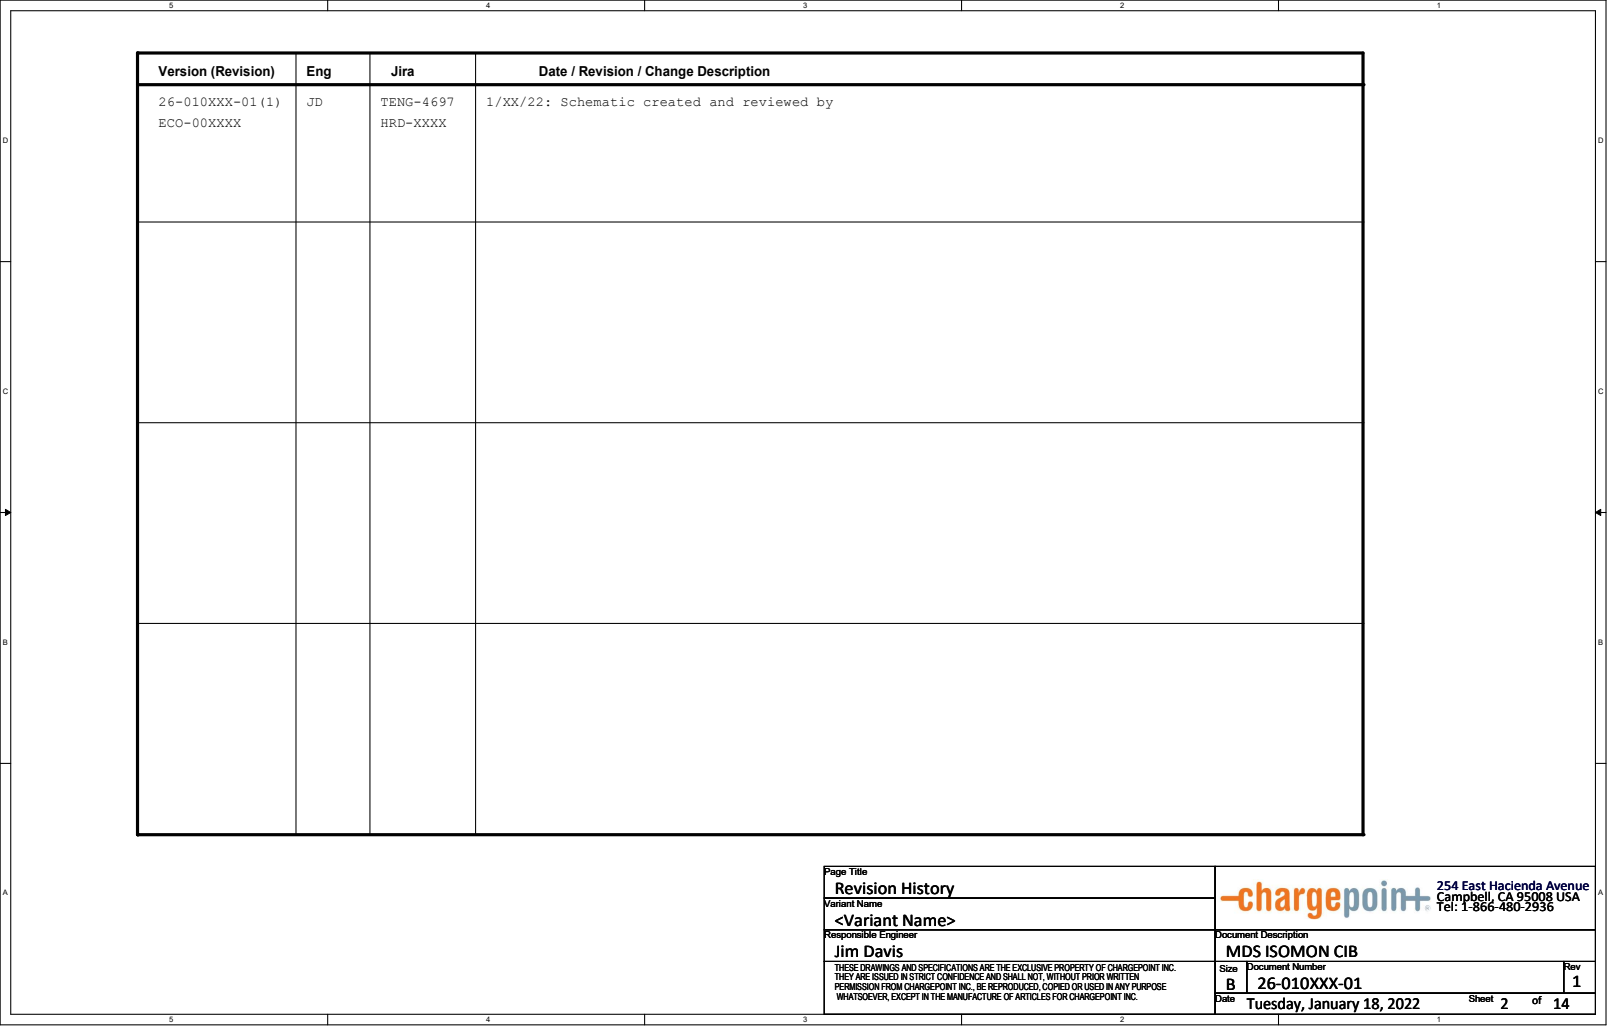
[picture p21: page 2]
Jira; TENG-4697; ECO-00XXXX; HRD-XXXX; Size Document Number; Rev; WHATSOEVER, EXCEPT IN THE MANUFACTURE OF ARTICLES FOR CHARGEPOINT INC.; Date; Responsible Engineer; Document Description; Variant Name; Page Title; Sheet; 26-010XXX-01; Tuesday, January 18, 2022; Jim Davis; <Variant Name>; Revision History; 254 East Hacienda Avenue

1/XX/22: Schematic created and reviewed by

Campbell, CA 95008 USA
Tel: 1-866-480-2936

MDS ISOMON CIB

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

DUT CONNECTORS | BLOCK DIAGRAM

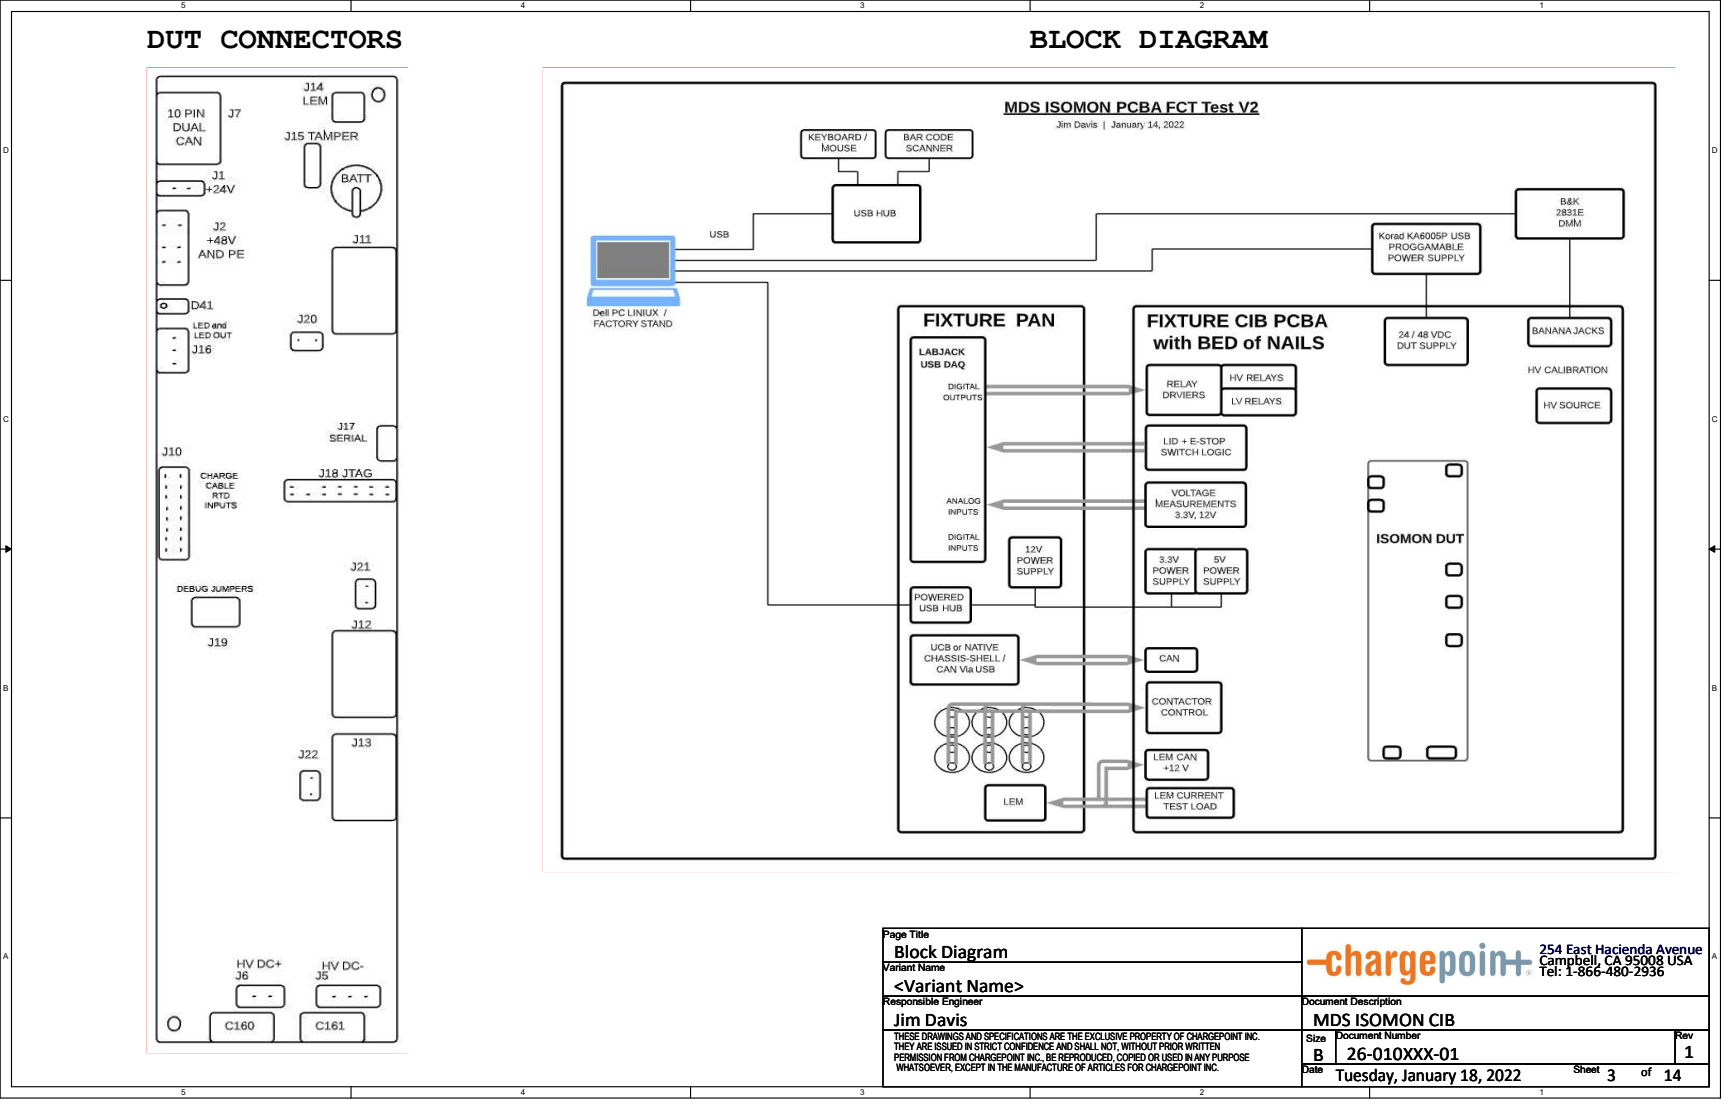
[picture p22: page 3]
Size Document Number; Rev; WHATSOEVER, EXCEPT IN THE MANUFACTURE OF ARTICLES FOR CHARGEPOINT INC.; Date; Responsible Engineer; Document Description; Variant Name; Page Title; Sheet; 26-010XXX-01; Tuesday, January 18, 2022; Jim Davis; <Variant Name>; Block Diagram; 254 East Hacienda Avenue

Campbell, CA 95008 USA
Tel: 1-866-480-2936

MDS ISOMON CIB

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

# "PCAN-USB" DEVICE: FEMALE DB9

# MT MT J50

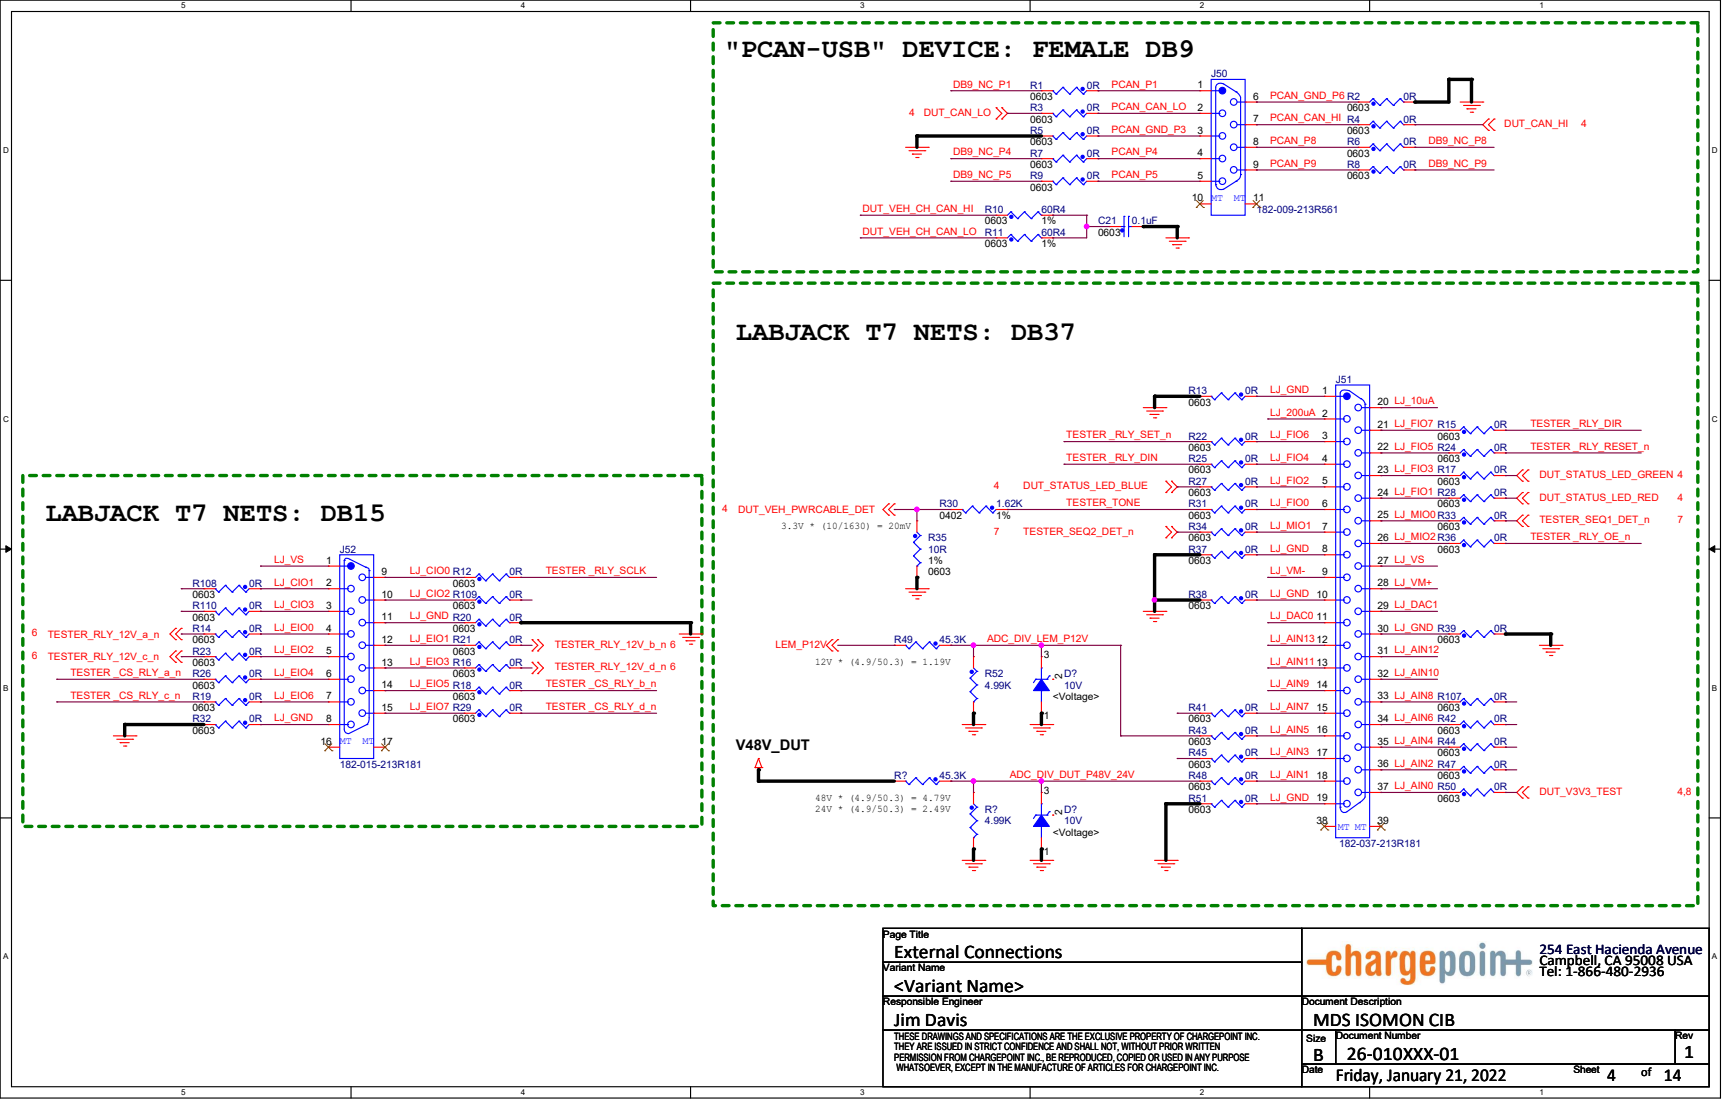
[picture p23: page 4]
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

# 5V RELAY LEVEL SHIFT

### V5V0_Tester

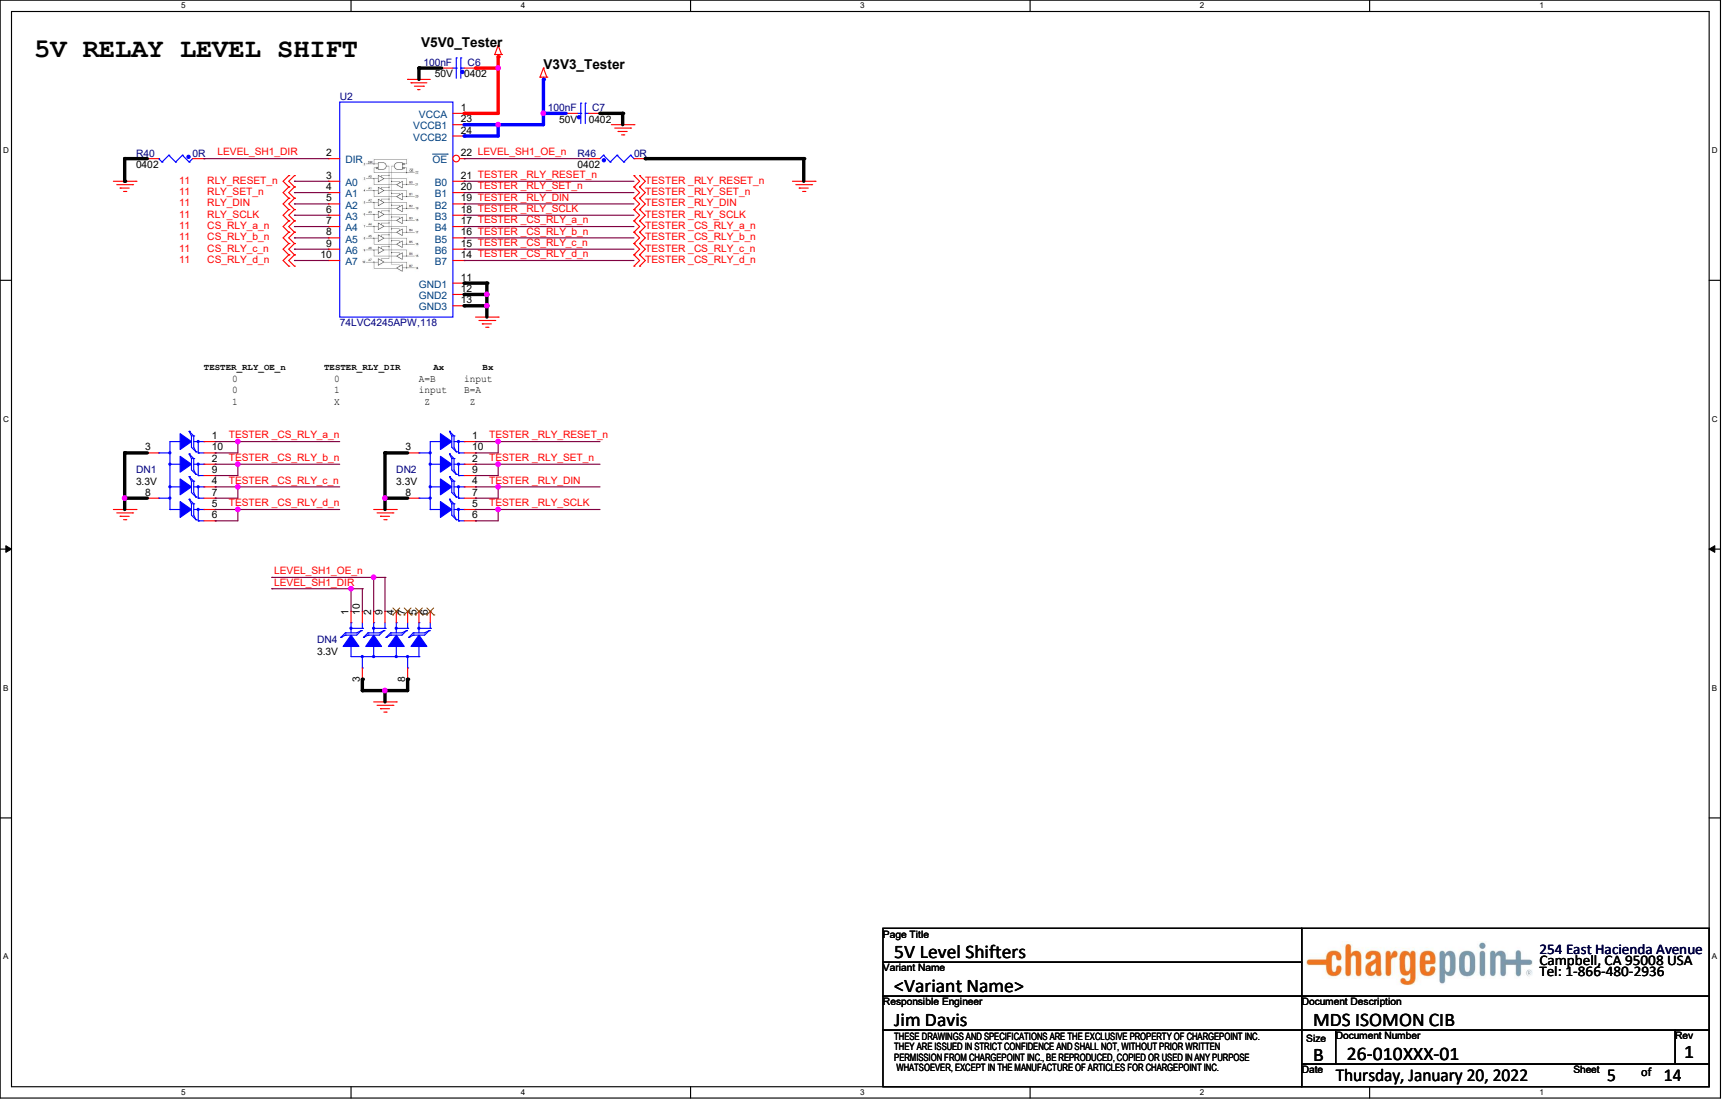
[picture p24: page 5]
input; 0 input 1; TESTER_RLY_OE_n; TESTER_RLY_DIR; V3V3_Tester; 11 RLY_SET_n 11 RLY_DIN; 11 RLY_RESET_n; 11 RLY_SCLK 11 CS_RLY_a_n 11 CS_RLY_b_n 11 CS_RLY_c_n; CS_RLY_d_n; TESTER _CS_RLY_d_n; TESTER _CS_RLY_c_n; TESTER _CS_RLY_b_n; TESTER _CS_RLY_a_n; TESTER _RLY_SCLK; TESTER _RLY_DIN; TESTER _RLY_SET_n; TESTER _RLY_RESET_n; Size Document Number; Rev; WHATSOEVER, EXCEPT IN THE MANUFACTURE OF ARTICLES FOR CHARGEPOINT INC.; Date; Responsible Engineer; Document Description; Variant Name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

Campbell, CA 95008 USA
Tel: 1-866-480-2936

MDS ISOMON CIB

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

# TESTER POWER RAILS: 12V, 5V, 3.3V AND DUT 48V

## 5V @ 1A MAX

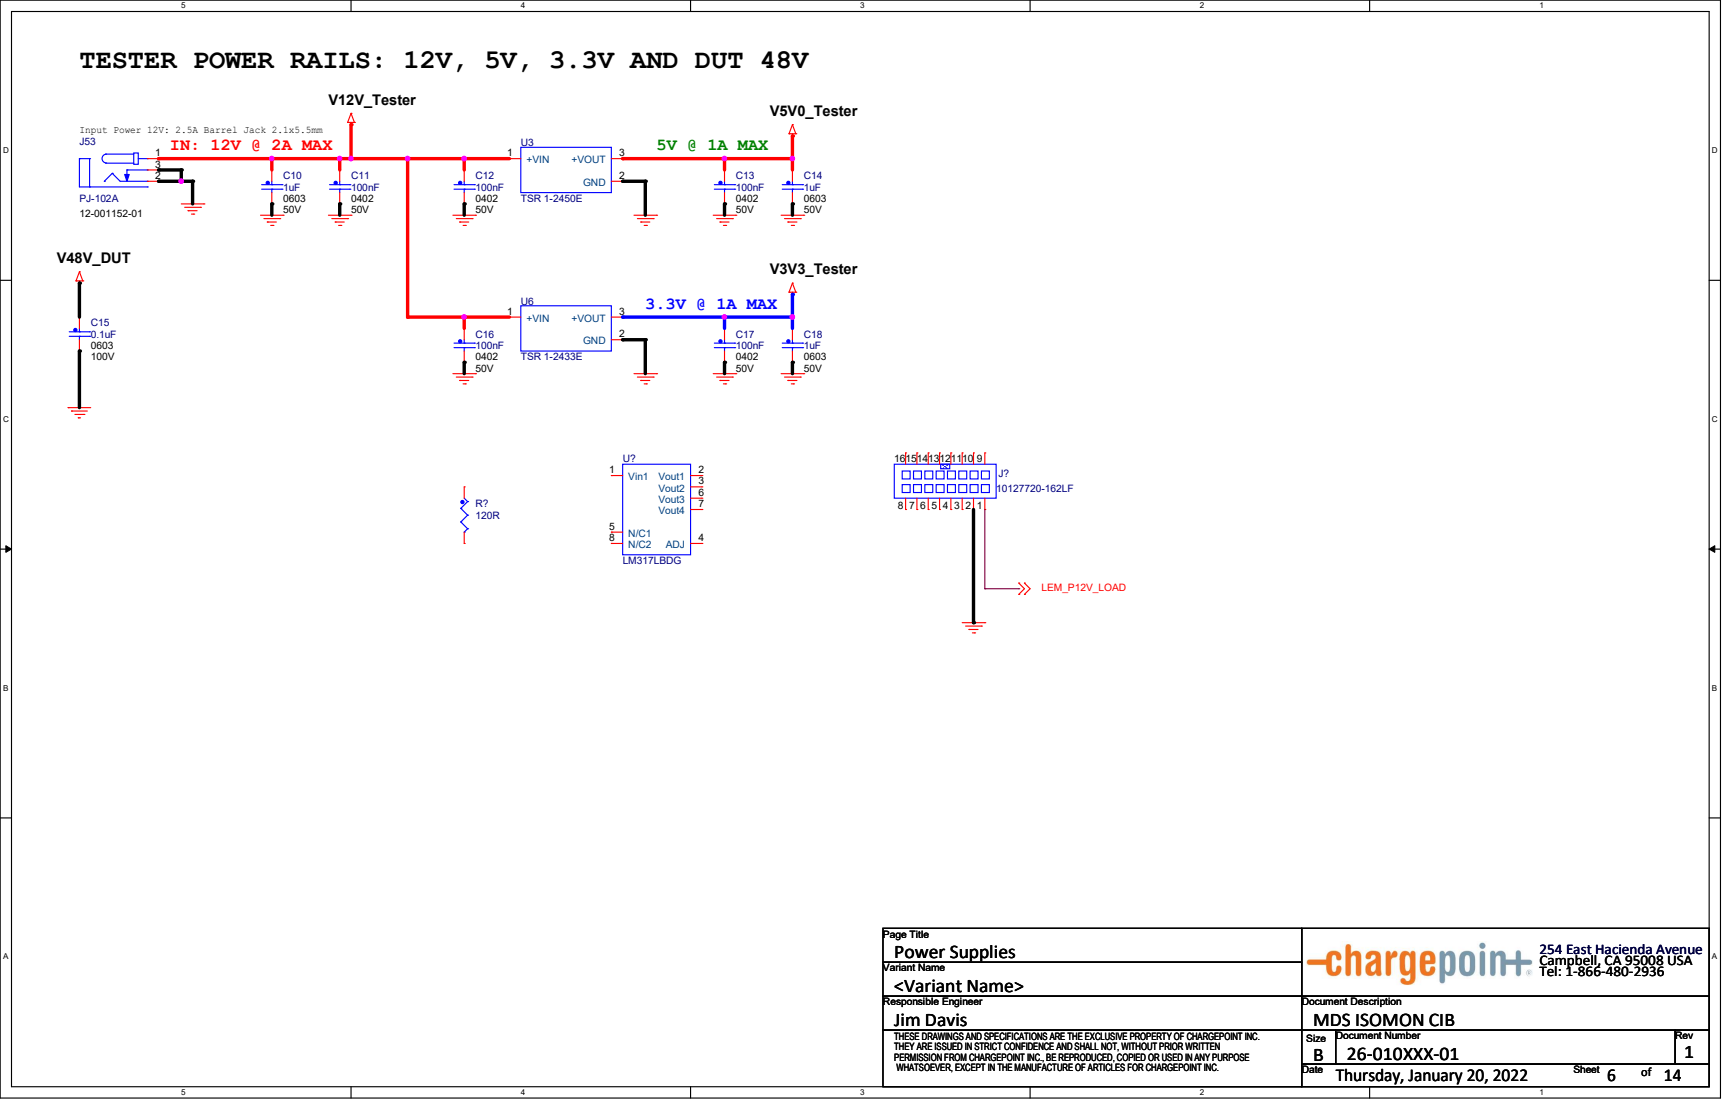
[picture p25: page 6]

Input Power 12V: 2.5A Barrel Jack 2.1x5.5mm

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

# DUT POWER INPUT AND DUT OUTPUT TESTS, 5V RELAYS

# BUS BAR THERMAL SW TEST

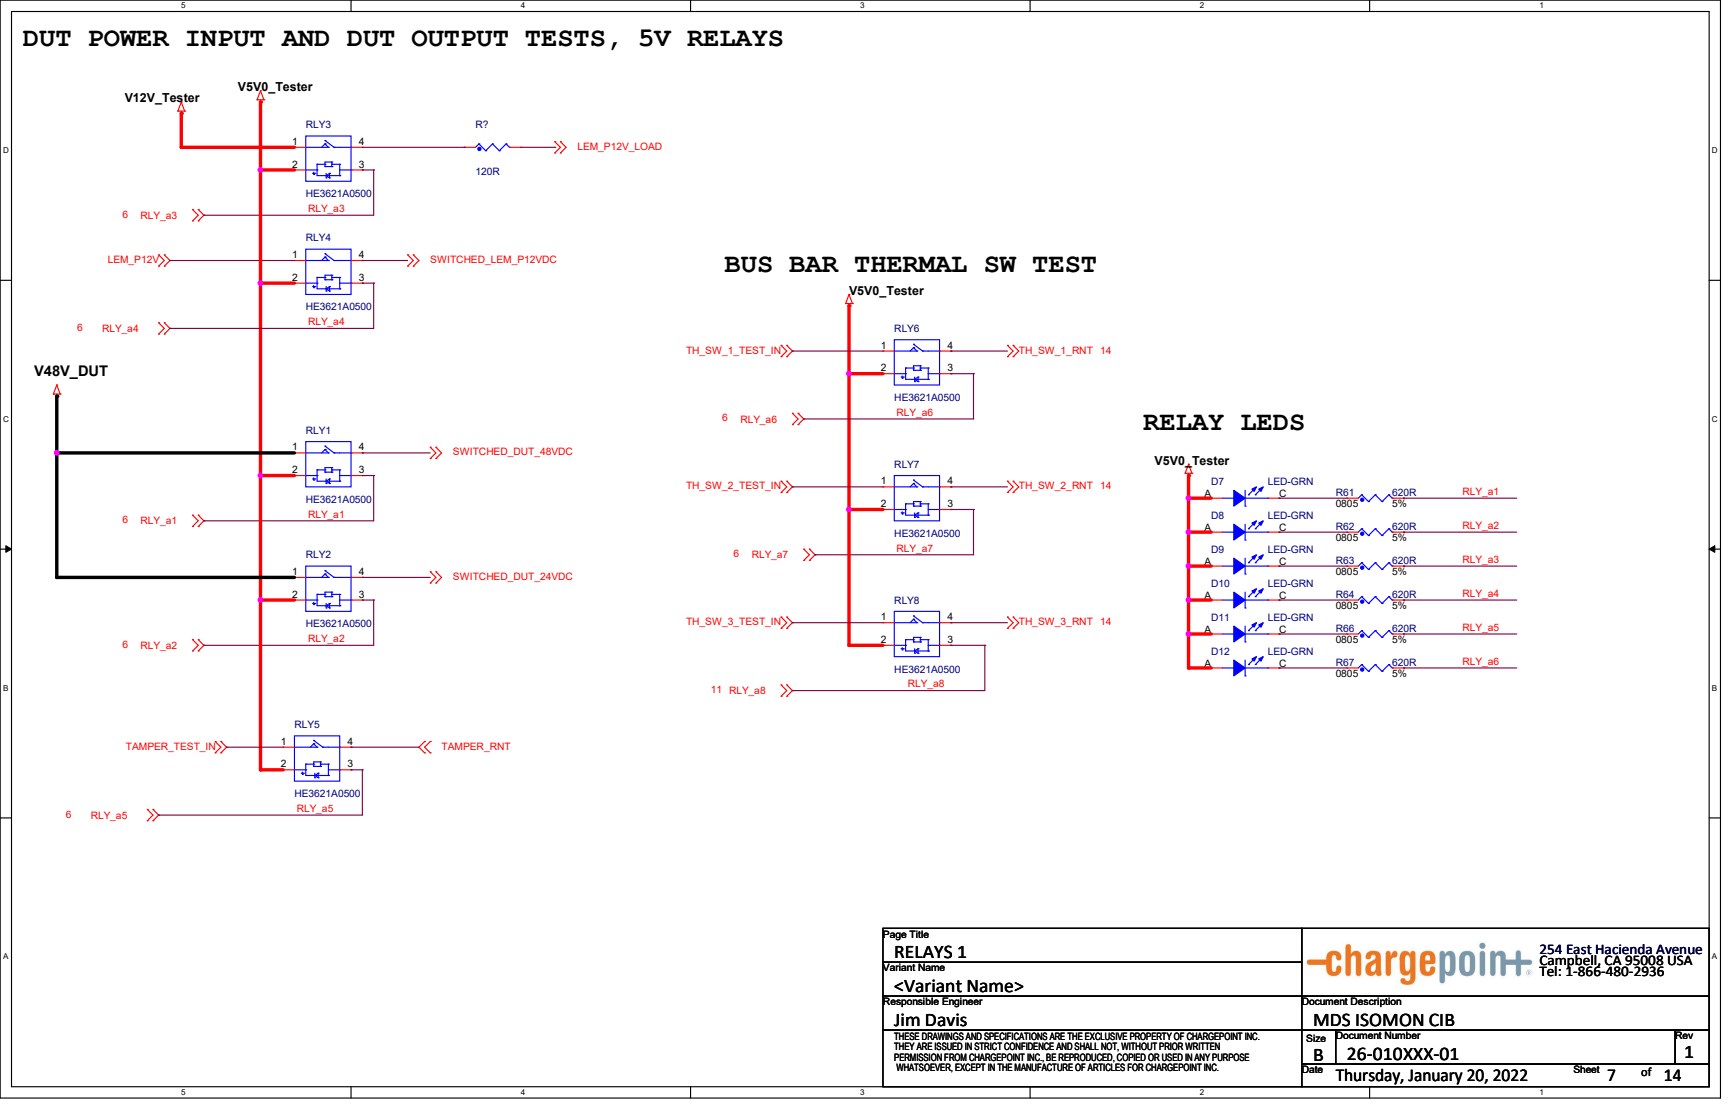
[picture p26: page 7]
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

# DUT POWER RAILS TO DC LOAD

# RELAY LEDS

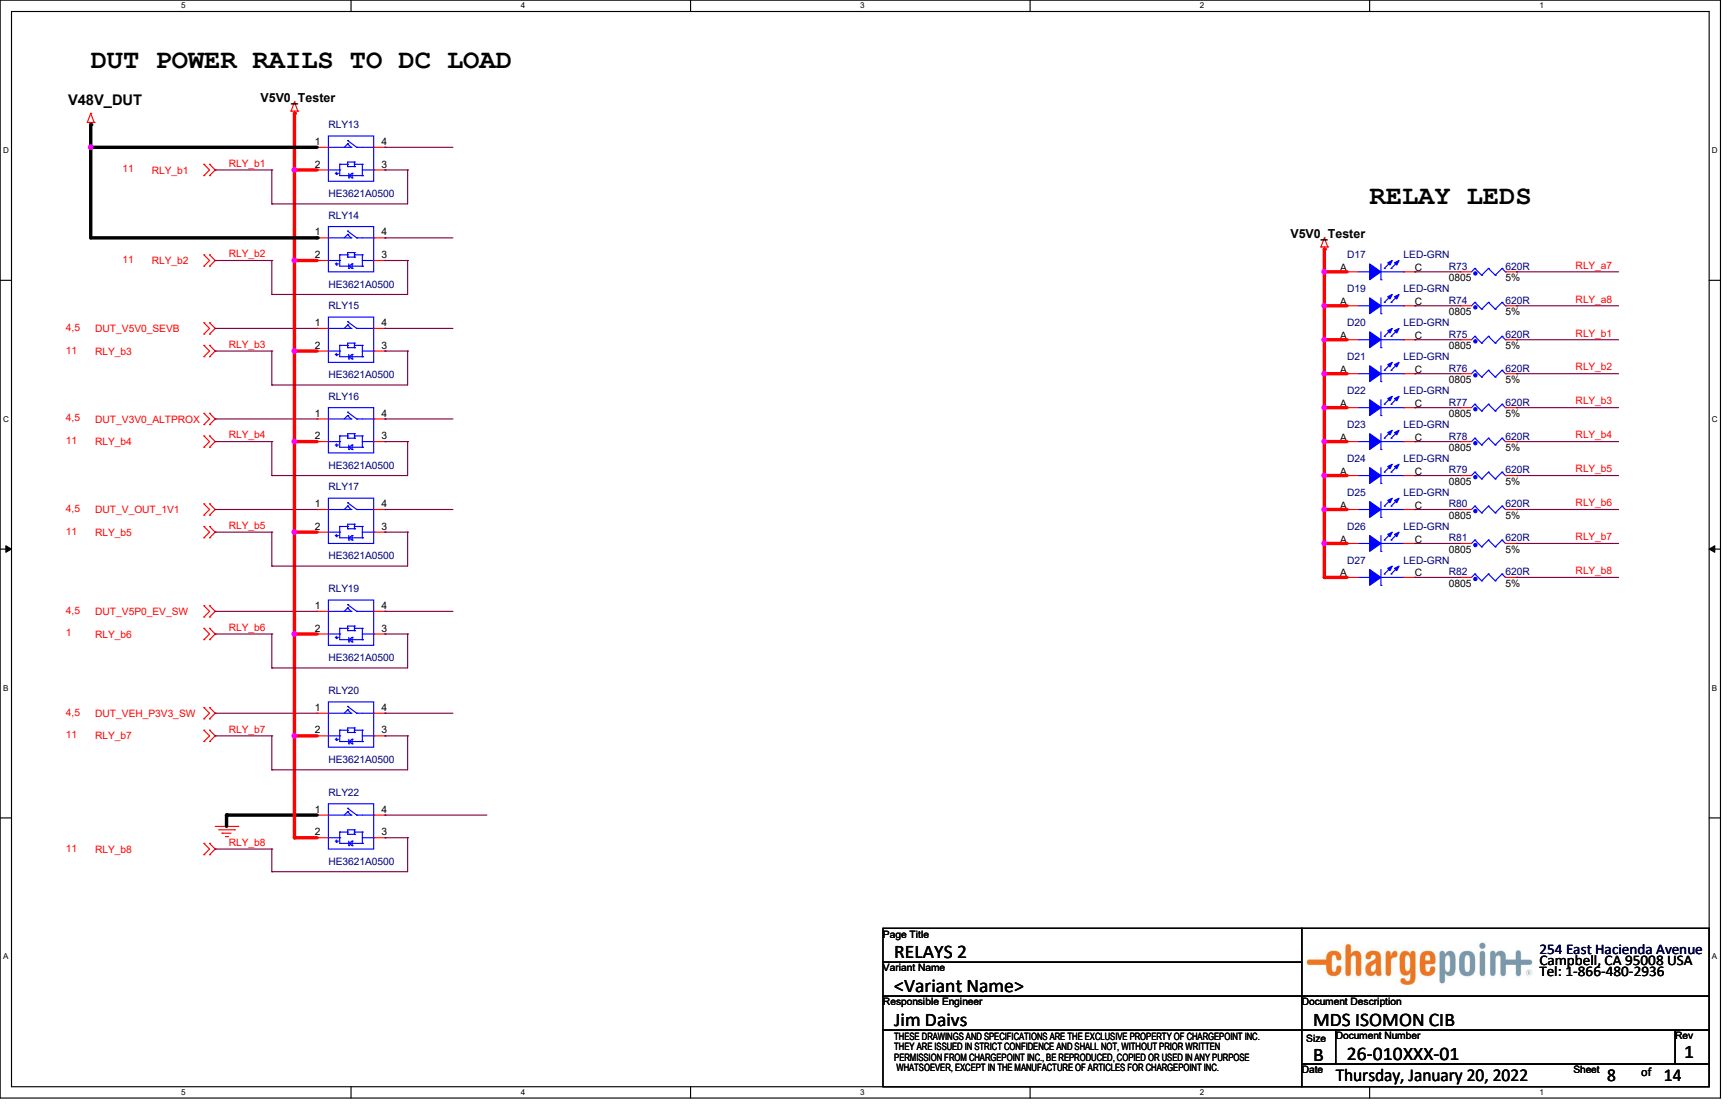
[picture p27: page 8]
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

TMP0 | RELAY LEDS

## V5V0_Tester

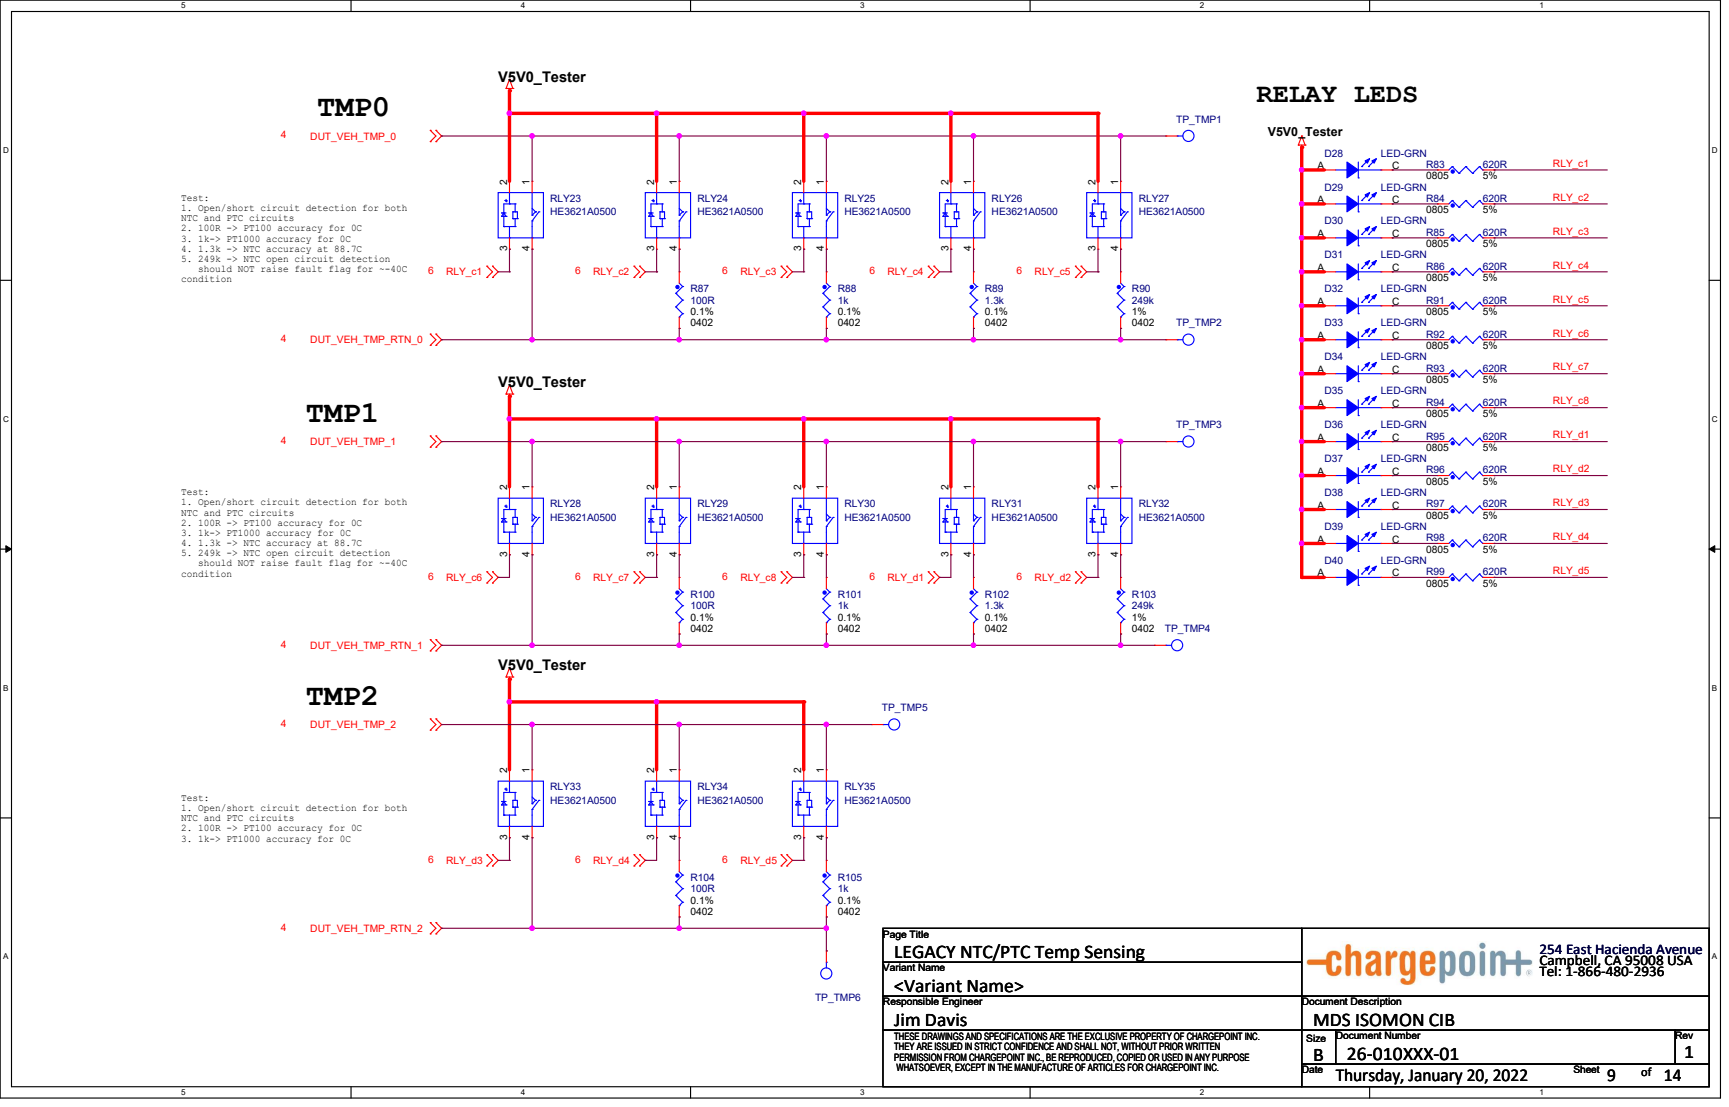
[picture p28: page 9]

Test:
1. Open/short circuit detection for both
NTC and PTC circuits
2. 100R -> PT100 accuracy for 0C
3. 1k-> PT1000 accuracy for 0C
4. 1.3k -> NTC accuracy at 88.7C
5. 249k -> NTC open circuit detection
should NOT raise fault flag for ~-40C
condition

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

# DUT HV DC+ CONNECTOR

# DUT HV DC- CONNECTOR

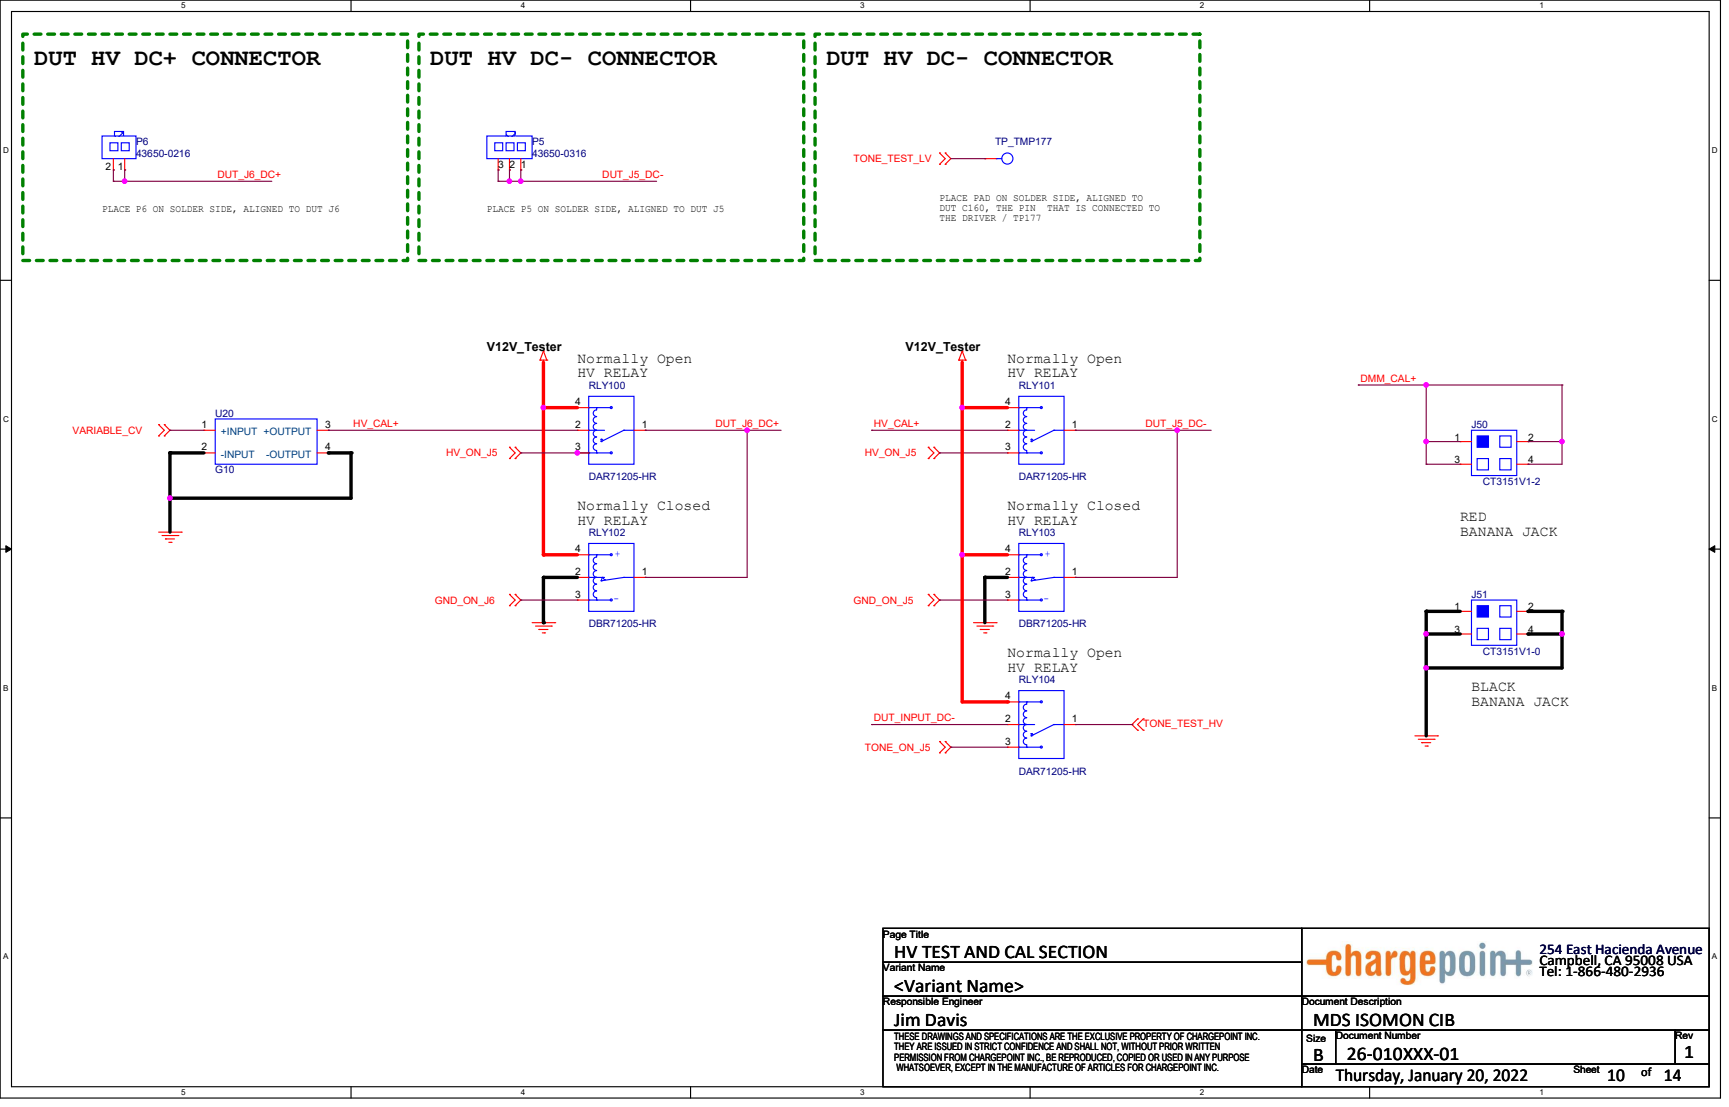
[picture p29: page 10]

DUT HV DC- CONNECTOR

PLACE PAD ON SOLDER SIDE, ALIGNED TO
DUT C160, THE PIN THAT IS CONNECTED TO
THE DRIVER / TP177

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

# 5V, 0.5A RELAY DRIVERS

V5V0_Tester | V5V0_Tester

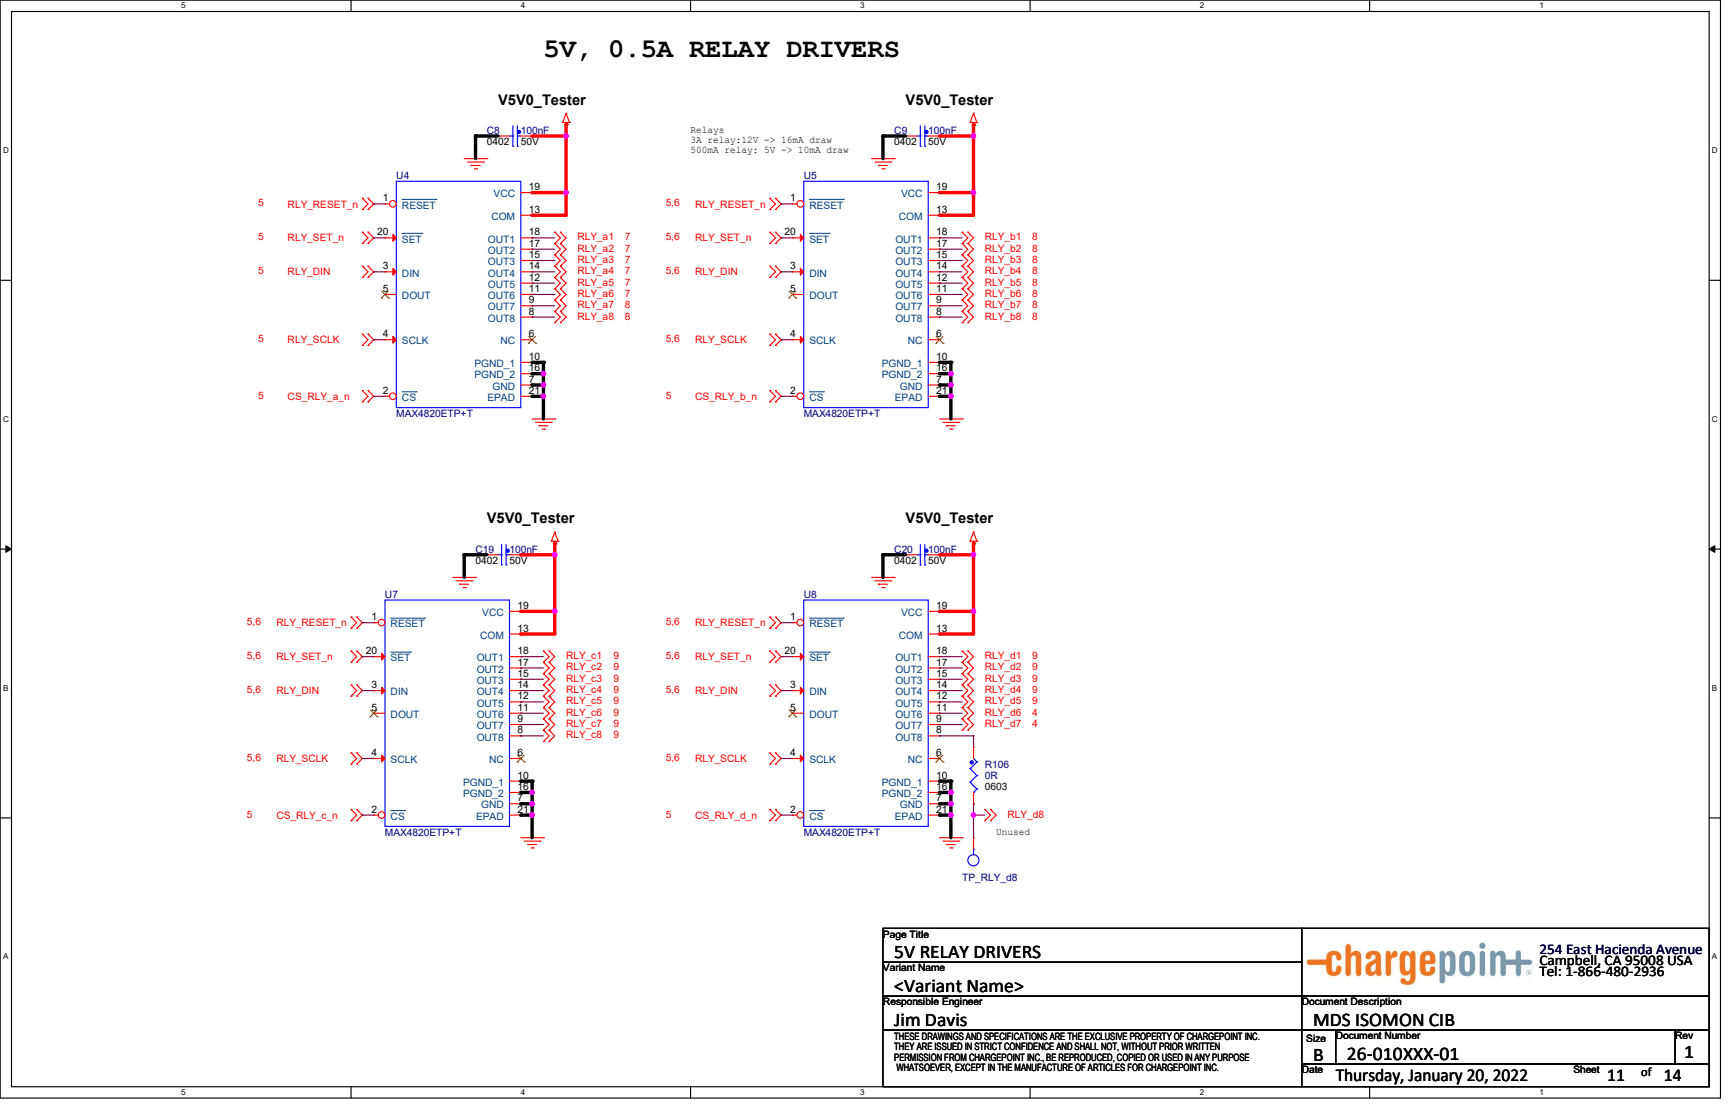
[picture p30: page 11]
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

# 12V, 3A RELAY DRIVERS

## V12V_Tester

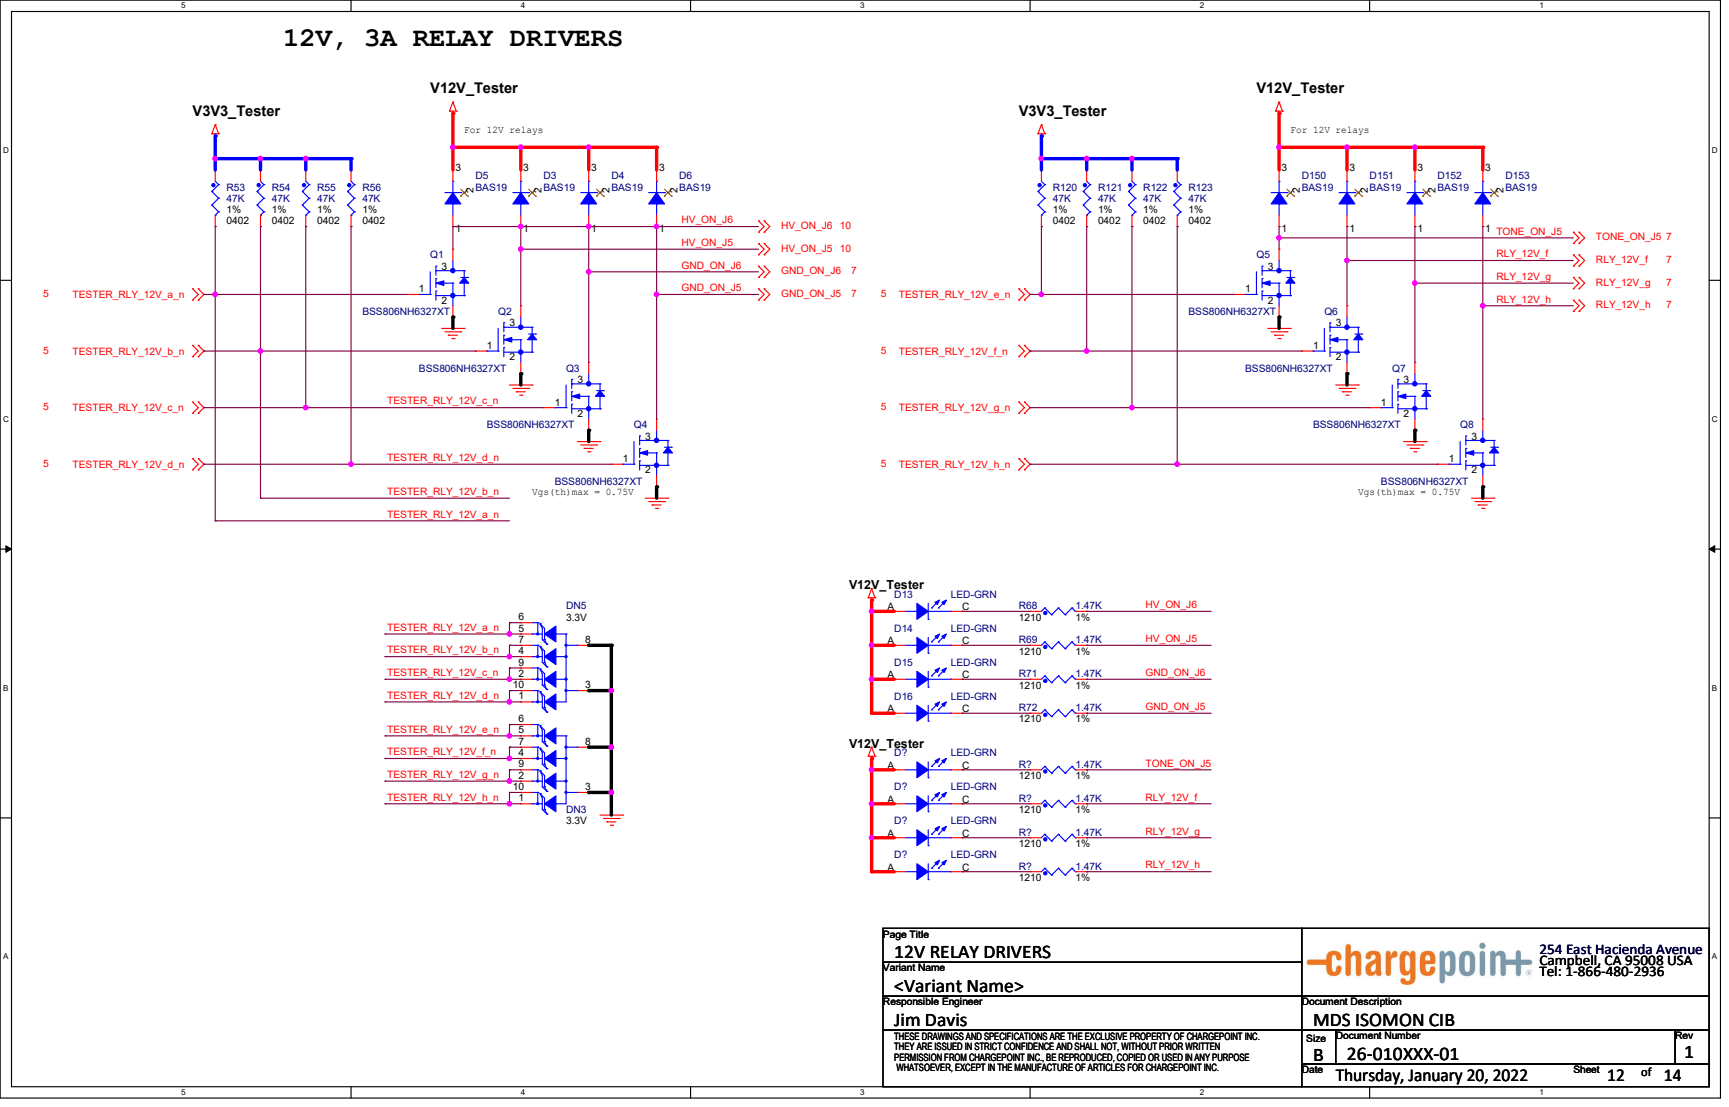
[picture p31: page 12]
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

CABLE 1 CONTACTOR CNTRL | CABLE 2 CONTACTOR CNTRL | CABLE 3 CONTACTOR CNTRL PLACE P11 ON SOLDER SIDE,

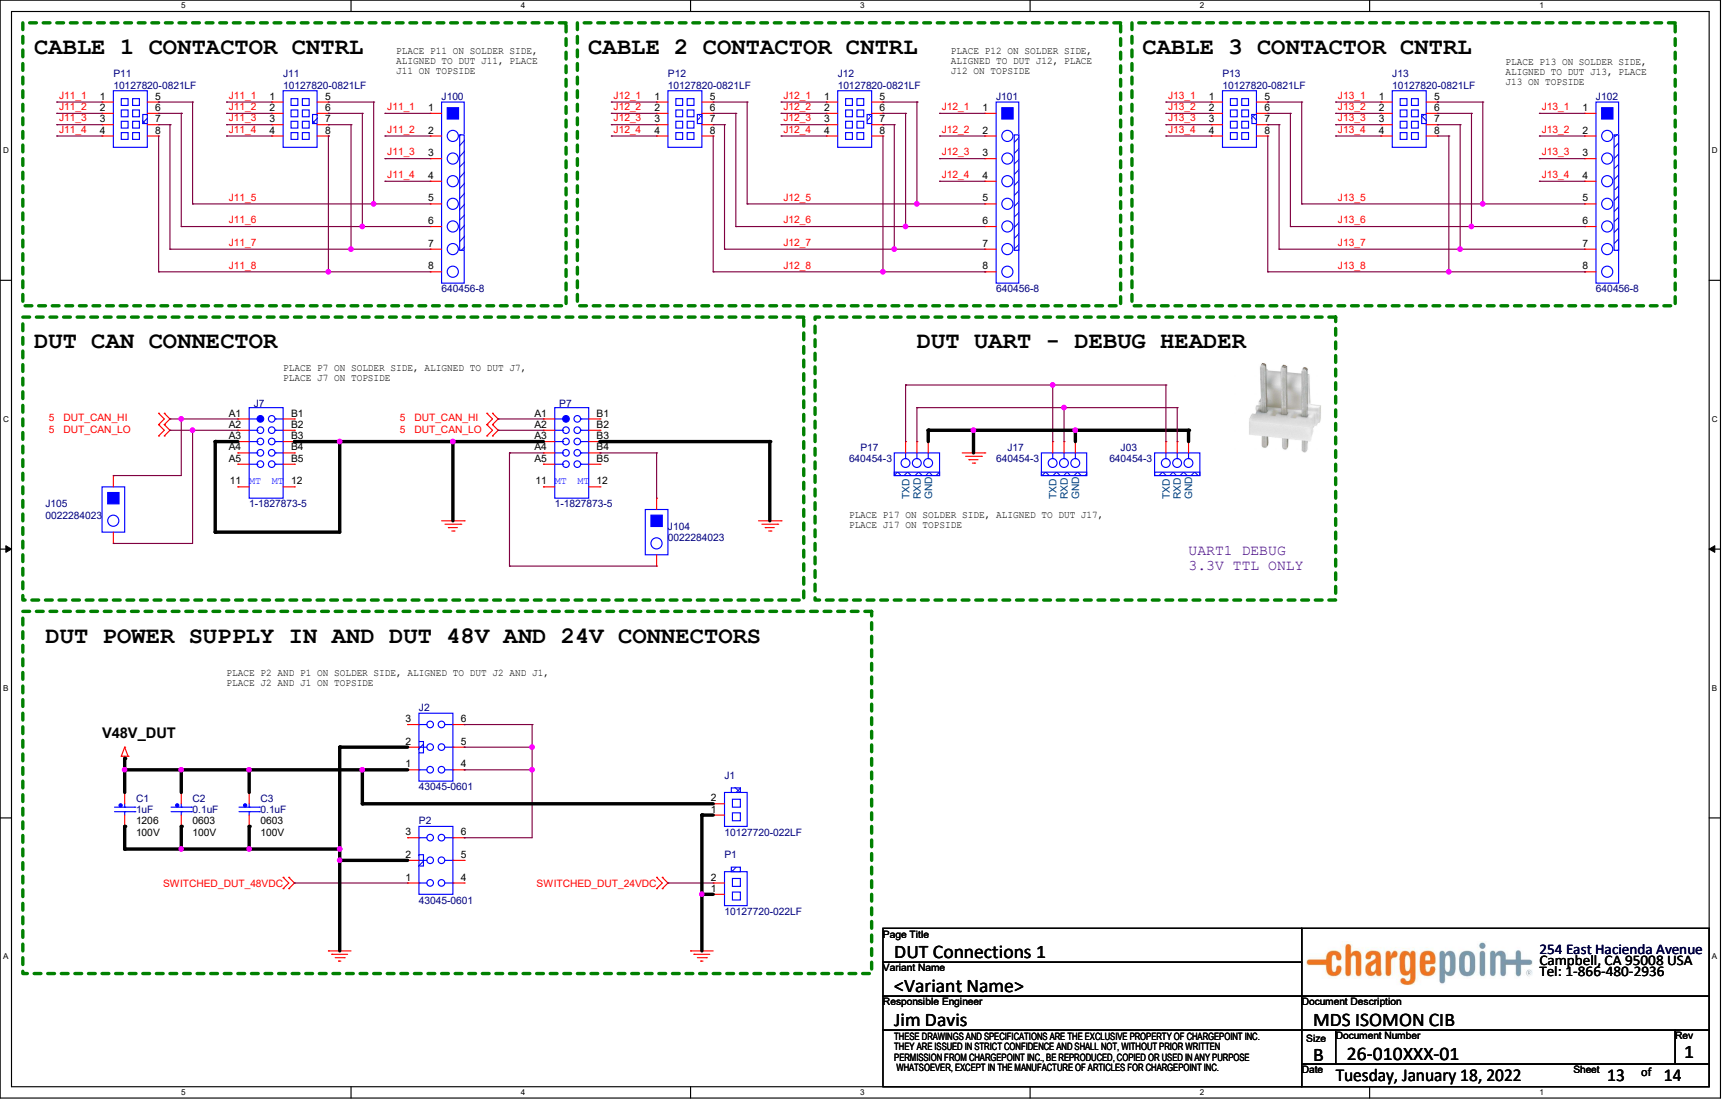
[picture p32: page 13]

ALIGNED TO DUT J11, PLACE
J11 ON TOPSIDE

PLACE P12 ON SOLDER SIDE,
ALIGNED TO DUT J12, PLACE
J12 ON TOPSIDE

PLACE P13 ON SOLDER SIDE,
ALIGNED TO DUT J13, PLACE
J13 ON TOPSIDE

DUT UART - DEBUG HEADER

PLACE P17 ON SOLDER SIDE, ALIGNED TO DUT J17,
PLACE J17 ON TOPSIDE

DUT POWER SUPPLY IN AND DUT 48V AND 24V CONNECTORS

PLACE P2 AND P1 ON SOLDER SIDE, ALIGNED TO DUT J2 AND J1,
PLACE J2 AND J1 ON TOPSIDE

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

# CABLE 1 THERMAL SWITCH INPUT

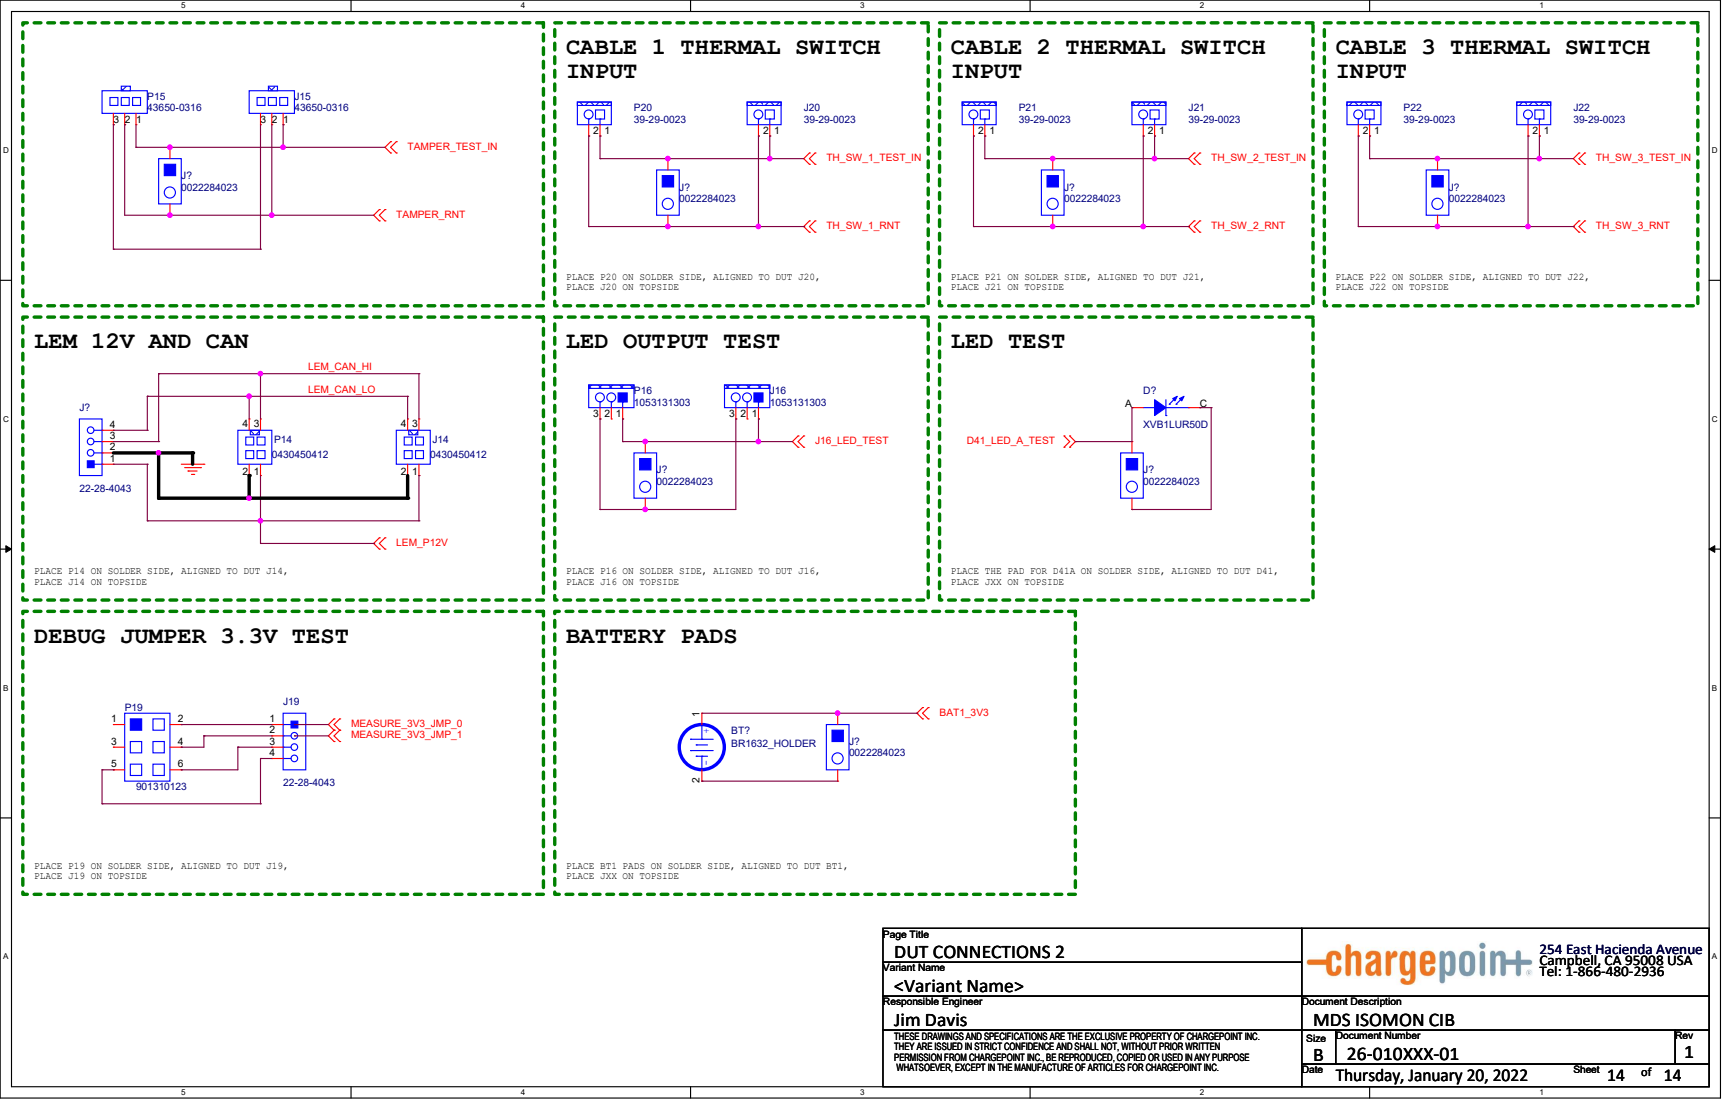
[picture p33: page 14]

PLACE P20 ON SOLDER SIDE, ALIGNED TO DUT J20,
PLACE J20 ON TOPSIDE

PLACE P21 ON SOLDER SIDE, ALIGNED TO DUT J21,
PLACE J21 ON TOPSIDE
LED TEST

PLACE P22 ON SOLDER SIDE, ALIGNED TO DUT J22,
PLACE J22 ON TOPSIDE

PLACE P14 ON SOLDER SIDE, ALIGNED TO DUT J14,
PLACE J14 ON TOPSIDE
DEBUG JUMPER 3.3V TEST

PLACE P16 ON SOLDER SIDE, ALIGNED TO DUT J16,
PLACE J16 ON TOPSIDE
BATTERY PADS

PLACE THE PAD FOR D41A ON SOLDER SIDE, ALIGNED TO DUT D41,
PLACE JXX ON TOPSIDE

PLACE P19 ON SOLDER SIDE, ALIGNED TO DUT J19,
PLACE J19 ON TOPSIDE

PLACE BT1 PADS ON SOLDER SIDE, ALIGNED TO DUT BT1,

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
