philipmcgaw-cpi/CIB/(list of files, drawings)

Other design files:
CIB_Main_PCB - Mimic Octopus/Freerouting/CIB_Main_PCB.dsn
