philipmcgaw-cpi/CIB/CIB_ISOMON_PCB - blue-ringed octopus/CIB_ISOMON_PCB.kicad_pcb

## KiCad design CIB_ISOMON_PCB - blue-ringed octopus/CIB_ISOMON_PCB.kicad_pcb (2022-06-27)

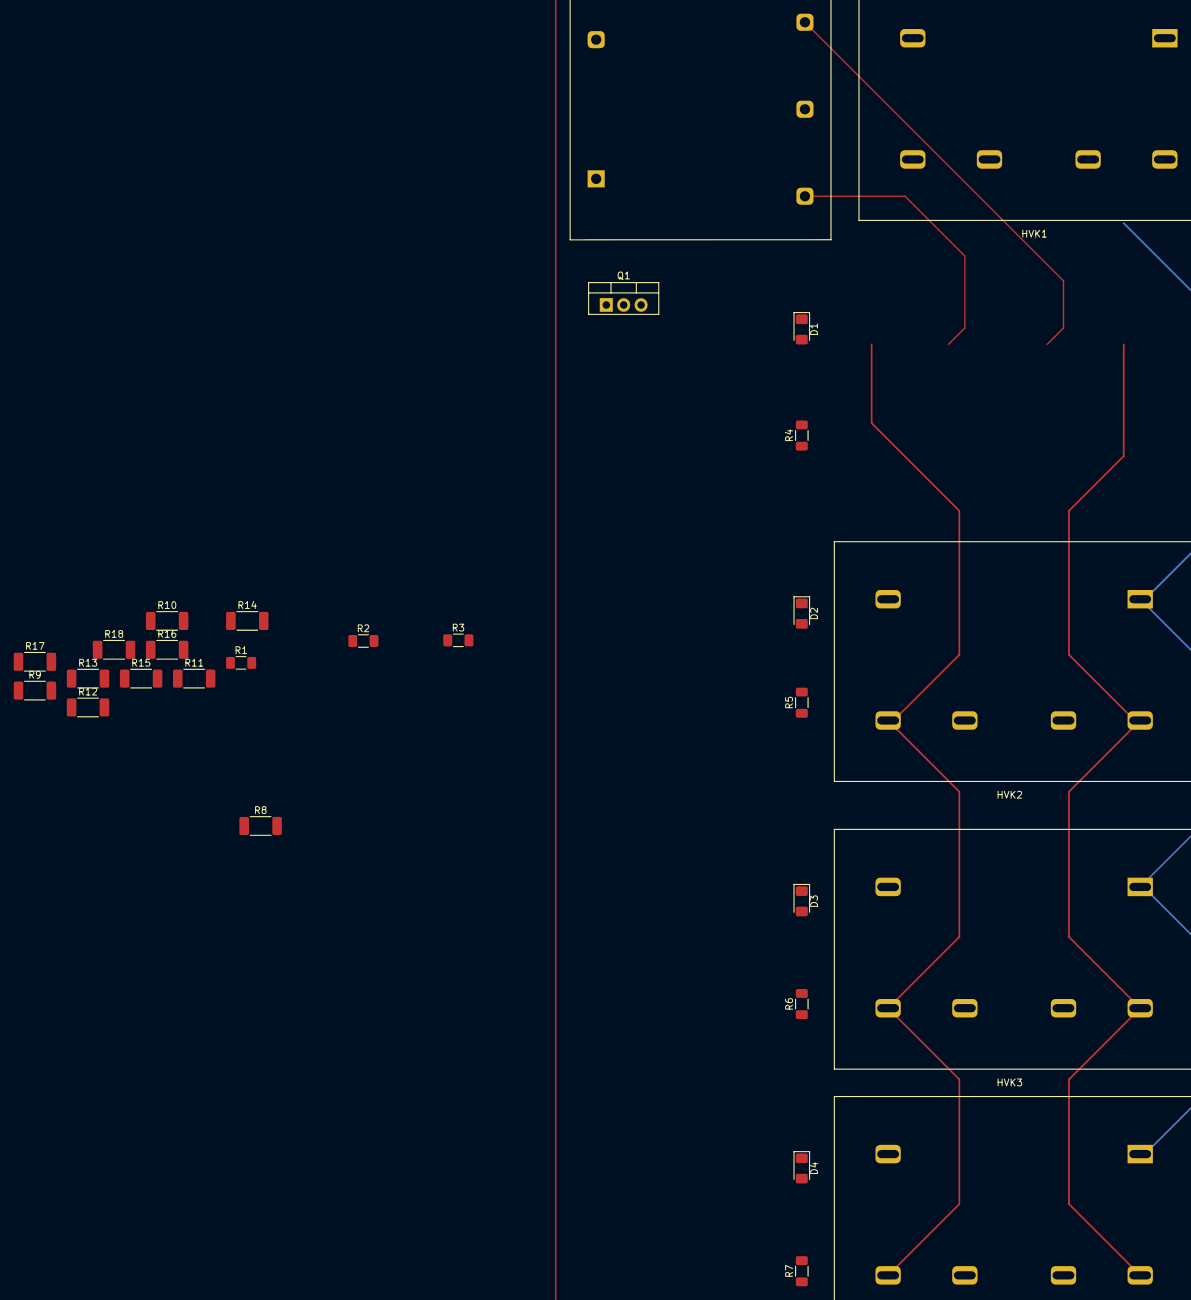
[picture p34: board CIB_ISOMON_PCB.kicad_pcb from above]

Board: 2 copper layers, 28 parts (0 on the bottom side), 25 nets.

Parts:
D1, D2, D3, D4: Red; D_1206_3216Metric_Pad1.42x1.75mm_HandSolder
HVK1, HVK2, HVK3: G7L-2A-X_DC12
HVK4: Connectors:G7L-2A-X_DC12; G7L-2A-X_DC12
PSU1: DC-HVDC_G10; DC-HVDC Converter G10
Q1: TIP127; TO-220-3_Vertical
R1, R2, R3: 470; R_1206_3216Metric_Pad1.30x1.75mm_HandSolder
R4, R5, R6, R7: 1k2; R_1206_3216Metric_Pad1.30x1.75mm_HandSolder
R8, R9, R10, R11, R12, R14, R15, R16, R17, R18: 1M; R_2010_5025Metric_Pad1.40x2.65mm_HandSolder
R13: 0; R_2010_5025Metric_Pad1.40x2.65mm_HandSolder

Connections:
+12V: HVK1.0, HVK2.0, HVK3.0, HVK4.0, Q1.2 (C), R4.1, R5.1, R6.1, R7.1
/HV ISOMON +VE: HVK1.8, HVK2.8, HVK3.8, HVK4.8, R8.1
/HV ISOMON -VE: HVK1.2, HVK2.2, HVK3.2, HVK4.2, R14.1
/HV PSU +Ve: PSU1.1 (+Vin), Q1.3 (E), R3.1
/HV PSU OP+: HVK1.6, PSU1.3 (+Vout)
/HV PSU OP-: HVK1.4, PSU1.4 (-Vout)
/HVK1: D1.1 (K), HVK1.1
/HVK2: D2.1 (K), HVK2.1
/HVK3: D3.1 (K), HVK3.1
/HVK4: D4.1 (K), HVK4.1
GND: PSU1.2 (-Vin), PSU1.5 (0V), R2.2, R3.2, R13.2
unnamed: D1.2 (A), R4.2
unnamed: D2.2 (A), R5.2
unnamed: D3.2 (A), R6.2
unnamed: D4.2 (A), R7.2
unnamed: R1.1, R2.1
unnamed: R8.2, R9.1
unnamed: R9.2, R10.1
unnamed: R10.2, R11.1
unnamed: R11.2, R12.1
unnamed: R12.2, R13.1, R18.2
unnamed: R14.2, R15.1
unnamed: R15.2, R16.1
unnamed: R16.2, R17.1
unnamed: R17.2, R18.1
