philipmcgaw-cpi/CIB/(commit log)

2022-06-28 added snubbing to the relays
    [CIB PSU.kicad_sch, CIB_Main_PCB.dsn, CIB_Main_PCB.kicad_sch, DUT Power.kicad_sch, MicroControler Interface.kicad_sch, misc relays.kicad_sch]
2022-06-28 named folders with animal names
    [Bom.xlsx, CIB PSU.kicad_sch, CIB_Contactors_PCB.kicad_pcb, CIB_Contactors_PCB.kicad_sch, CIB_ISOMON_PCB.kicad_pcb, CIB_ISOMON_PCB.kicad_sch, CIB_Main_PCB.csv, CIB_Main_PCB.dsn]
2022-06-29 Added revision resistors
2022-06-30 added version resistors
    [CIB_Main_PCB.kicad_sch, MicroControler Interface.kicad_sch, misc relays.kicad_sch]
2022-07-08 added changes
    [CIB PSU.kicad_sch, CIB_Main_PCB.kicad_sch, Cross Point Matix Ch1-4.kicad_sch, Cross Point Matix Ch17-24.kicad_sch, Cross Point Matix Ch5-16.kicad_sch, Cross Point Matrix 8 Relays (High Current).kicad_sch, Cross Point Matrix 8 Relays (Low Current).kicad_sch, Cross Point Matrix 8 Relays (Med Current).kicad_sch]
2022-07-12 V0.1 PCB to be sent out
    [CIB PSU.kicad_sch, CIB_Main_PCB.kicad_sch, Cross Point Matix Ch17-24.kicad_sch, Cross Point Matrix.kicad_sch, DUT Power.kicad_sch, External Equipment Connections.kicad_sch, MicroControler Interface.kicad_sch, misc relays.kicad_sch]
2022-07-13 Generated Bom, and cleaned up layers.
2022-07-13 export bom csv
    [CIB_Main_PCB.csv]
